paulcombuse/BadmintonAce/documentation/img/Grip+Pull_Concept_1.png

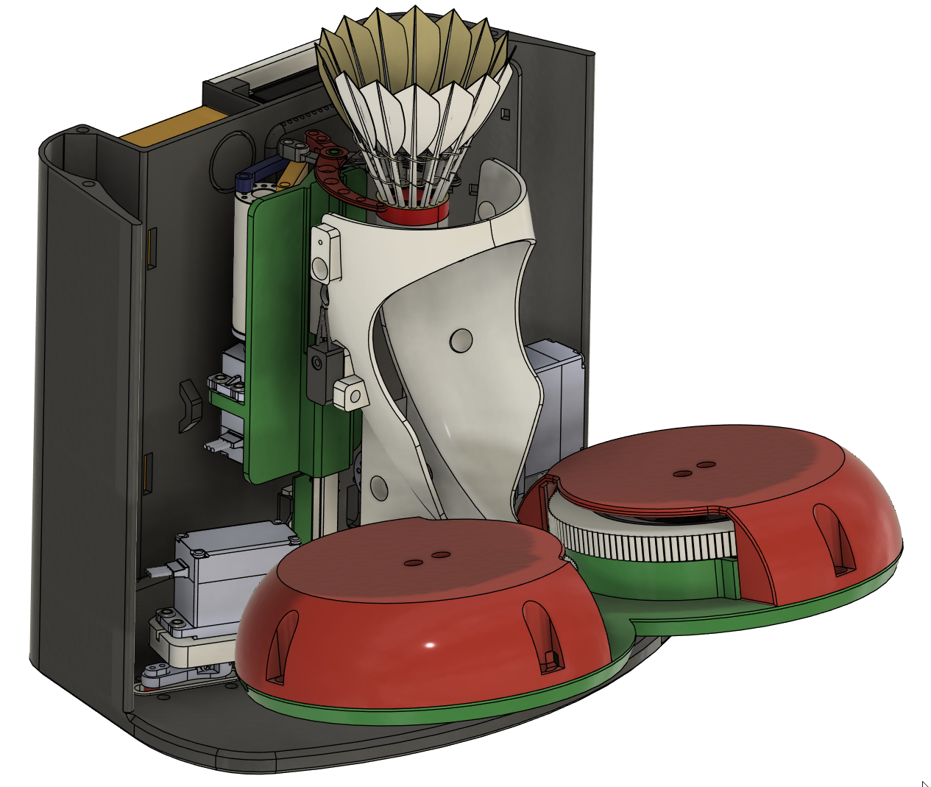
documentation/img/Grip+Pull_Concept_1.png
