paulcombuse/BadmintonAce/documentation/img/Illustration-1.png

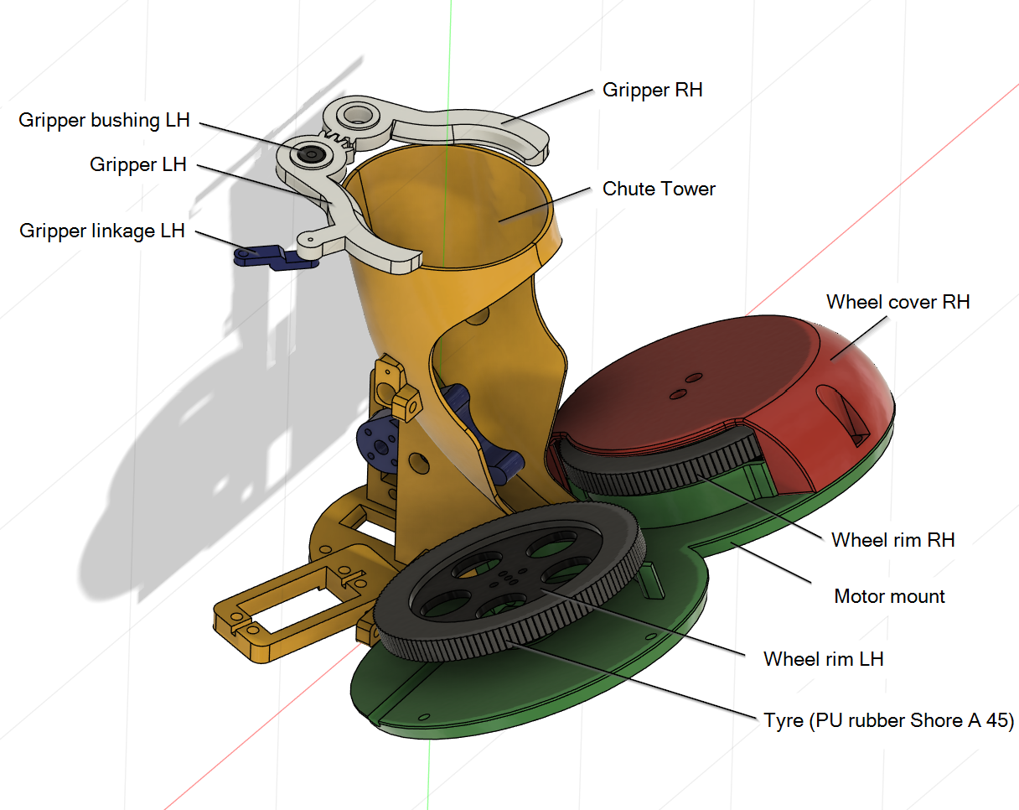
documentation/img/Illustration-1.png
