paulcombuse/BadmintonAce/documentation/img/Illustration-2.png

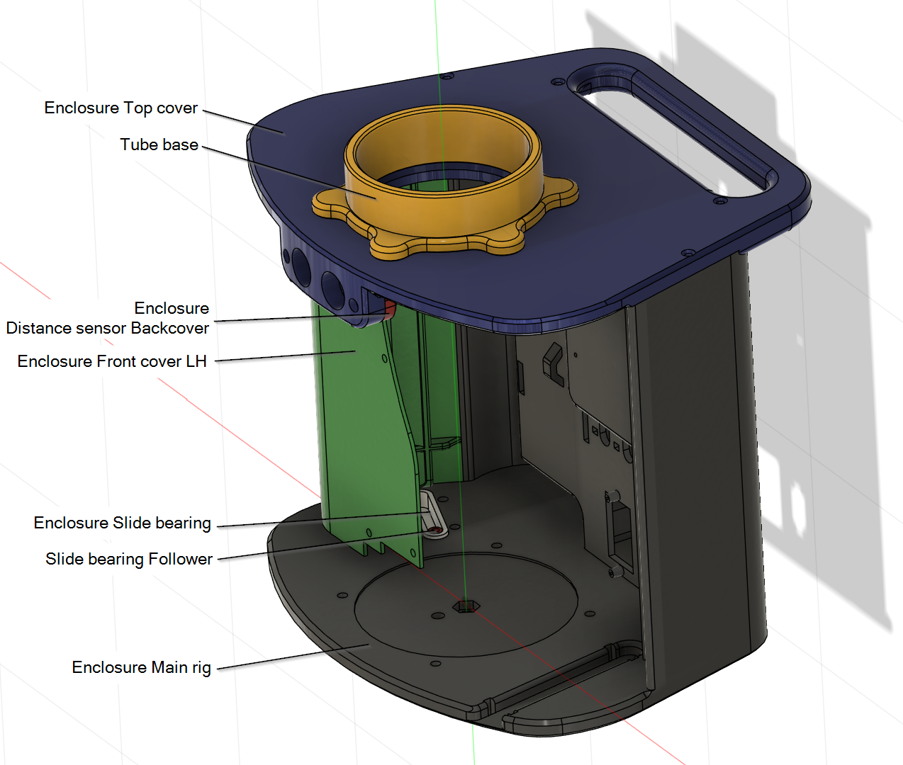
documentation/img/Illustration-2.png
