paulcombuse/BadmintonAce/documentation/img/Illustration_Overview_Backview.png

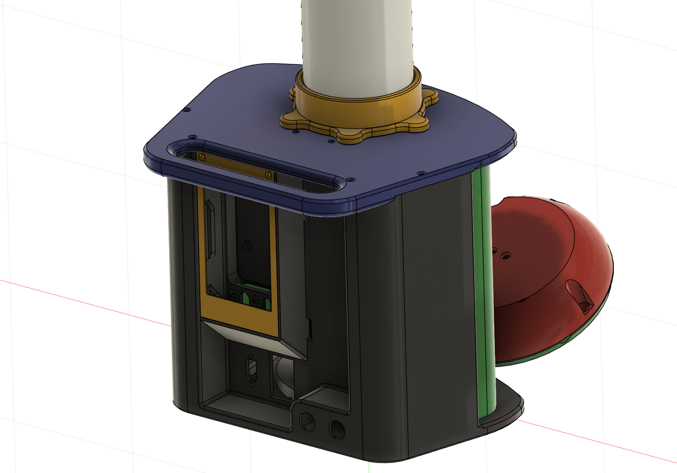
documentation/img/Illustration_Overview_Backview.png
