paulcombuse/BadmintonAce/documentation/img/Illustration_Overview_Frontview.png

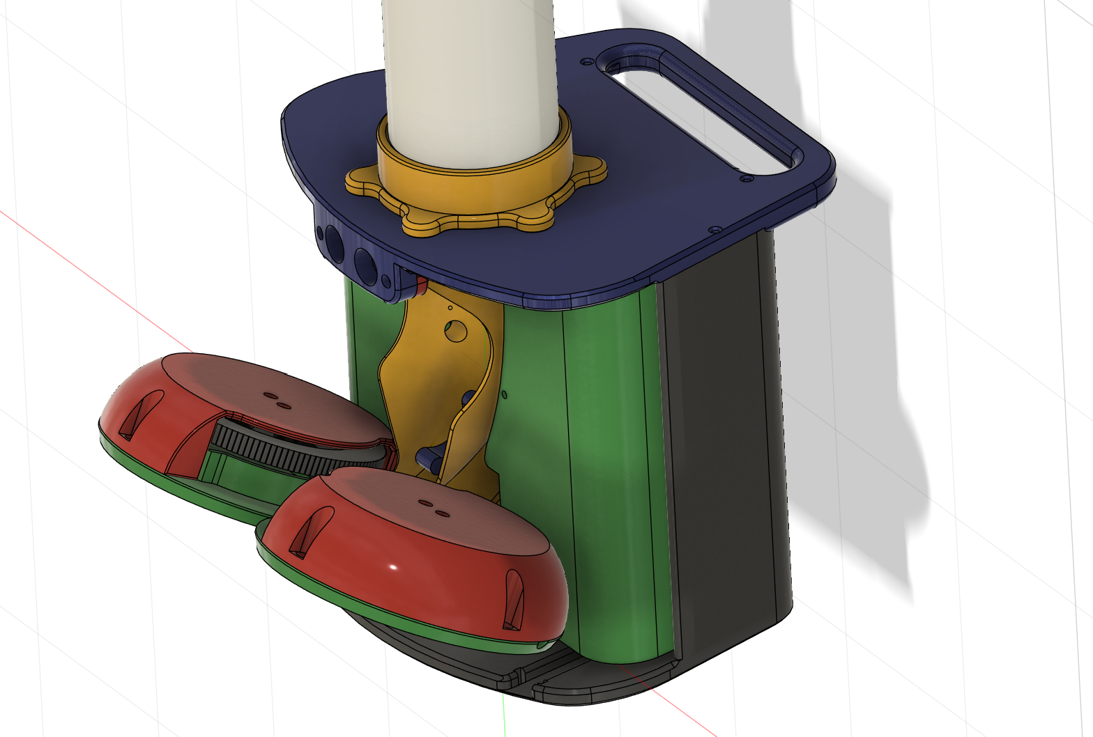
documentation/img/Illustration_Overview_Frontview.png
