paulcombuse/BadmintonAce/documentation/img/OtherConcepts/Siboasi_S4025_6.jpg

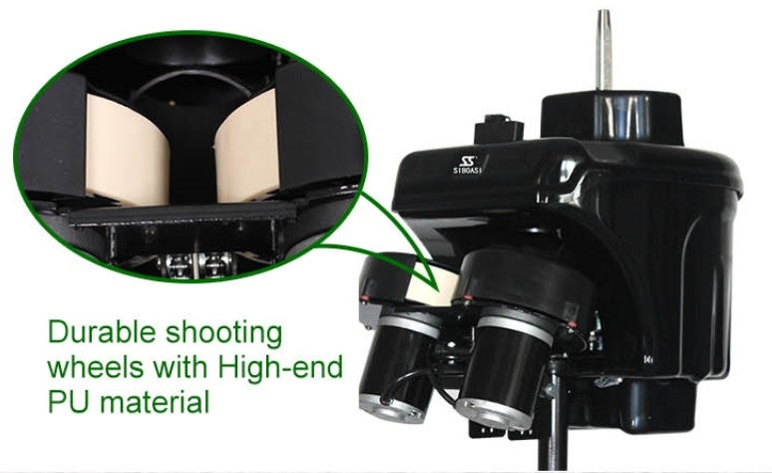
documentation/img/OtherConcepts/Siboasi_S4025_6.jpg
