paulcombuse/BadmintonAce/documentation/img/OtherConcepts/Siboasi_SS_B7_VideoSnapshot-2.png

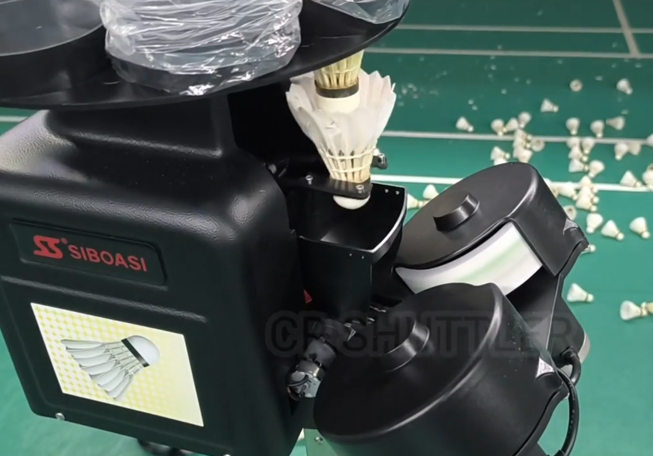
documentation/img/OtherConcepts/Siboasi_SS_B7_VideoSnapshot-2.png
