paulcombuse/BadmintonAce/documentation/img/PeterSinclair'sBadmintonACE/01.jpg

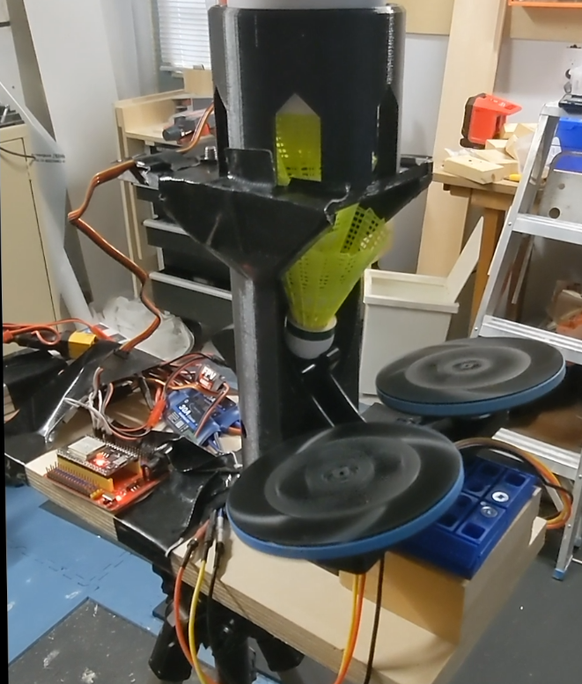
documentation/img/PeterSinclair'sBadmintonACE/01.jpg
