paulcombuse/BadmintonAce/documentation/img/PeterSinclair'sBadmintonACE/02.jpg

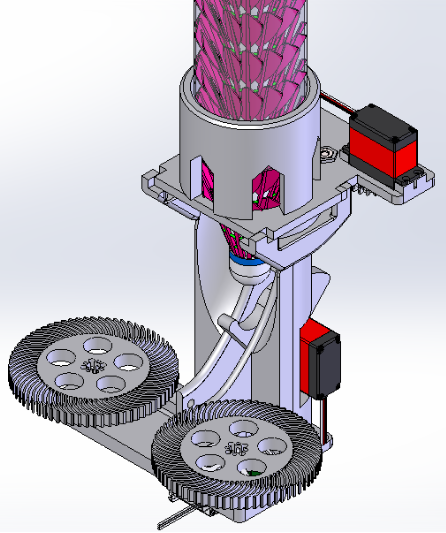
documentation/img/PeterSinclair'sBadmintonACE/02.jpg
