paulcombuse/BadmintonAce/documentation/img/PeterSinclair'sBadmintonACE/03.jpg

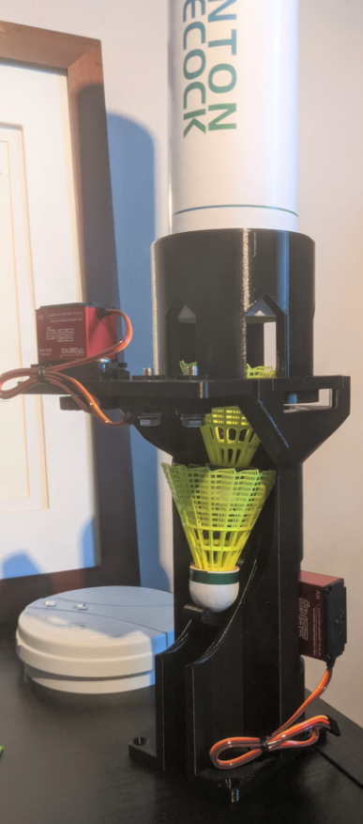
documentation/img/PeterSinclair'sBadmintonACE/03.jpg
