paulcombuse/BadmintonAce/documentation/img/PeterSinclair'sBadmintonACE/04.jpg

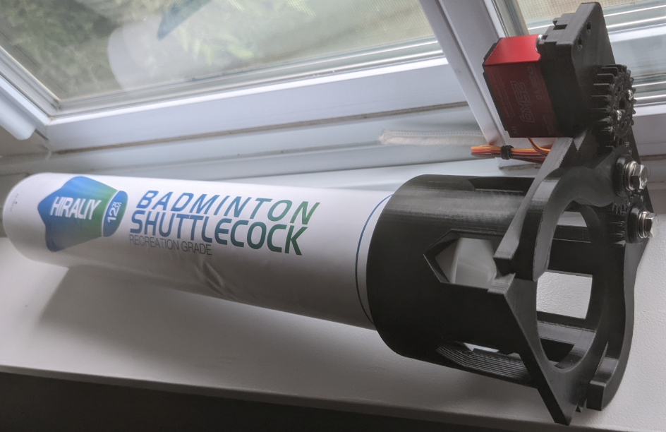
documentation/img/PeterSinclair'sBadmintonACE/04.jpg
