paulcombuse/BadmintonAce/documentation/img/PeterSinclair'sBadmintonACE/05.jpg

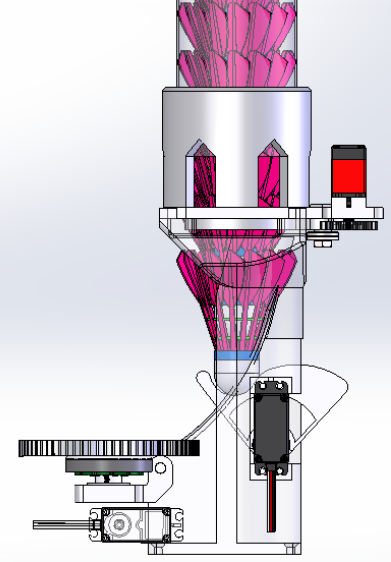
documentation/img/PeterSinclair'sBadmintonACE/05.jpg
