paulcombuse/BadmintonAce/documentation/img/PeterSinclair'sBadmintonACE/06.jpg

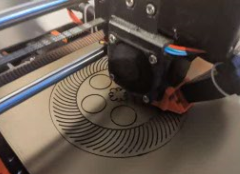
documentation/img/PeterSinclair'sBadmintonACE/06.jpg
