paulcombuse/BadmintonAce/documentation/img/PeterSinclair'sBadmintonACE/07.jpg

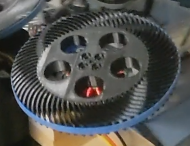
documentation/img/PeterSinclair'sBadmintonACE/07.jpg
