paulcombuse/BadmintonAce/documentation/img/PeterSinclair'sBadmintonACE/08.jpg

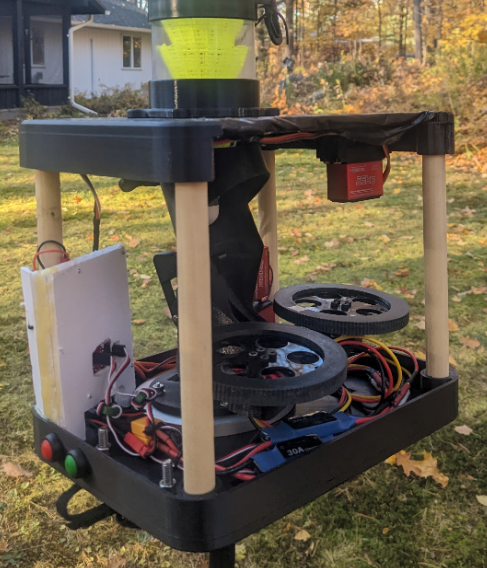
documentation/img/PeterSinclair'sBadmintonACE/08.jpg
