paulcombuse/BadmintonAce/documentation/img/PeterSinclair'sBadmintonACE/09.jpg

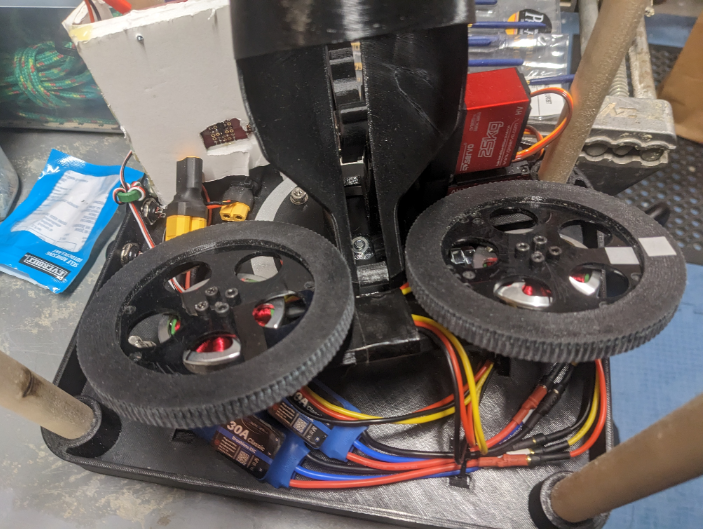
documentation/img/PeterSinclair'sBadmintonACE/09.jpg
