paulcombuse/BadmintonAce/documentation/img/PeterSinclair'sBadmintonACE/10.jpg

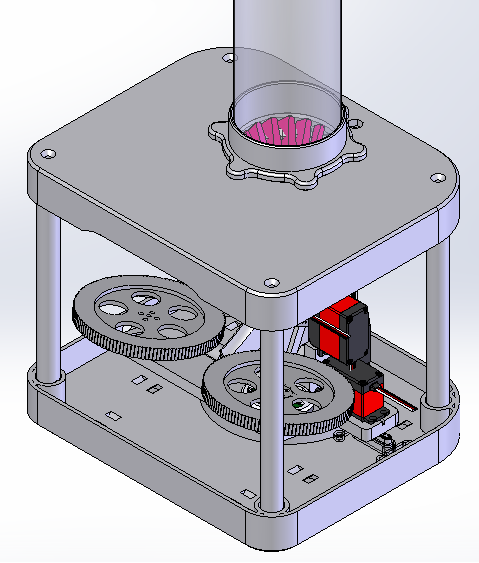
documentation/img/PeterSinclair'sBadmintonACE/10.jpg
