paulcombuse/BadmintonAce/documentation/img/PeterSinclair'sBadmintonACE/11.jpg

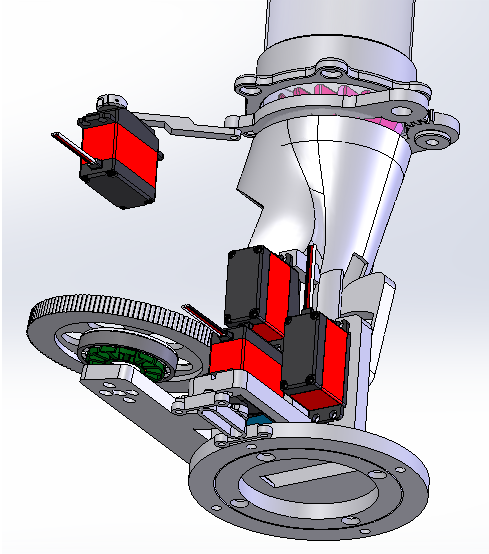
documentation/img/PeterSinclair'sBadmintonACE/11.jpg
