paulcombuse/BadmintonAce/documentation/img/PeterSinclair'sBadmintonACE/12.jpg

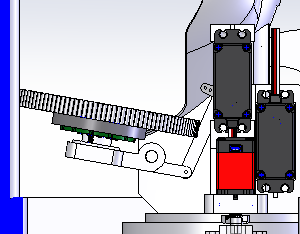
documentation/img/PeterSinclair'sBadmintonACE/12.jpg
