paulcombuse/BadmintonAce/documentation/img/PeterSinclair'sBadmintonACE/13.jpg

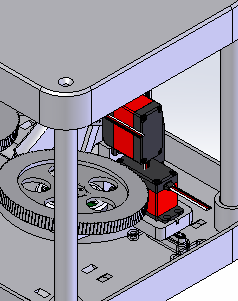
documentation/img/PeterSinclair'sBadmintonACE/13.jpg
