paulcombuse/BadmintonAce/documentation/img/PeterSinclair'sBadmintonACE/14.jpg

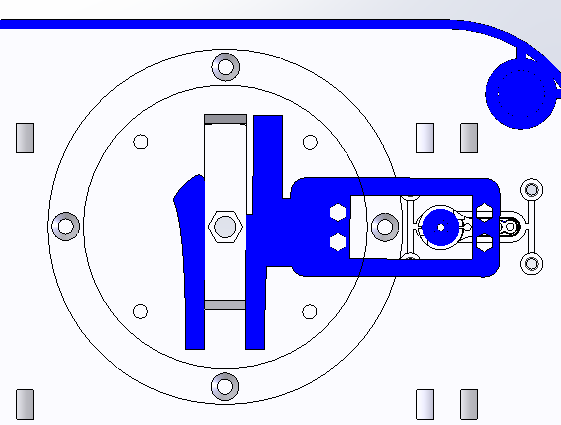
documentation/img/PeterSinclair'sBadmintonACE/14.jpg
