paulcombuse/BadmintonAce/documentation/img/PeterSinclair'sBadmintonACE/15.jpg

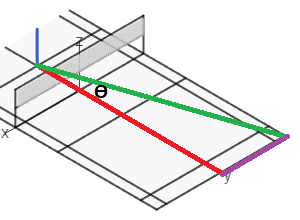
documentation/img/PeterSinclair'sBadmintonACE/15.jpg
