paulcombuse/BadmintonAce/documentation/img/PeterSinclair'sBadmintonACE/16.jpg

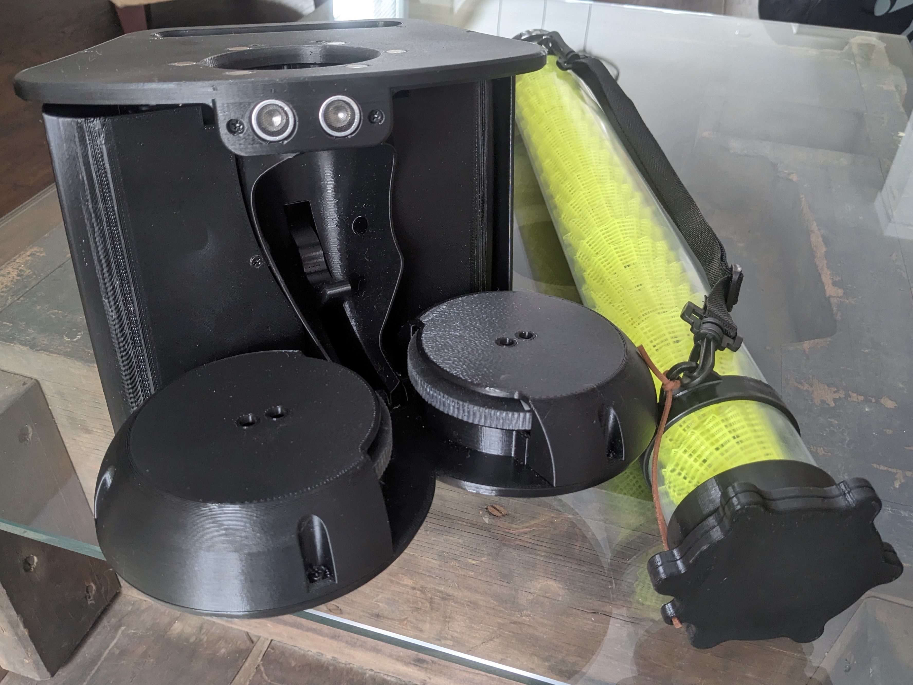
documentation/img/PeterSinclair'sBadmintonACE/16.jpg
