paulcombuse/BadmintonAce/documentation/img/PeterSinclair'sBadmintonACE/17.jpg

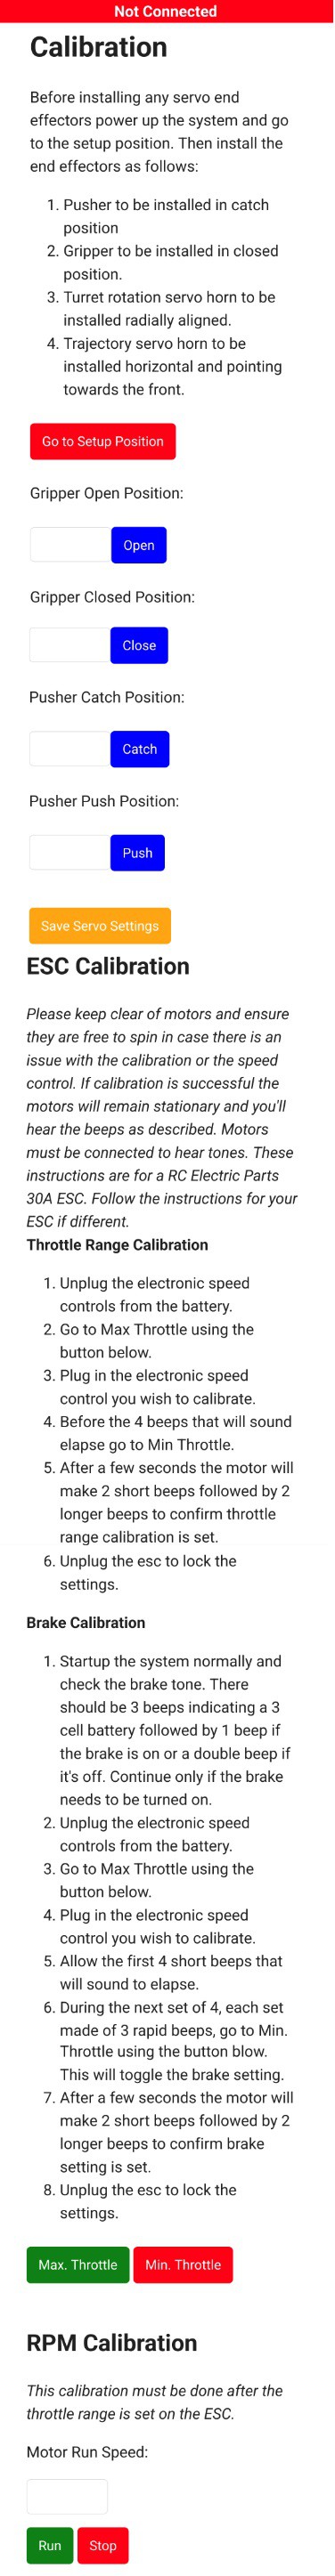
documentation/img/PeterSinclair'sBadmintonACE/17.jpg
