paulcombuse/BadmintonAce/documentation/img/PeterSinclair'sBadmintonACE/18.jpg

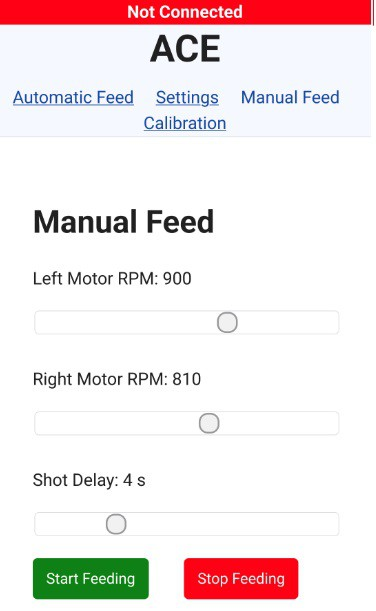
documentation/img/PeterSinclair'sBadmintonACE/18.jpg
