paulcombuse/BadmintonAce/documentation/img/PeterSinclair'sBadmintonACE/19.jpg

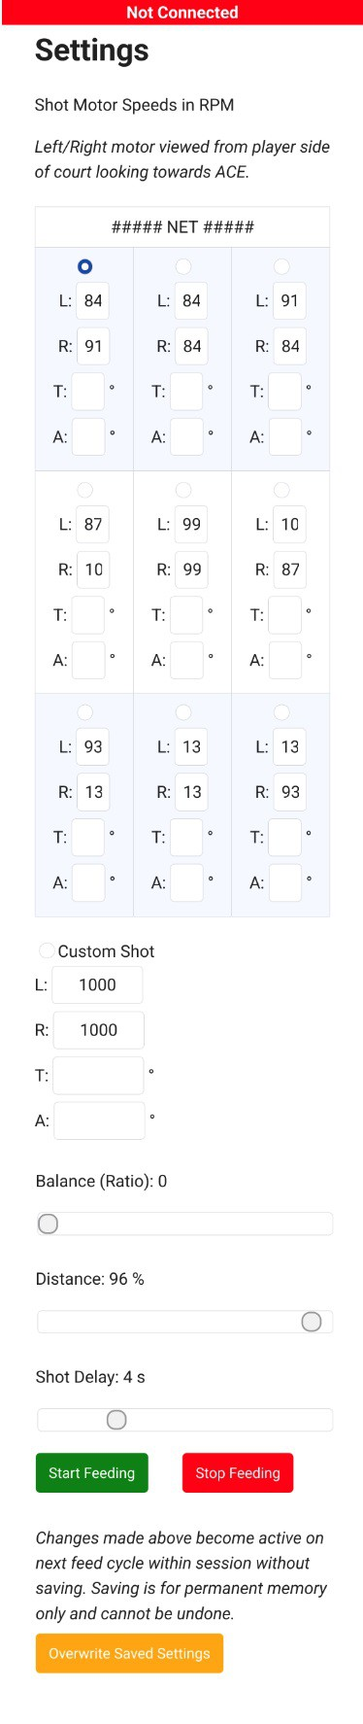
documentation/img/PeterSinclair'sBadmintonACE/19.jpg
