paulcombuse/BadmintonAce/documentation/img/PeterSinclair'sBadmintonACE/20.jpg

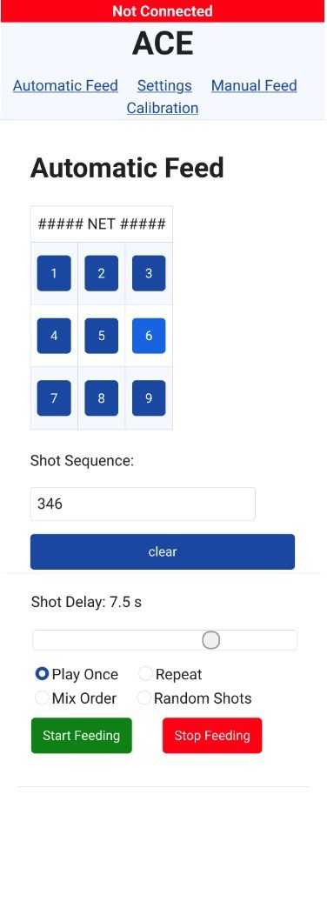
documentation/img/PeterSinclair'sBadmintonACE/20.jpg
