paulcombuse/BadmintonAce/documentation/img/PeterSinclair'sBadmintonACE/21.jpg

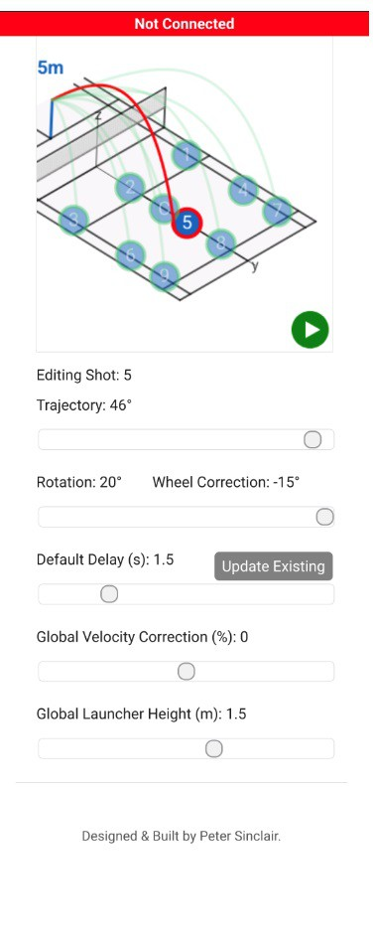
documentation/img/PeterSinclair'sBadmintonACE/21.jpg
