paulcombuse/BadmintonAce/documentation/img/PeterSinclair'sBadmintonACE/22.jpg

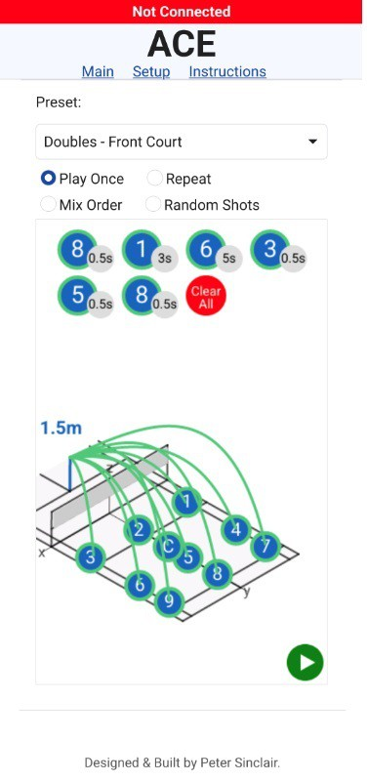
documentation/img/PeterSinclair'sBadmintonACE/22.jpg
