paulcombuse/BadmintonAce/documentation/img/PeterSinclair'sBadmintonACE/23.jpg

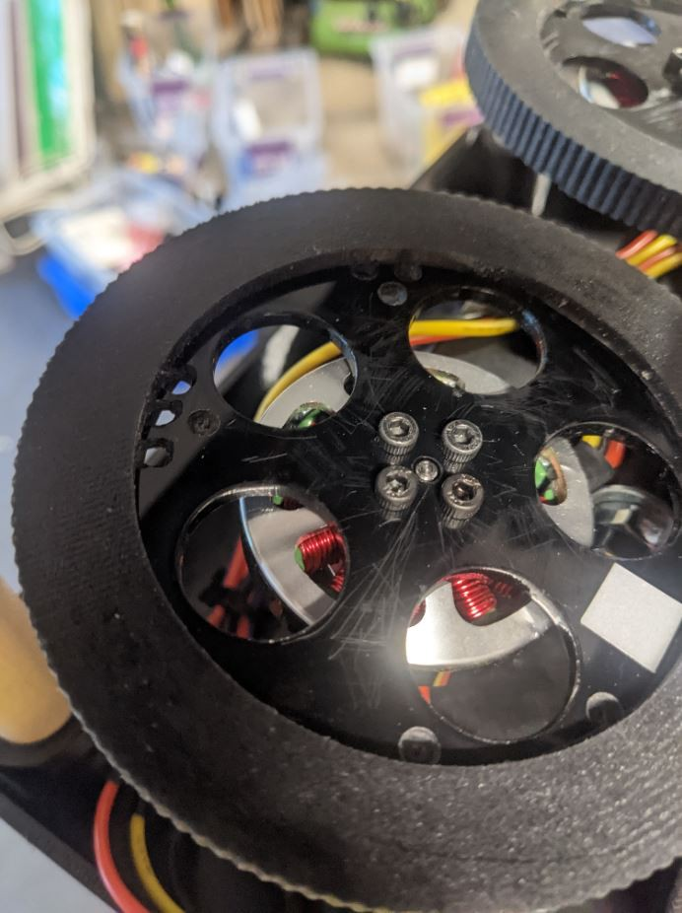
documentation/img/PeterSinclair'sBadmintonACE/23.jpg
