paulcombuse/BadmintonAce/documentation/img/PeterSinclair'sBadmintonACE/24.jpg

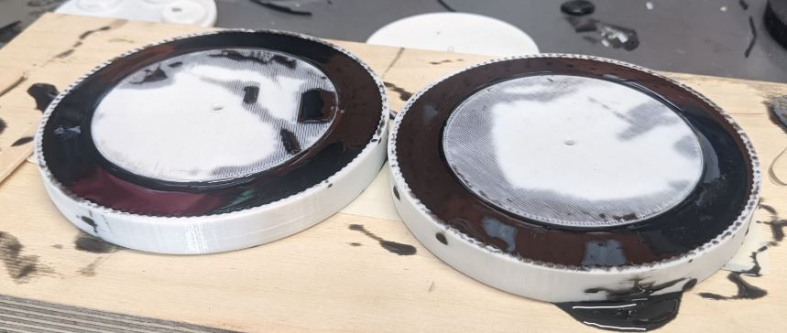
documentation/img/PeterSinclair'sBadmintonACE/24.jpg
