paulcombuse/BadmintonAce/documentation/img/PeterSinclair'sBadmintonACE/25.jpg

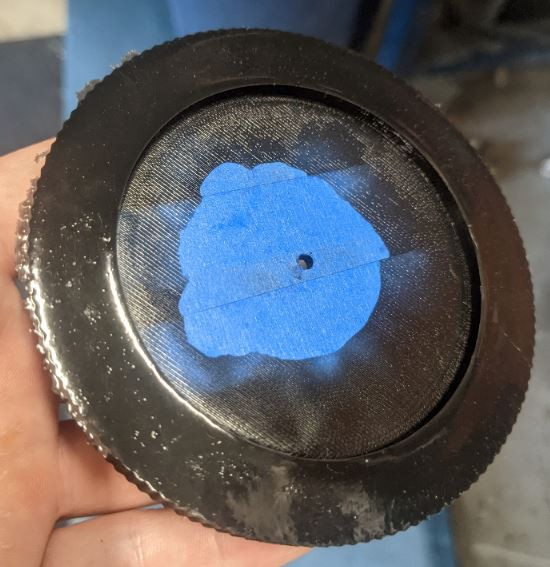
documentation/img/PeterSinclair'sBadmintonACE/25.jpg
