paulcombuse/BadmintonAce/documentation/img/PeterSinclair'sBadmintonACE/26.jpg

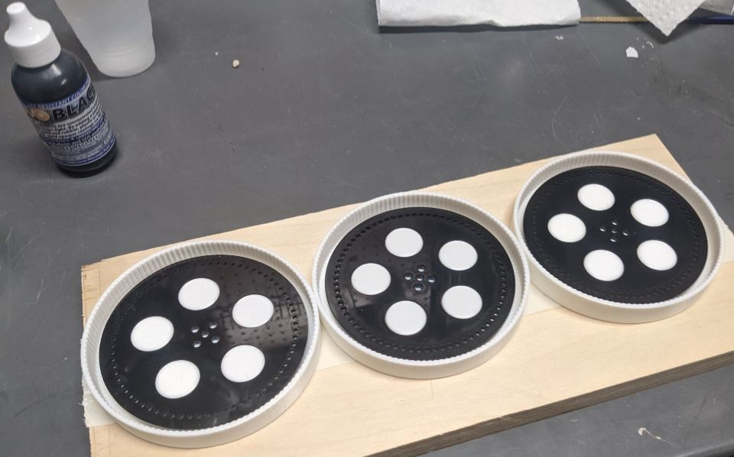
documentation/img/PeterSinclair'sBadmintonACE/26.jpg
