paulcombuse/BadmintonAce/cad/2x ACE_Wheel_Assembly_LH&RH_Rev2_2materials.step

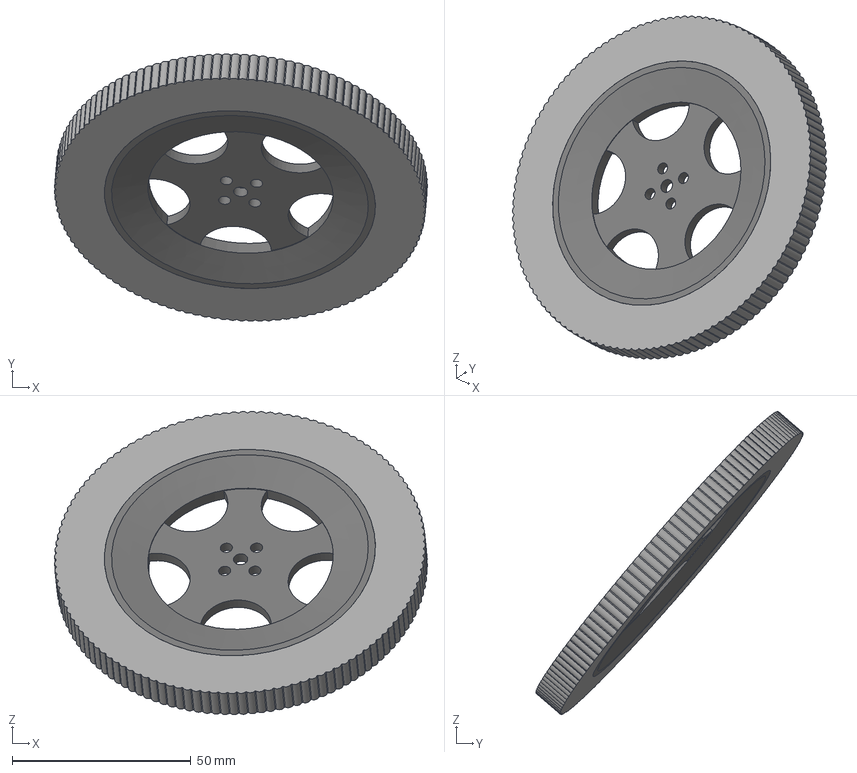
[picture p51: CAD file, 2026-11-03]
cad/2x ACE_Wheel_Assembly_LH&RH_Rev2_2materials.step
104.4 x 74.8 x 84.8 mm
