paulcombuse/BadmintonAce/cad/ACE D4 ASSEMBLY 2023-09-11.stl

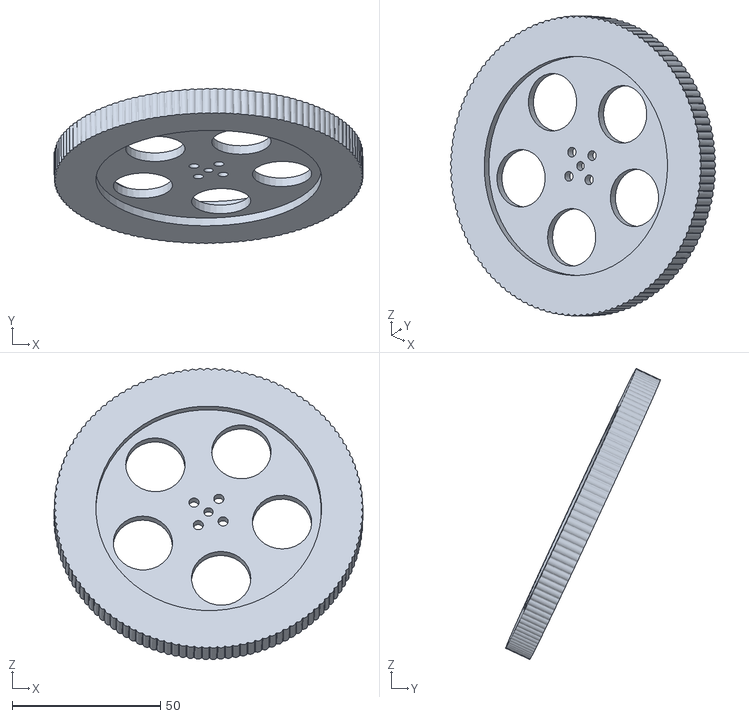
[picture p52: CAD file, 2026-11-03]
cad/ACE D4 ASSEMBLY 2023-09-11.stl
104.1 x 52.2 x 98.0
