paulcombuse/BadmintonAce/cad/ACE_Enclosure_MainRig_Rev3.step

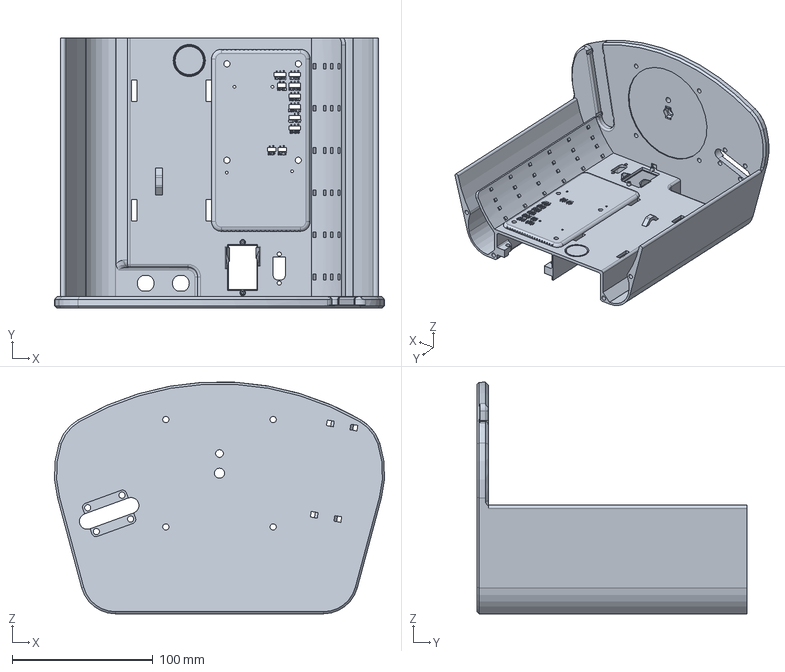
[picture p53: CAD file, 2026-11-03]
cad/ACE_Enclosure_MainRig_Rev3.step
234.7 x 192.0 x 164.8 mm
