paulcombuse/BadmintonAce/cad/ACE_Enclosure_TopCover_Rev3.step

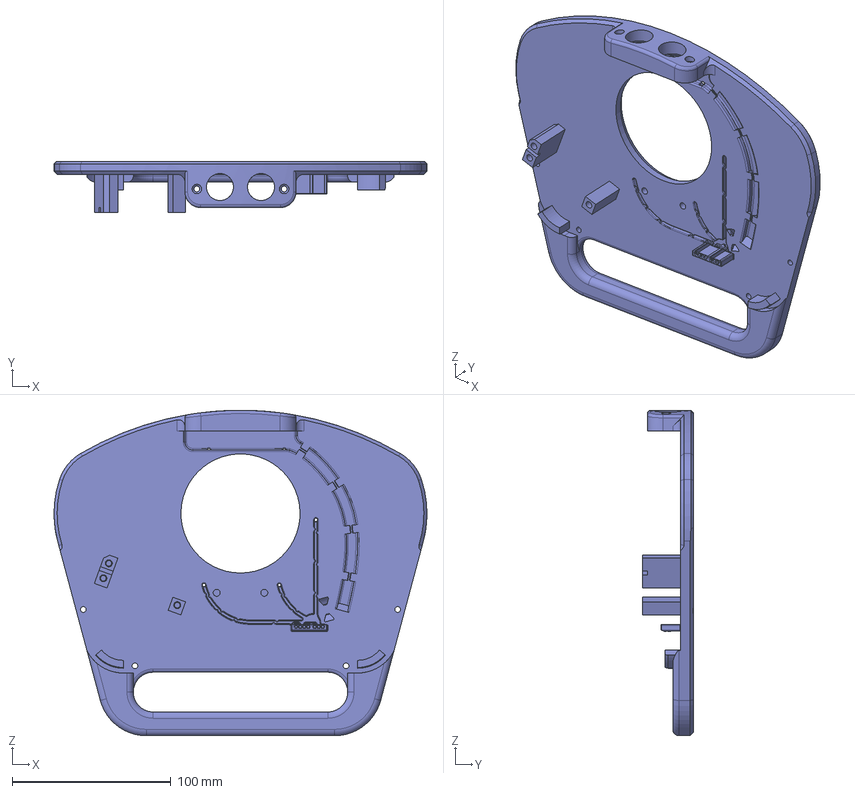
[picture p54: CAD file, 2026-11-13]
cad/ACE_Enclosure_TopCover_Rev3.step
235.0 x 32.0 x 205.0 mm
