paulcombuse/BadmintonAce/pcb/AdditionalParts/XT60PB-F.stp

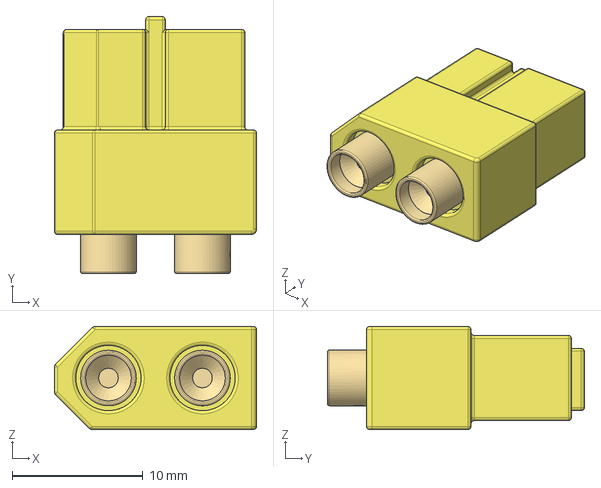
[picture p55: CAD file, 2026-11-08]
pcb/AdditionalParts/XT60PB-F.stp
15.5 x 19.7 x 7.90 mm
