paulcombuse/BadmintonAce/cad/ACE_Pusher_Rev3.step

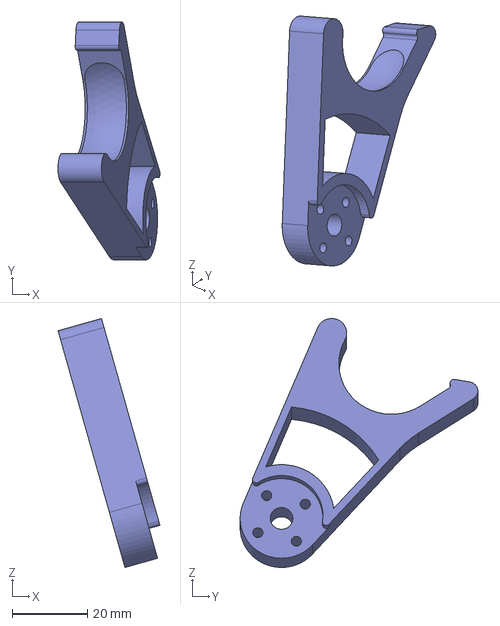
[picture p56: CAD file, 2026-11-13]
cad/ACE_Pusher_Rev3.step
27.1 x 63.1 x 66.1 mm
