paulcombuse/BadmintonAce/pcb/AdditionalParts/XT60PB-M.stp

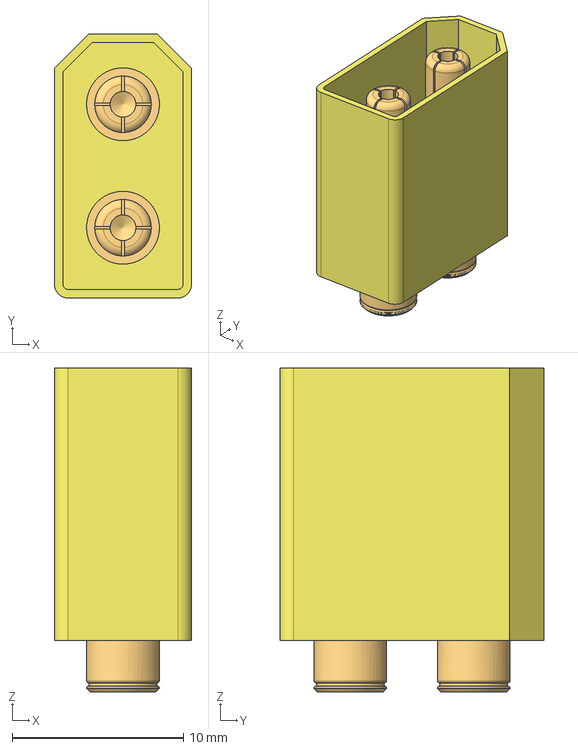
[picture p57: CAD file, 2026-11-08]
pcb/AdditionalParts/XT60PB-M.stp
8.00 x 15.4 x 18.9 mm
