paulcombuse/BadmintonAce/cad/ACE_Tube_Base_Rev2-illuminated_Insert_PullConcept.step

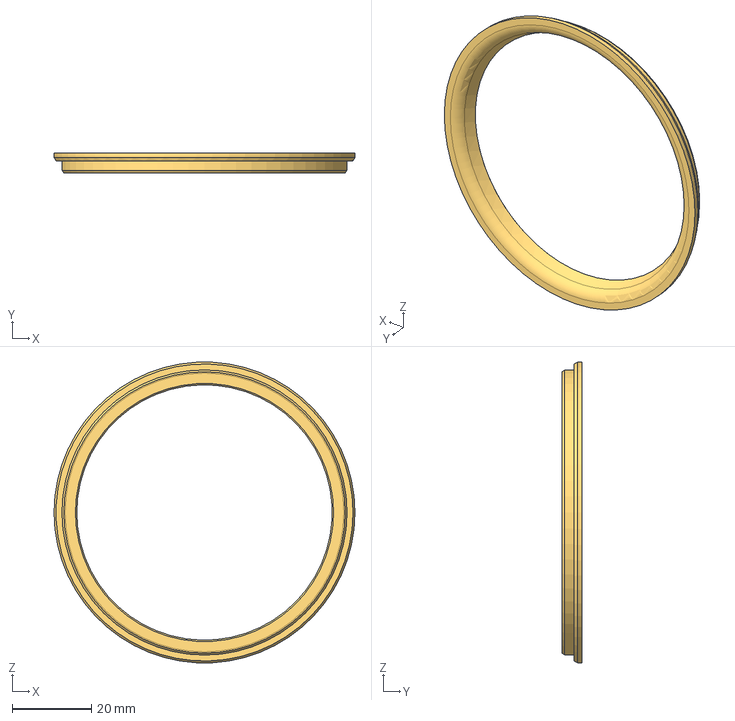
[picture p58: CAD file, 2026-11-08]
cad/ACE_Tube_Base_Rev2-illuminated_Insert_PullConcept.step
75.8 x 5.02 x 75.7 mm
