paulcombuse/BadmintonAce/cad/ACE_Tube_Base_Rev2-illuminated.step

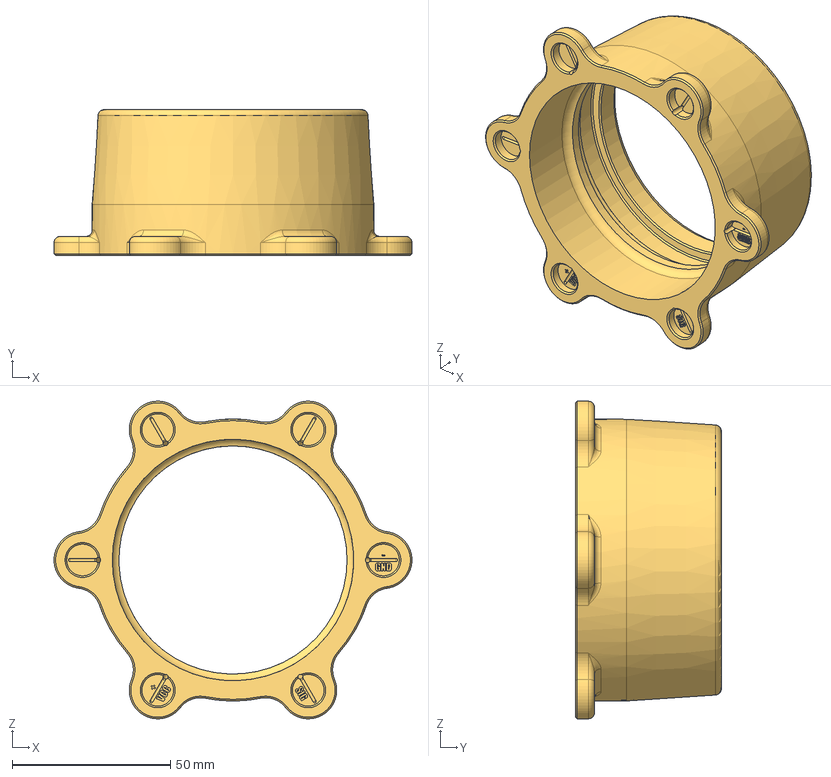
[picture p59: CAD file, 2026-11-08]
cad/ACE_Tube_Base_Rev2-illuminated.step
113.0 x 46.0 x 100.3 mm
