paulcombuse/BadmintonAce/cad/ACE_Tube_Inlet_Rev0.step

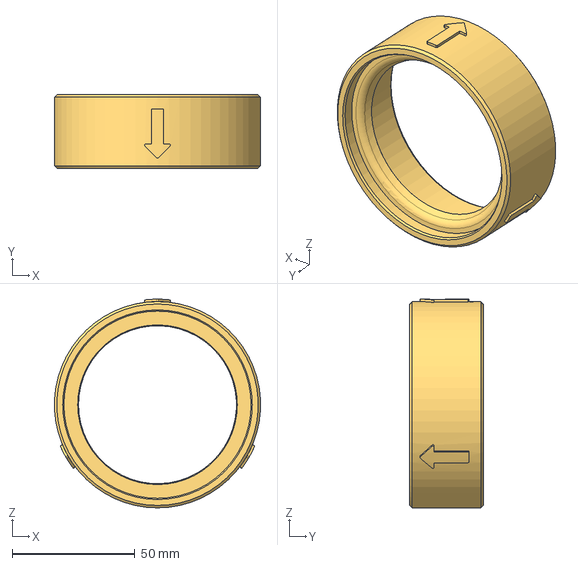
[picture p60: CAD file, 2026-11-08]
cad/ACE_Tube_Inlet_Rev0.step
83.9 x 30.0 x 85.0 mm
