paulcombuse/BadmintonAce/cad/ACE_ChuteTower-Carriage_Rev0.step

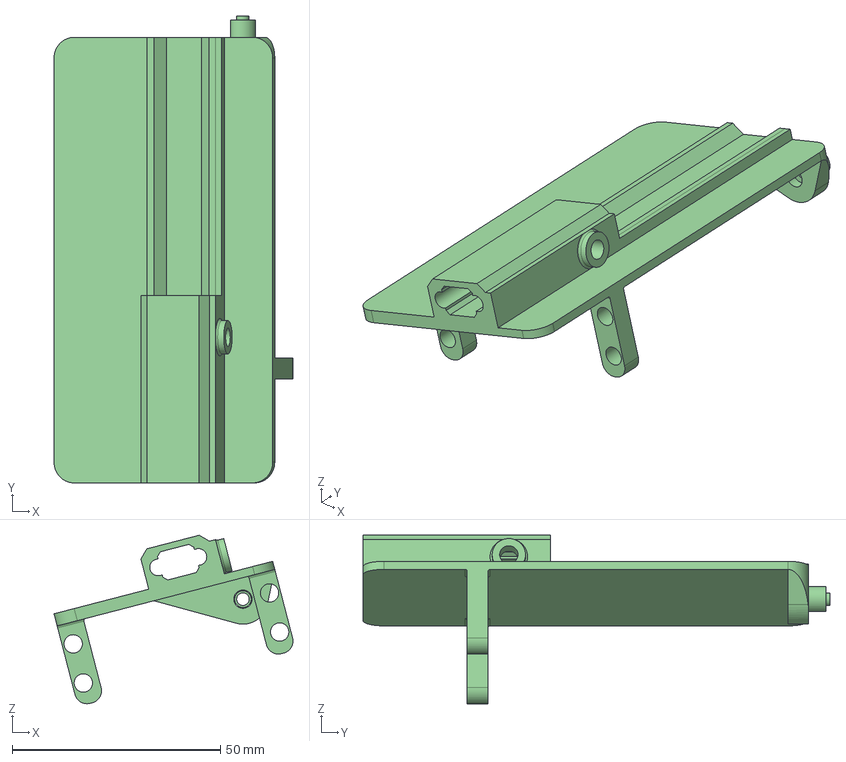
[picture p61: CAD file, 2026-11-08]
cad/ACE_ChuteTower-Carriage_Rev0.step
57.4 x 112.1 x 40.5 mm
