paulcombuse/BadmintonAce/cad/ACE_ChuteTower_Rev1.step

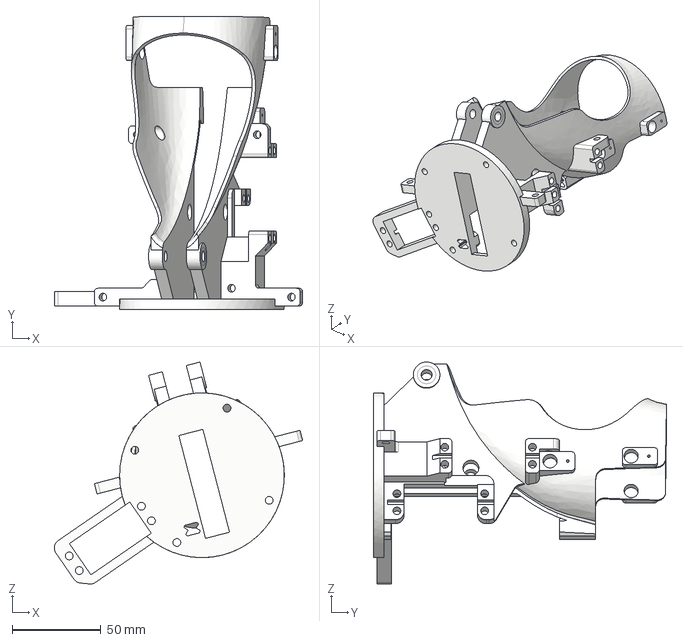
[picture p62: CAD file, 2026-11-08]
cad/ACE_ChuteTower_Rev1.step
140.3 x 165.5 x 125.3 mm
