paulcombuse/BadmintonAce/cad/2x ACE_GripperBushing-LH&RH_Rev1.step

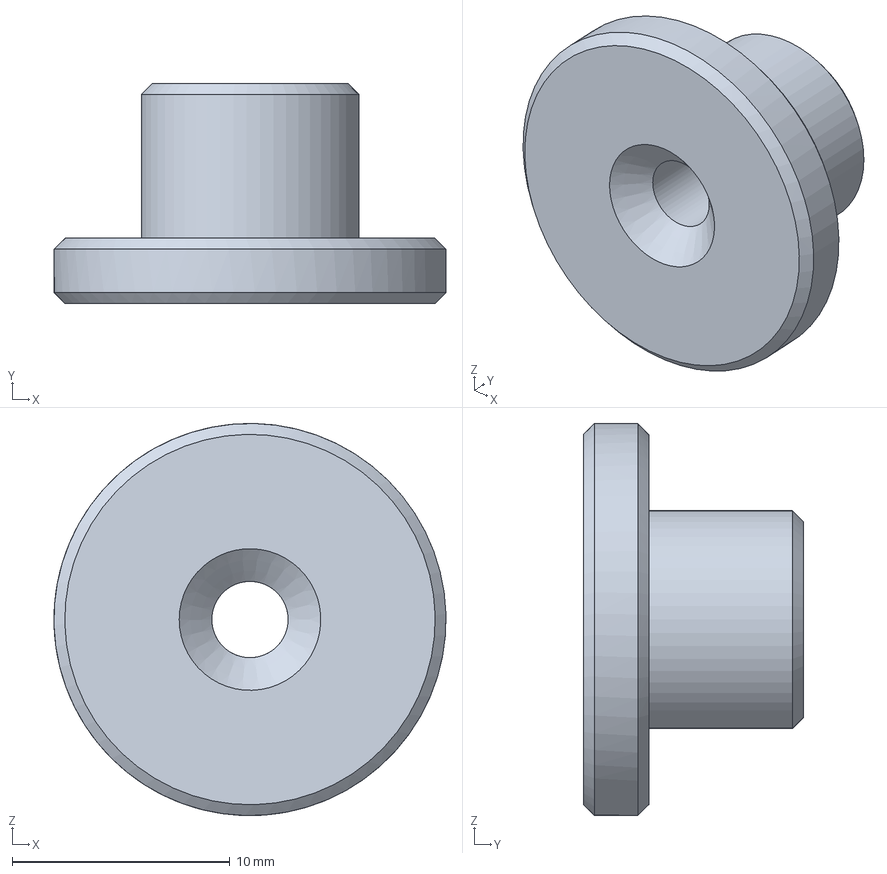
[picture p63: CAD file, 2026-11-05]
cad/2x ACE_GripperBushing-LH&RH_Rev1.step
18.0 x 10.1 x 18.0 mm
