paulcombuse/BadmintonAce/cad/ACE_GripperLinkage_Rev2.step

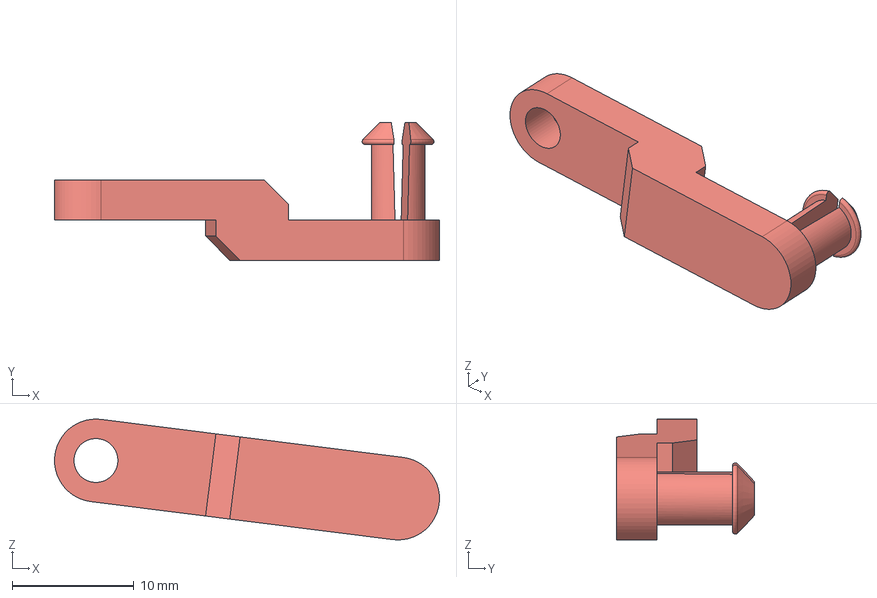
[picture p64: CAD file, 2026-11-05]
cad/ACE_GripperLinkage_Rev2.step
31.6 x 11.3 x 9.92 mm
