paulcombuse/BadmintonAce/cad/ACE_SlideBearing_Follower_Rev1.step

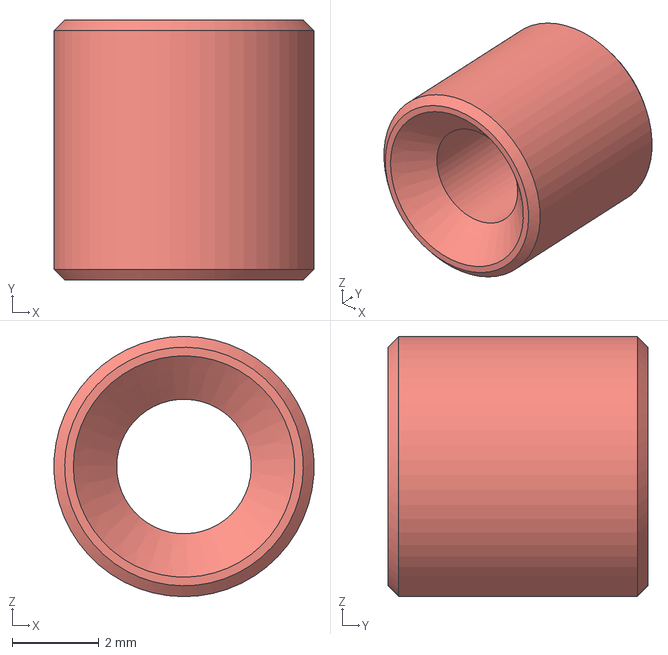
[picture p65: CAD file, 2026-11-03]
cad/ACE_SlideBearing_Follower_Rev1.step
5.99 x 6.00 x 6.00 mm
