paulcombuse/BadmintonAce/cad/ACE_Gripper-TorsionLinkage_Rev0.step

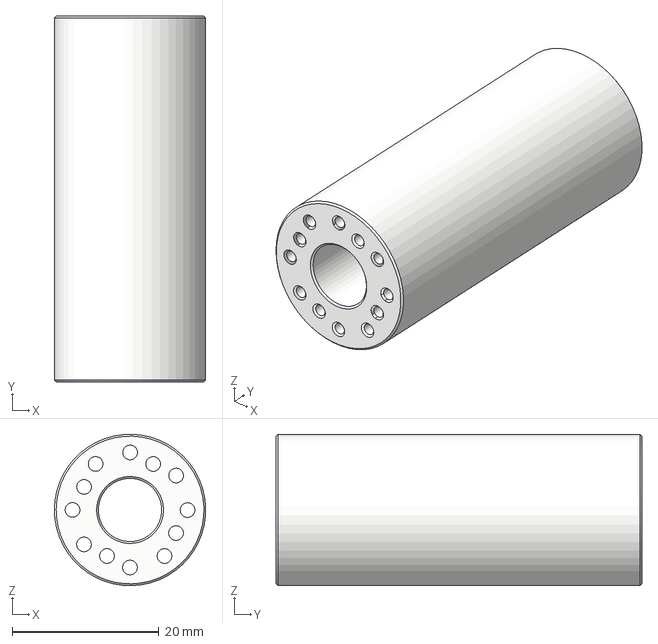
[picture p66: CAD file, 2026-11-03]
cad/ACE_Gripper-TorsionLinkage_Rev0.step
20.6 x 49.8 x 20.6 mm
