paulcombuse/BadmintonAce/cad/2x ACE_WheelCover_LH&RH_Rev1.step

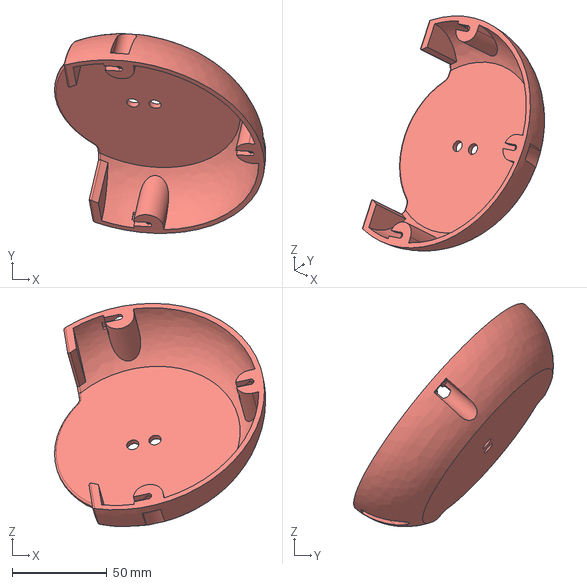
[picture p67: CAD file, 2026-11-03]
cad/2x ACE_WheelCover_LH&RH_Rev1.step
111.1 x 105.2 x 117.6 mm
