paulcombuse/BadmintonAce/cad/ACE_MotorMount_Shaft_Rev0.step

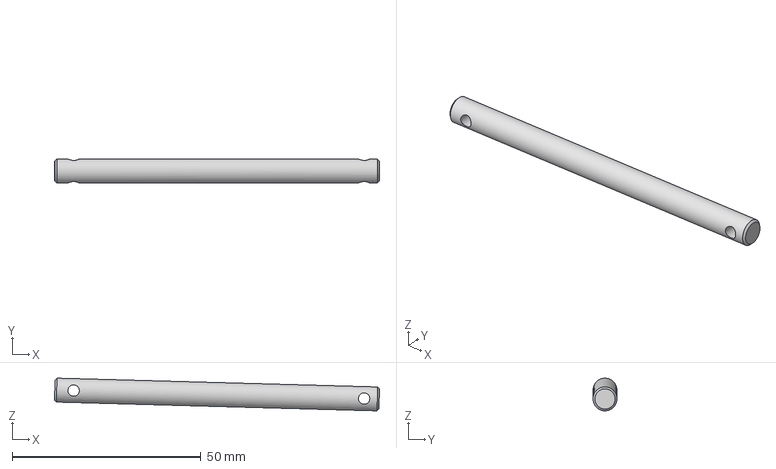
[picture p68: CAD file, 2026-11-03]
cad/ACE_MotorMount_Shaft_Rev0.step
86.1 x 6.35 x 8.68 mm
