paulcombuse/BadmintonAce/cad/ACE_Tube_Base_Rev2-illuminized.step

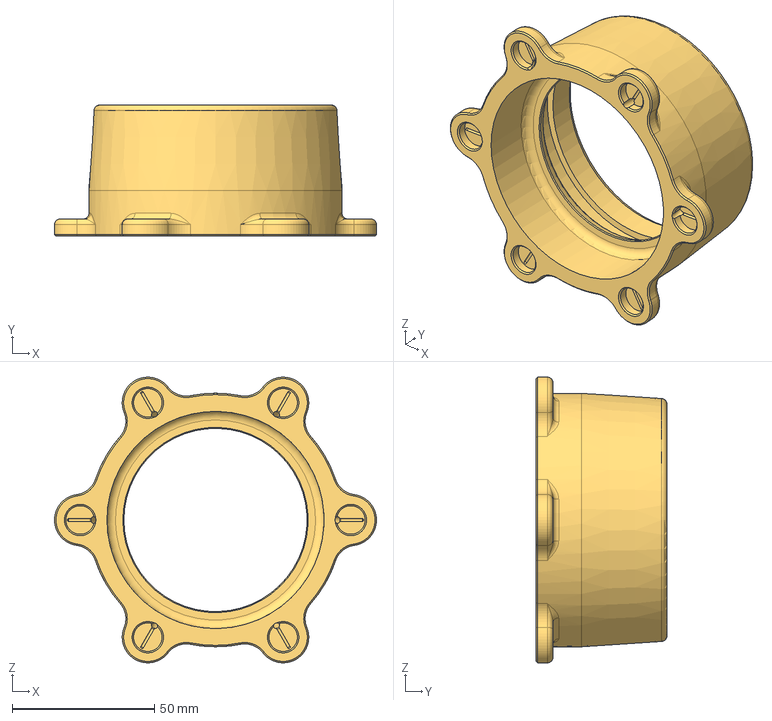
[picture p69: CAD file, 2026-11-03]
cad/ACE_Tube_Base_Rev2-illuminized.step
113.0 x 46.0 x 100.3 mm
