paulcombuse/BadmintonAce/cad/2x ACE_WheelRim_LH&RH_Rev0.step

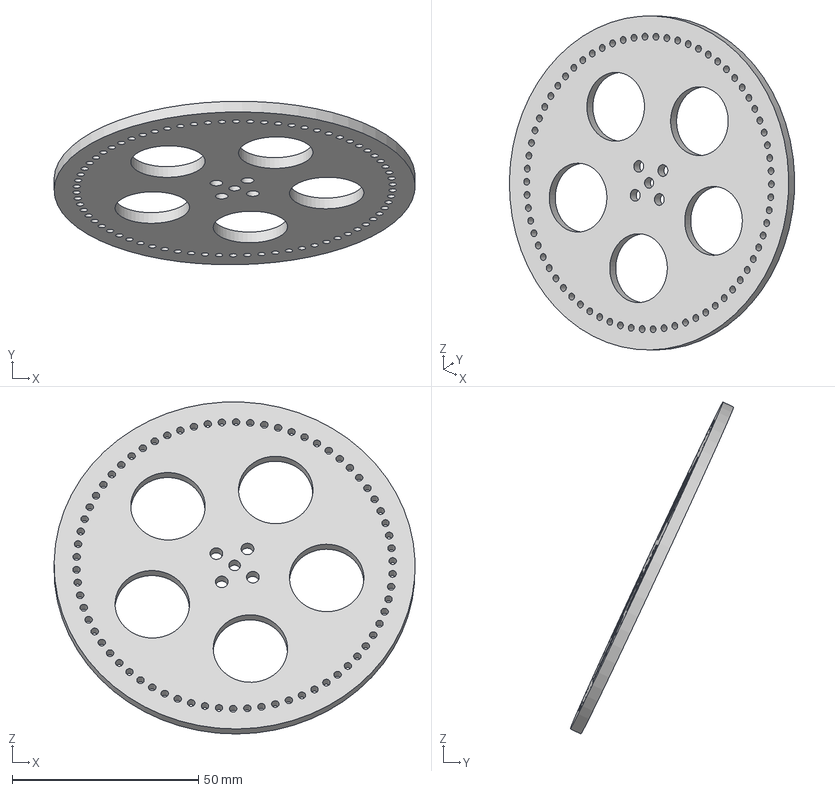
[picture p70: CAD file, 2026-11-03]
cad/2x ACE_WheelRim_LH&RH_Rev0.step
97.0 x 43.9 x 89.2 mm
