paulcombuse/BadmintonAce/cad/ACE_Enclosure_Cover-CircuitBoard-with-TFT_Rev3.step

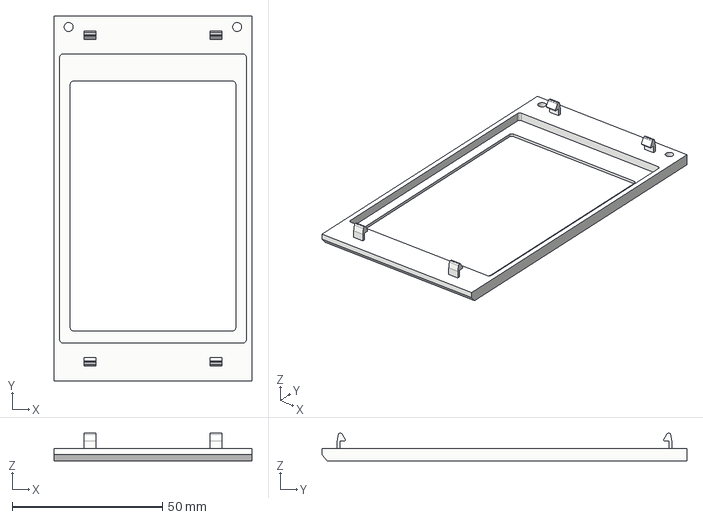
[picture p71: CAD file, 2026-11-03]
cad/ACE_Enclosure_Cover-CircuitBoard-with-TFT_Rev3.step
65.8 x 121.3 x 9.15 mm
