paulcombuse/BadmintonAce/cad/ACE_GripperArm-RH_Rev1.step

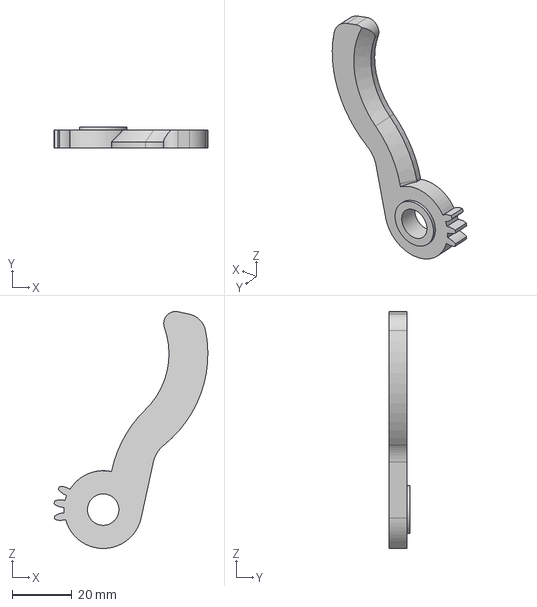
[picture p72: CAD file, 2026-11-03]
cad/ACE_GripperArm-RH_Rev1.step
51.4 x 7.00 x 79.2 mm
