paulcombuse/BadmintonAce/cad/ACE_Tyre_Mould_Inlay_Rev0.step

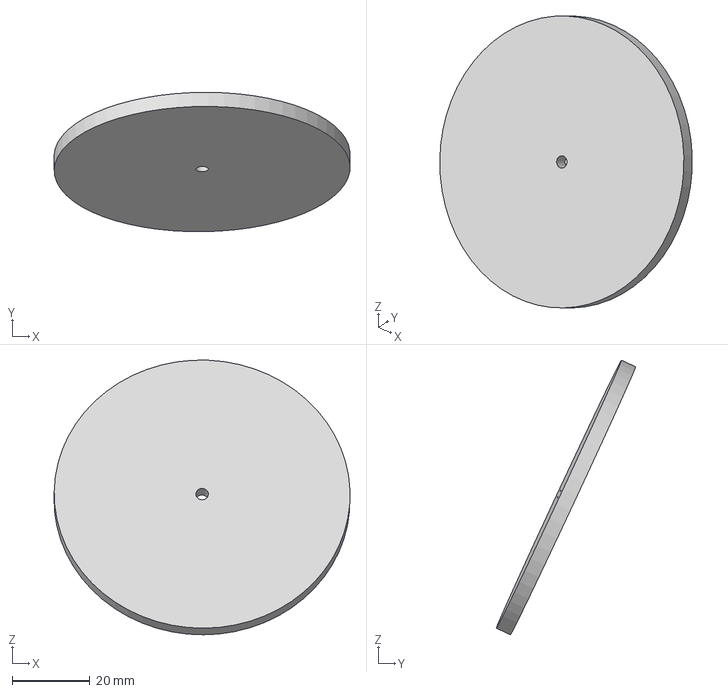
[picture p73: CAD file, 2026-11-03]
cad/ACE_Tyre_Mould_Inlay_Rev0.step
76.0 x 35.8 x 70.5 mm
