paulcombuse/BadmintonAce/cad/ACE_Shaft_AxialLock_Rev0.step

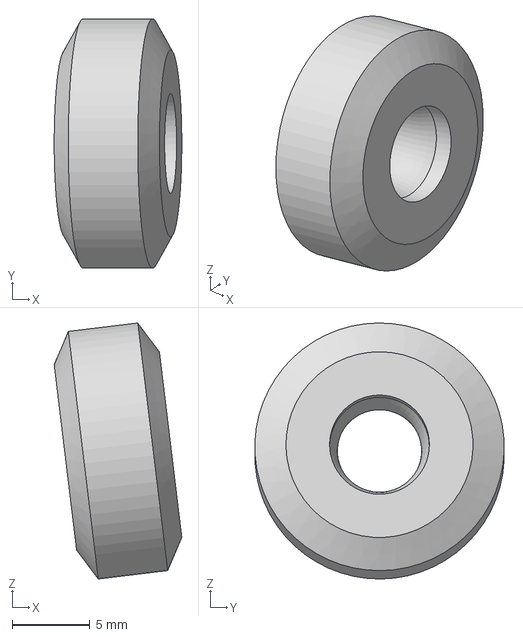
[picture p74: CAD file, 2026-11-03]
cad/ACE_Shaft_AxialLock_Rev0.step
8.19 x 16.0 x 16.4 mm
