paulcombuse/BadmintonAce/cad/ACE_Trajectory_Linkage_Rev1.step

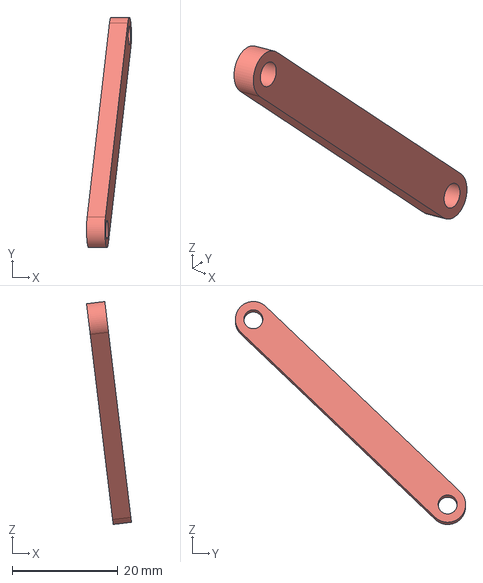
[picture p75: CAD file, 2026-11-03]
cad/ACE_Trajectory_Linkage_Rev1.step
8.52 x 43.6 x 42.2 mm
