paulcombuse/BadmintonAce/cad/ACE_TripodMount_Rev2.step

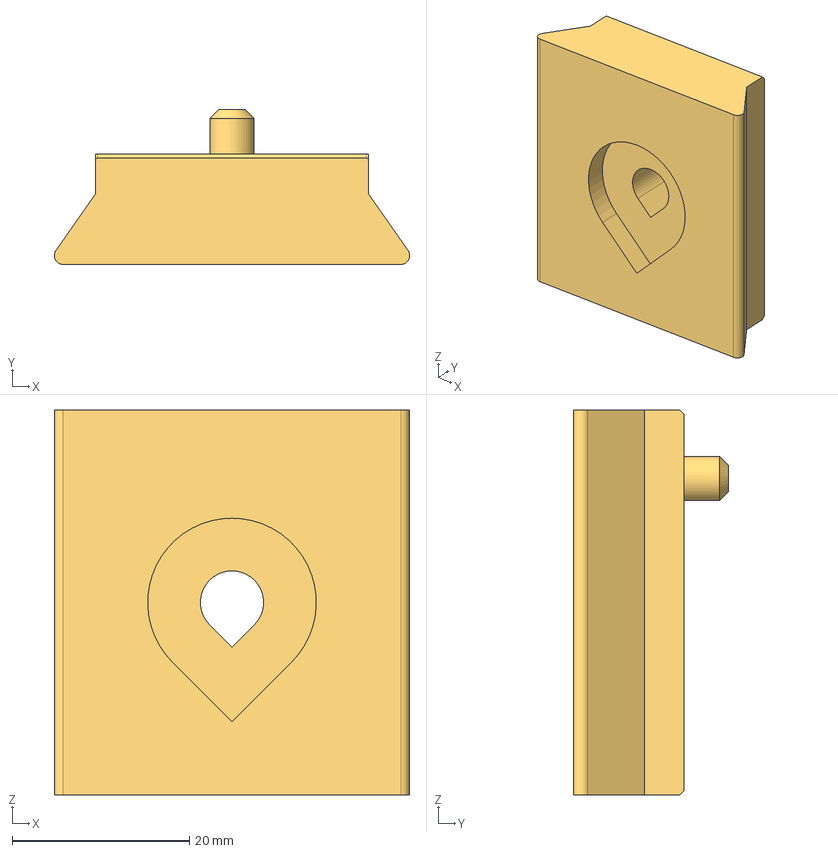
[picture p76: CAD file, 2026-11-03]
cad/ACE_TripodMount_Rev2.step
40.2 x 17.5 x 43.5 mm
