paulcombuse/BadmintonAce/cad/ACE_Enclosure_Cover-CircuitBoard_Rev2.step

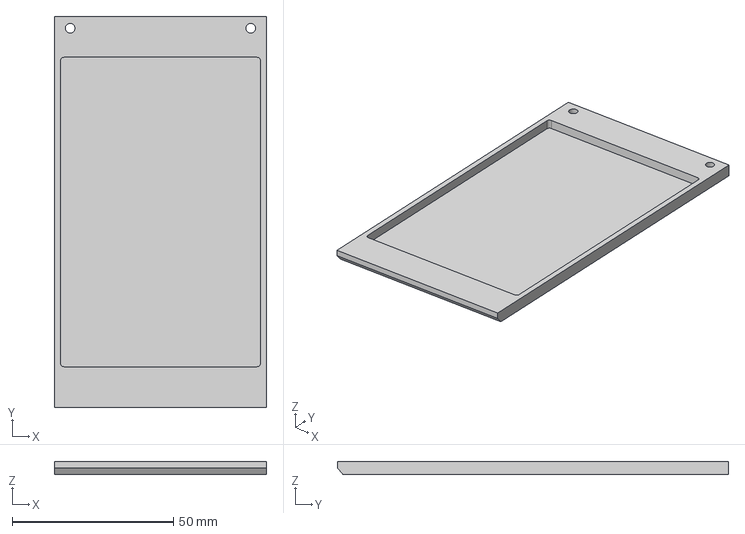
[picture p77: CAD file, 2026-11-03]
cad/ACE_Enclosure_Cover-CircuitBoard_Rev2.step
65.8 x 121.3 x 4.00 mm
