paulcombuse/BadmintonAce/cad/ACE_Tube_Base_Rev1.step

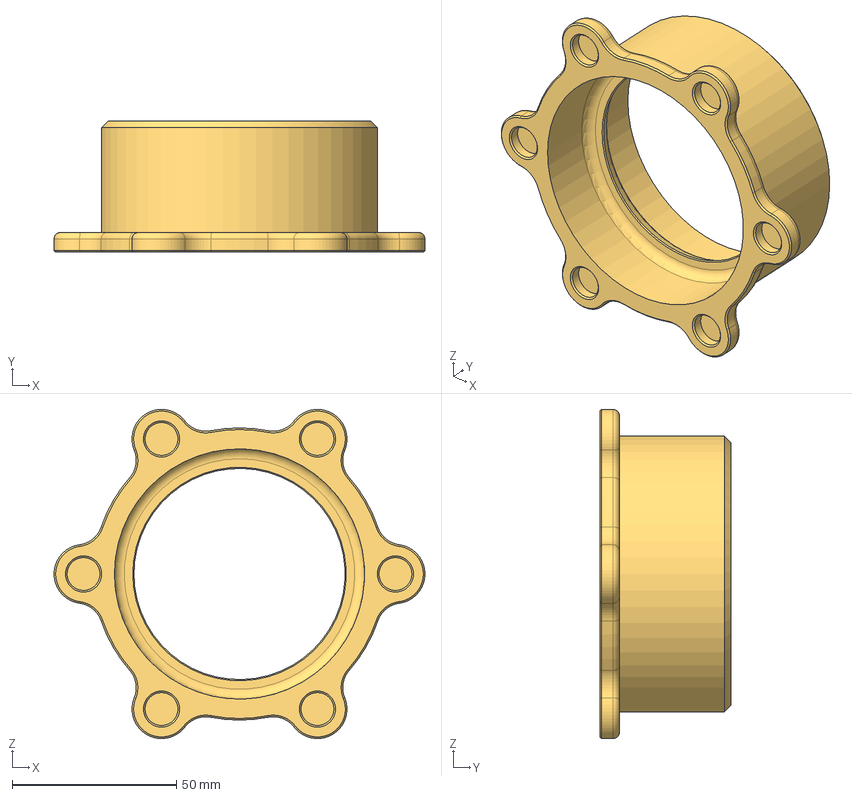
[picture p78: CAD file, 2026-11-03]
cad/ACE_Tube_Base_Rev1.step
113.0 x 40.0 x 100.3 mm
