paulcombuse/BadmintonAce/cad/ACE_Enclosure_SlideBearing_Rev2.step

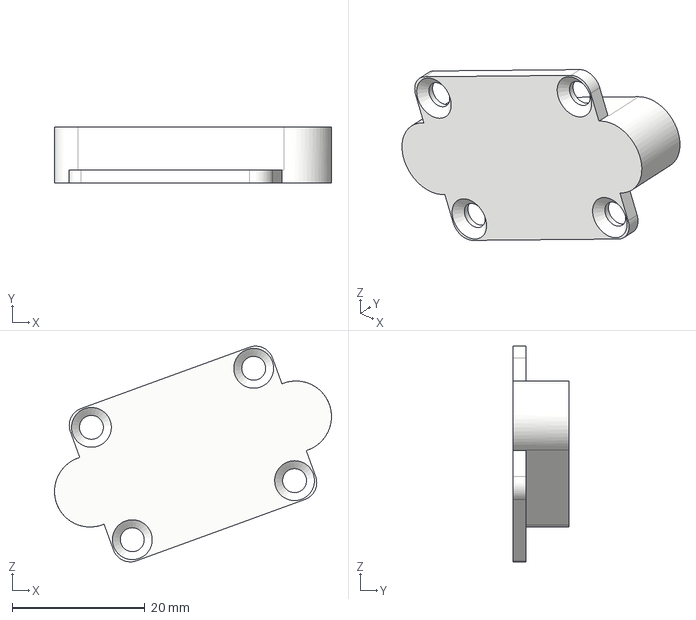
[picture p79: CAD file, 2026-11-03]
cad/ACE_Enclosure_SlideBearing_Rev2.step
41.7 x 8.50 x 32.5 mm
