paulcombuse/BadmintonAce/cad/ACE_Tyre_Mould_Rev0.step

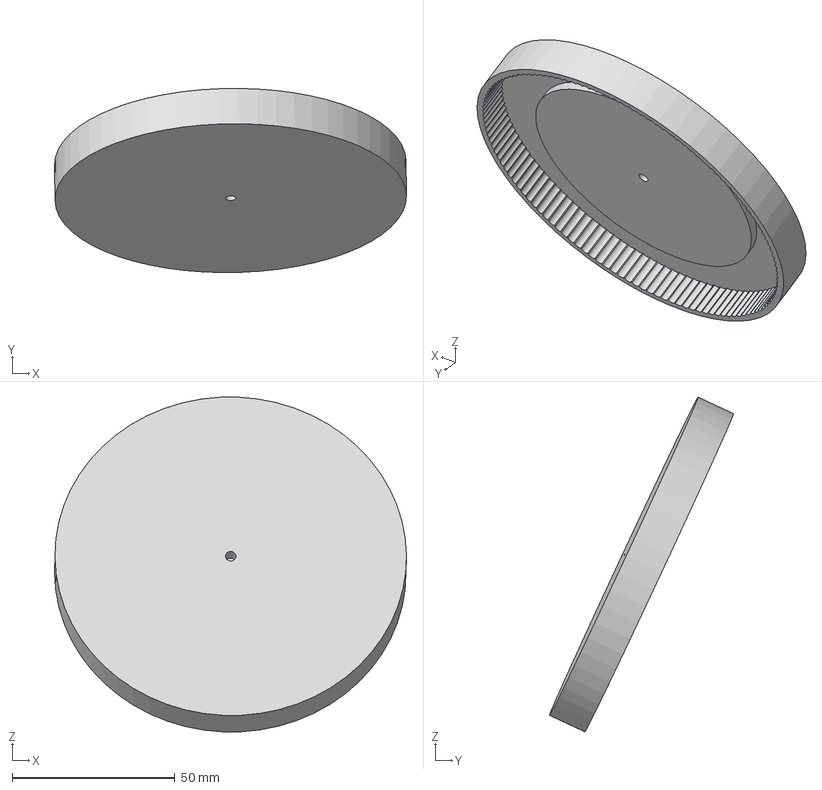
[picture p80: CAD file, 2026-11-03]
cad/ACE_Tyre_Mould_Rev0.step
108.1 x 56.6 x 102.8 mm
