paulcombuse/BadmintonAce/cad/ACE_Shaft_Rev1.step

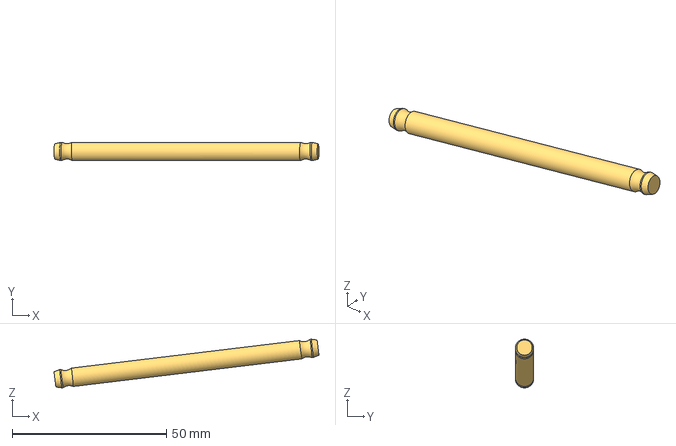
[picture p81: CAD file, 2026-11-03]
cad/ACE_Shaft_Rev1.step
86.0 x 6.00 x 15.8 mm
