paulcombuse/BadmintonAce/cad/ACE_Carriage_Linkage_Rev0.step

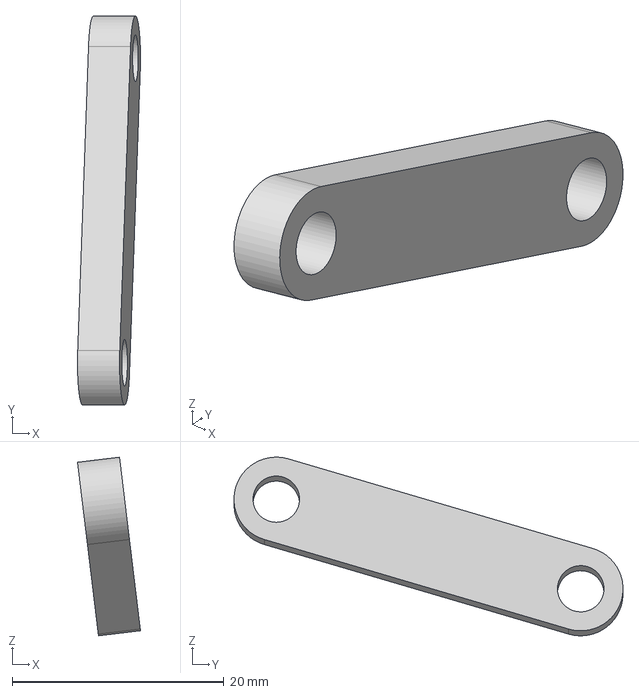
[picture p82: CAD file, 2026-11-03]
cad/ACE_Carriage_Linkage_Rev0.step
5.95 x 36.8 x 16.9 mm
