paulcombuse/BadmintonAce/cad/2x ACE_Tyre_LH&RH_PU-Rubber-ShoreA45_Rev0.step

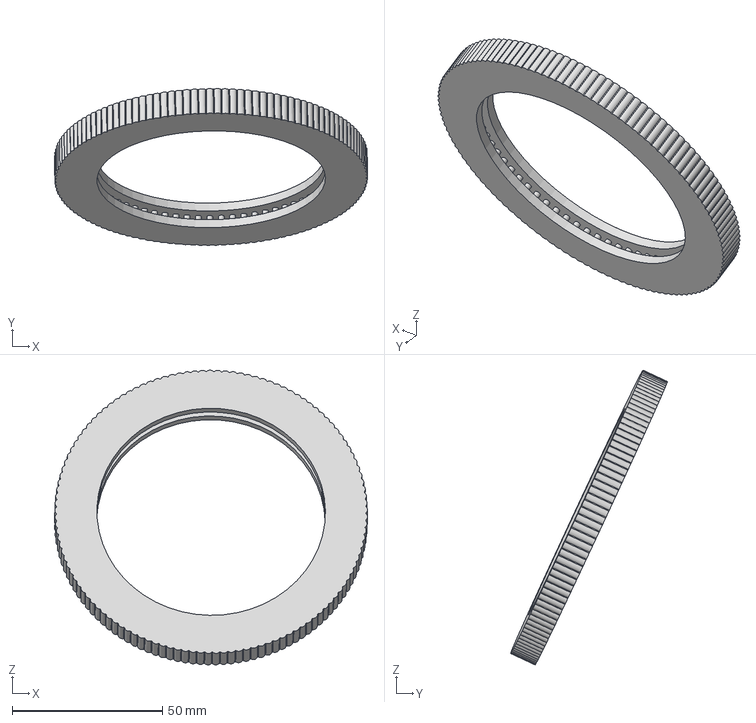
[picture p83: CAD file, 2026-11-03]
cad/2x ACE_Tyre_LH&RH_PU-Rubber-ShoreA45_Rev0.step
104.1 x 52.2 x 98.0 mm
