paulcombuse/BadmintonAce/cad/ACE_Enclosure_FrontCover_LH_Rev0.step

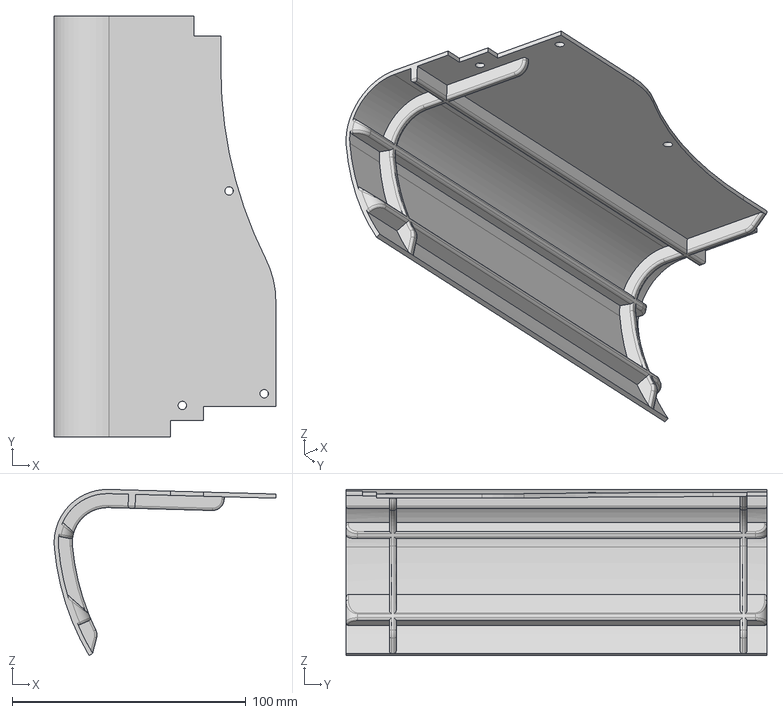
[picture p84: CAD file, 2026-11-03]
cad/ACE_Enclosure_FrontCover_LH_Rev0.step
94.8 x 180.0 x 71.0 mm
