paulcombuse/BadmintonAce/cad/Shuttlecock.step

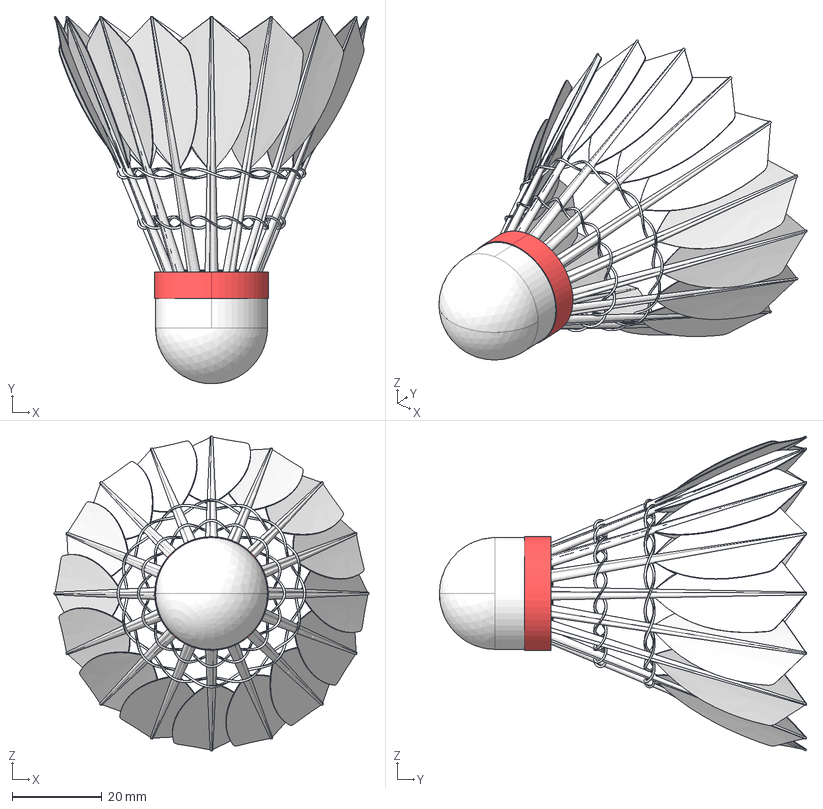
[picture p85: CAD file, 2026-11-03]
cad/Shuttlecock.step
70.4 x 82.1 x 70.4 mm
