paulcombuse/BadmintonAce/cad/2x ACE_GripperArm-LH&RH_Rev2.step

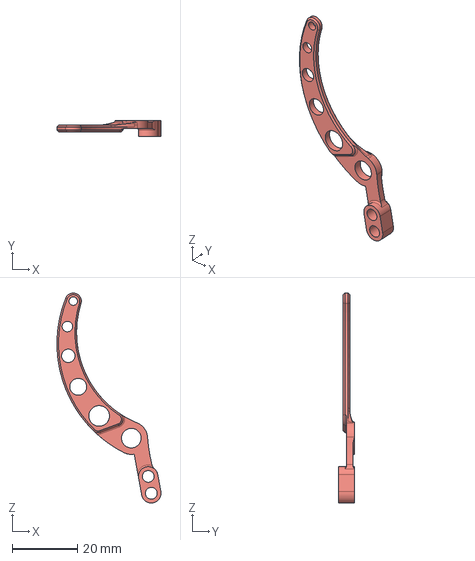
[picture p86: CAD file, 2026-11-03]
cad/2x ACE_GripperArm-LH&RH_Rev2.step
32.0 x 5.00 x 64.5 mm
