paulcombuse/BadmintonAce/cad/ACE_GripperArm-Linkage_LH_Rev0.step

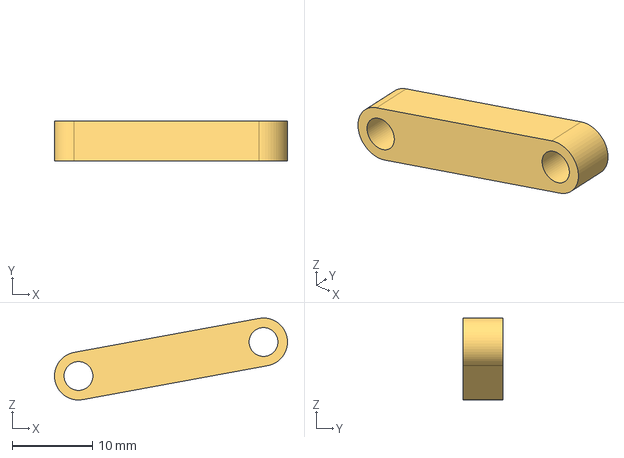
[picture p87: CAD file, 2026-11-03]
cad/ACE_GripperArm-Linkage_LH_Rev0.step
29.1 x 5.00 x 10.2 mm
