paulcombuse/BadmintonAce/cad/ACE_ConveyorRoller_Rev0.step

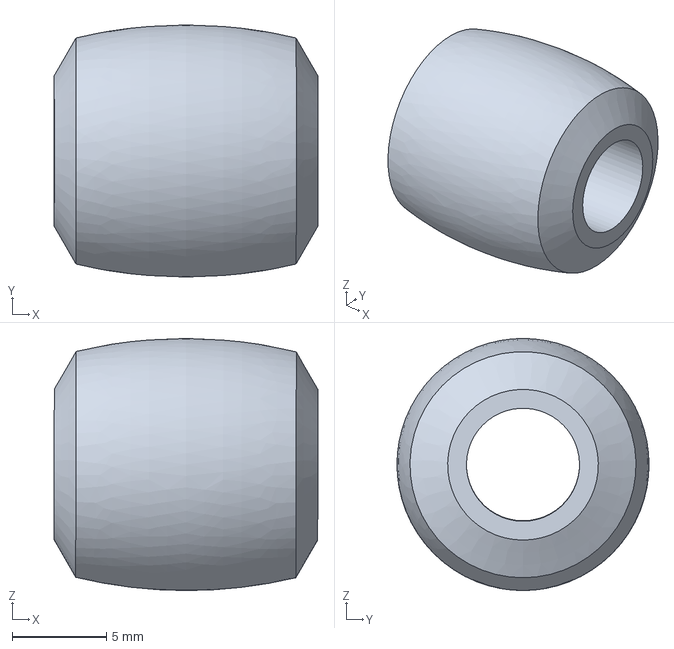
[picture p88: CAD file, 2026-11-03]
cad/ACE_ConveyorRoller_Rev0.step
14.0 x 13.4 x 13.4 mm
