paulcombuse/BadmintonAce/cad/ACE_GripperArm-LH_Rev1.step

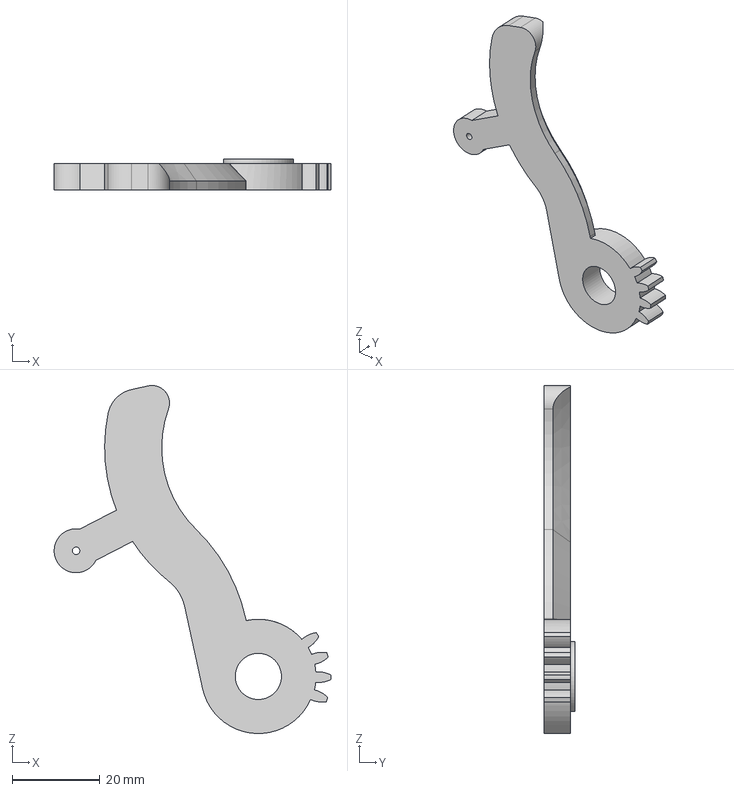
[picture p89: CAD file, 2026-11-03]
cad/ACE_GripperArm-LH_Rev1.step
63.0 x 7.00 x 79.2 mm
