paulcombuse/BadmintonAce/cad/ACE_Tyre_Mould_RimCenteringPin_Rev0.step

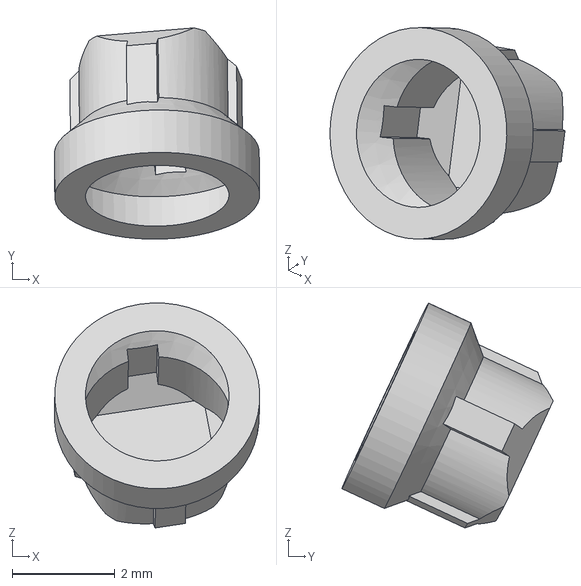
[picture p90: CAD file, 2026-11-03]
cad/ACE_Tyre_Mould_RimCenteringPin_Rev0.step
4.01 x 4.12 x 4.39 mm
