paulcombuse/BadmintonAce/cad/ACE_Enclosure_FrontCover_RH_Rev1.step

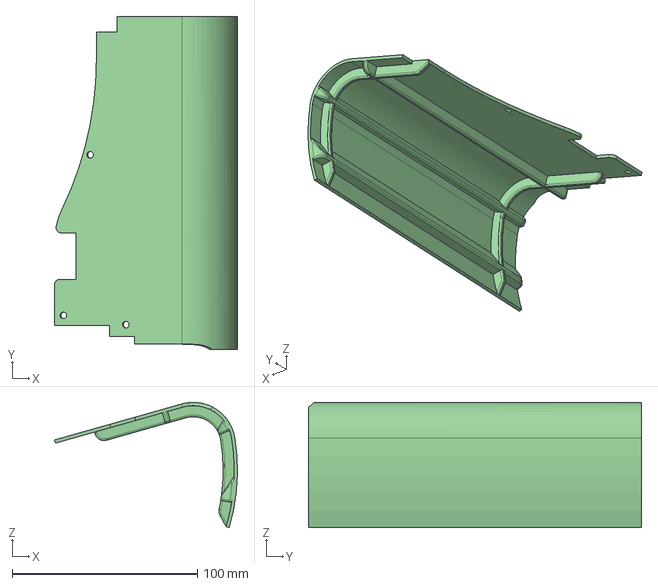
[picture p91: CAD file, 2026-11-03]
cad/ACE_Enclosure_FrontCover_RH_Rev1.step
98.8 x 180.0 x 67.6 mm
