paulcombuse/BadmintonAce/cad/ACE_Enclosure_DistanceSensor_Backcover_Rev1.step

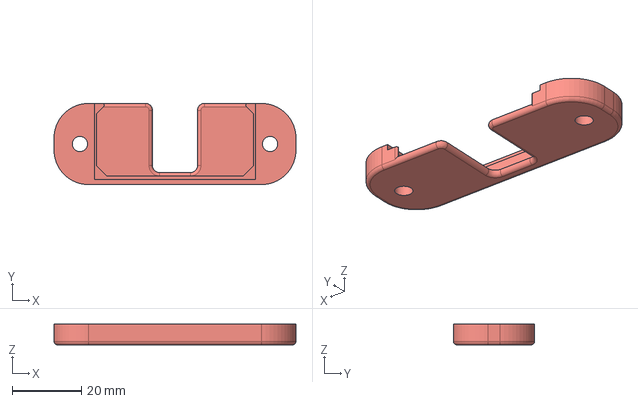
[picture p92: CAD file, 2026-11-03]
cad/ACE_Enclosure_DistanceSensor_Backcover_Rev1.step
70.0 x 23.5 x 6.00 mm
