paulcombuse/BadmintonAce/cad/ACE_ChuteTower-SlideBearing_Rev0.step

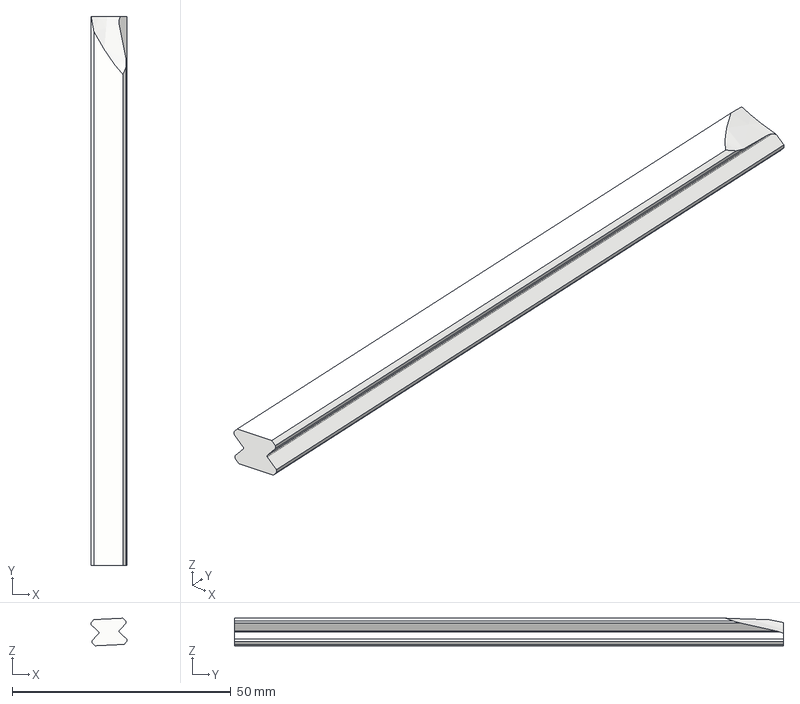
[picture p93: CAD file, 2026-11-03]
cad/ACE_ChuteTower-SlideBearing_Rev0.step
8.22 x 125.5 x 6.32 mm
