paulcombuse/BadmintonAce/cad/ACE_GripperArm-Linkage_RH_Rev0.step

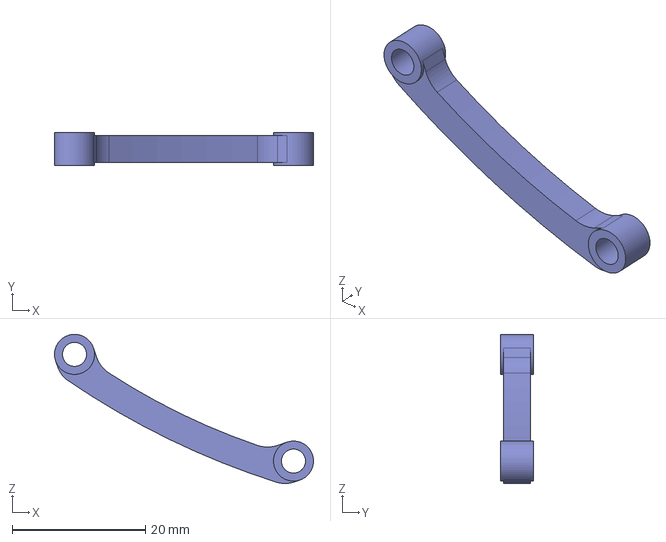
[picture p94: CAD file, 2026-11-03]
cad/ACE_GripperArm-Linkage_RH_Rev0.step
38.8 x 5.00 x 22.4 mm
