paulcombuse/BadmintonAce/cad/ACE_MotorMount_Rev0.step

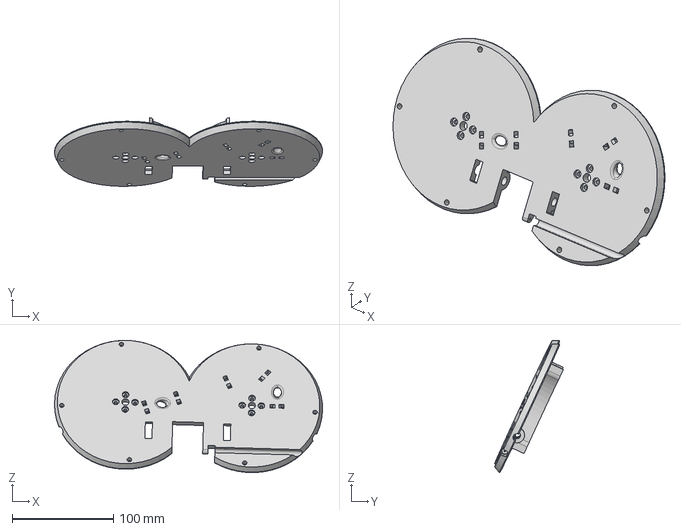
[picture p95: CAD file, 2026-11-03]
cad/ACE_MotorMount_Rev0.step
264.9 x 67.9 x 130.6 mm
