paulcombuse/BadmintonAce/(list of files, cad)

Other CAD files:
cad/ACE_Wheel_Rubber.step
cad/2x ACE_GripperBushing-LH&RH_Rev0.step
cad/2x ACE_WheelCover_LH&RH_Rev0.step
cad/2x ACE_Wheel_Assembly_LH&RH_Rev0_2materials.step
cad/2x ACE_Wheel_Assembly_LH&RH_Rev1_2materials.step
cad/ACE_ChuteTower_Rev0.step
cad/ACE_Enclosure_Cover-CircuitBoard-with-TFT_Rev2.step
cad/ACE_Enclosure_FrontCover_RH_Rev0.step
cad/ACE_Enclosure_MainRig_Rev2.step
cad/ACE_Enclosure_SlideBearing_Rev1.step
cad/ACE_Enclosure_TopCover_Rev1.step
cad/ACE_GripperLinkage_Rev1.step
cad/ACE_Pusher_Rev2.step
cad/ACE_SlideBearing_Follower_Rev0.step
cad/ACE_TripodMount_Rev1.step
cad/ACE_Tube_Base_Rev0.step
cad/shuttlecock.IGS
