paulcombuse/BadmintonAce/documentation/img/PCB_ServeMaster_WiringDiagram.png

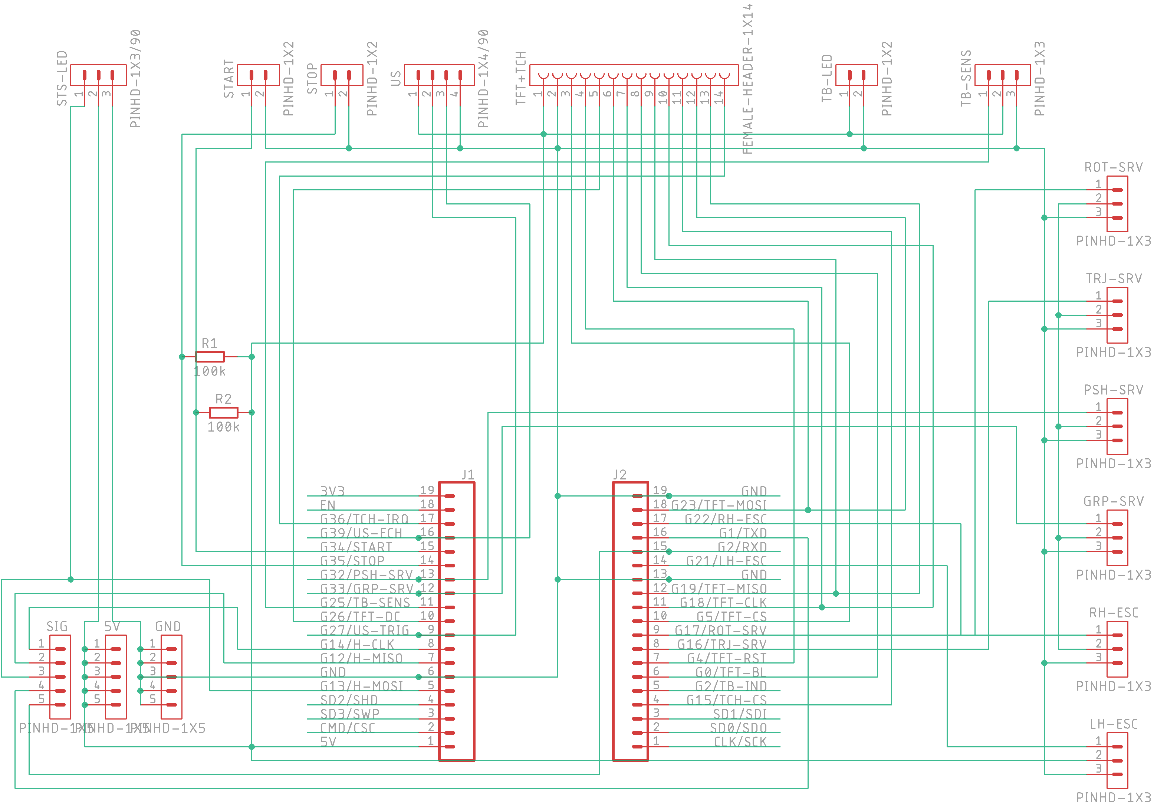
documentation/img/PCB_ServeMaster_WiringDiagram.png
