paulcombuse/BadmintonAce/src/ACE.cpp

#include <WiFi.h>              // Wifi access point configuration
#include <DNSServer.h>         // Captive portal DNS
#include <SPIFFS.h>            // SPIFFS library to allow web page to be uploaded as seperate document
#include <ESPAsyncWebServer.h> // Web server
#include <WebSocketsServer.h>  // Library for web-sockets to msg with front-end
#include <ArduinoJson.h>       // Needed for JSON encapsulation (send multiple variables with one string)
#include <ESP32Servo.h>        // Servo library to control ESC's and servos
#include <Preferences.h>       // Library to allow saving/loading settings data
#include <Math.h>              // Library for maths functions
#include <NewPing.h>           // Sonar libary for obstruction sensor
#include <ESPmDNS.h>           // Library to allow .local instead of IP address to access page.
// NimBLE must be included before PNGdec: PNGdec's zutil.h defines the macro "local",
// which would break NimBLE's ble_sm.h struct member named "local".
#include <NimBLEDevice.h> // NimBLE Bluetooth stack (BLE only, Bluedroid is not used)
#include <PNGdec.h>       // Include the PNG decoder library
#include <FastLED.h>      // Addressable status LED

// Published values for SG90 servos; adjust if needed.
// QY3225 or MS62B Digital Servo - 50-333hz 500-2500 usec
#define servoMinPulseLength 500  // Minimum pulse length in µs
#define servoMaxPulseLength 2500 // Maximum pulse length in µs

// ESC min max
#define escMinPulseLength 1000 // Minimum pulse length in µs
#define escMaxPulseLength 2500 // Maximum pulse length in µs

#define motorKV 750         // Motor KV
#define batteryVoltage 11.1 // Battery voltage for 3 cell lipo

// Recommended pins include 2,4,12-19,21-23,25-27,32-33  //not pin 2 as that's the LED on the DEV BOARD
// When using pins 34,35,36 or 39 take care that these are only inputs and need EXTERNAL pullup resistors (where necessitated, e.g. for our buttons)
// We should use a 100 kΩ resistor for the pullup in order to minimise current draw as we are using a battery powered device.
// To make things easier a dedicated PCB is available with the correct pinout for the ESP32 and all the components of the ACE launcher.
#define startPin 34               // as we want to use pin 34 (having no internal pull-up) an external 100 kΩ pull-up resistor is needed
#define stopPin 35                // as we want to use pin 35 (having no internal pull-up) an external 100 kΩ pull-up resistor is needed
#define throughBeamPin 25         // pull-up
#define throughBeamIndicatorPin 2 // Built in LED
#define servoTrajectoryPin 16     // Servo for trajectory adjustment
#define servoRotationPin 17       // Servo for rotation adjustment
#define servoPusherPin 32         // Servo for shuttle pusher (or alternate puller)
#define servoGripperPin 33        // Servo for shuttle gripper
#define servoLeftESCPin 21        // Electronic Speed Controller for left motor
#define servoRightESCPin 22       // Electronic Speed Controller for right motor
#define ultrasonicTriggerPin 27   // Ultrasonic trigger pin
#define ultrasonicEchoPin 39      // Ultrasonic echo pin
#define ultrasonicMaxDistance 100 // Maximum distance we want to measure (in centimeters). Badminton Service line is 198cm from net.
#define statusLedPin 13           // Pin for status (e.g.WS2812) indicator LED built into the Tube Base.

// Create a state engine variables for the feeding sequence.
#define ST_IDLE 0
#define ST_START 1
#define ST_GRIPPER_OPEN 2
#define ST_GRIPPER_CLOSED 3
#define ST_SHUTTLE_CHECK 4
#define ST_PREP_LAUNCH 5
#define ST_LAUNCH 6
#define ST_RESET 7
static byte system_state = ST_IDLE;
static bool sonar_long_blocked = false;
static uint8_t sonar_blocked_counts = 0;
static bool manual_control_active = false;
static bool manual_shoot_continuous = false;
static bool manual_shot_active = false;
static bool manualMotorsSpinning = false;
static uint32_t manualMotorsSpinningSince = 0;
static const uint32_t MANUAL_MOTORS_IDLE_TIMEOUT_MS = 120000;
enum ManualFeedPhase : uint8_t
{
  MANUAL_FEED_IDLE,
  MANUAL_FEED_PREP_OPEN,
  MANUAL_FEED_PREP_CLOSE,
  MANUAL_FEED_PUSH,
  MANUAL_FEED_RELOAD_OPEN,
  MANUAL_FEED_RELOAD_CLOSE
};
static ManualFeedPhase manual_feed_phase = MANUAL_FEED_IDLE;
static uint8_t manual_reload_attempts = 0;
static uint32_t manual_feed_phase_started = 0;
constexpr uint8_t statusLedCount = 10;
constexpr uint8_t statusLedBrightness = 64;
constexpr uint8_t statusLedIdleMinBrightness = 8;   // this should be the lower threshold for the breathing effect, so that the LED is still visible in a dark room
constexpr uint8_t statusLedIdleMaxBrightness = 128; // The LED stripe is approx. 25 cm long, so e.g. 15 LEDs (each drawing at full brightness 60 mA @ 5V), so in total the LED stripe draws 900 mA at full brightness. To avoid overloading the power supply, we limit the brightness to 128 (50% of full brightness), so the total current draw for 128 is approx. 450 mA.
CRGB statusLeds[statusLedCount];

/////////////////////// TFT ///////////////////////////
#include <TFT_eSPI.h>
static bool LCDconnected = true; // Flag to indicate if the TFT is connected and working. If not, we can skip drawing to it and avoid crashing the program.

// TFT display instance
TFT_eSPI tft = TFT_eSPI();
// Create objects for decoding PNG. The decoder embeds ~45 KB of buffers, so it is allocated
// on the heap only while the boot logo is drawn and freed afterwards, keeping the heap
// available for WiFi/BLE and the web interface.
PNG *png = nullptr;
File pngfile;
int16_t xpos = 10;
int16_t ypos = 0;
const char *pngFilename = "/TSV_ACE_Logo.png";
#define TFT_BKGND_COLOR TFT_BLACK
#define TFT_TEXT_COLOR TFT_WHITE

// This is the file name used to store the touch calibration data
// The SPIFFS file name must start with "/".
#define CALIBRATION_FILE "/TouchCalData"
#define REPEAT_CAL false // Set to true to force recalibration

// Keypad start position, key sizes and spacing
#define BTN_X 80 // Centre of key
#define BTN_Y 200
#define BTN_WIDTH 140 // Width and height
#define BTN_HEIGHT 60
#define BTN_SPACING_X 20 // X and Y gap
#define BTN_SPACING_Y 20
const uint8_t BTN_TEXTSCALING = 1; // Font size scaling factor for button labels

// Using two fonts
#define LABEL1_FONT &FreeSans9pt7b // Key label font 1
#define LABEL2_FONT &FreeMono9pt7b // Key label font 2

// We have a status line for messages
#define STATUS_WIDTH TFT_WIDTH
#define STATUS_X 160 // Centred on this
#define STATUS_Y 130

// Create keys for the keypad
#define BTN_COUNT 8
#define BTN_ROWS 4
#define BTN_COLS 2
// char tftBtnLabel[BTN_COUNT][16] = {"Single\nServe", "Double\nServe", "Single\nFull", "Double\nFull", "Single\nNoRot", "Double\nNoRot", "Calib\nShuttle", "Calib\nWheel"};
String tftMultilineBtnLabel[BTN_COUNT][2] = {{"Singles", "LH Service"}, {"Doubles", "LH Service"}, {"Singles", "RH Service"}, {"Doubles", "RH Service"}, {"Singles", "Full Court"}, {"Doubles", "Full Court"}, {"Custom", "User Preset"}, {"Doubles", "No Rotation"}};
uint16_t tftBtnPos[BTN_COUNT][2] = {};
uint16_t tftBtnColor[BTN_COUNT] = {
    TFT_DARKCYAN, TFT_BLUE,
    TFT_DARKCYAN, TFT_BLUE,
    TFT_DARKCYAN, TFT_BLUE,
    TFT_DARKGREEN, TFT_BLUE};

// Invoke the TFT_eSPI button class and create all the button objects
TFT_eSPI_Button tftBtn[BTN_COUNT];

/////////////////////// TFT END //////////////////////

// Constants
const char *mDnsName = "ACE";
const char *ssid = "ACE_1";
const char *password = "Launcher"; // Password must be >=8 characters
const int dns_port = 53;
const int http_port = 80;
const int ws_port = 81;

// global variables
Preferences preferences;
StaticJsonDocument<512> deviceLocaleDocument;
String currentLanguage = "en";
const char *lastDeviceStatusKey = nullptr;
String lastTftStatusText;
uint16_t lastTftStatusColor = TFT_TEXT_COLOR;
// Marquee scrolling of over-long status texts in the TFT status bar
static int16_t tftStatusTextWidth = 0;
static int16_t tftStatusScrollOffset = 0;
static uint32_t tftStatusScrollNext = 0;
static const uint32_t TFT_STATUS_SCROLL_PAUSE_MS = 2500;
static const uint32_t TFT_STATUS_SCROLL_STEP_MS = 60;
static const int16_t TFT_STATUS_SCROLL_STEP_PX = 2;
volatile bool tftCalibrationInProgress = false;

static NimBLEClient *remoteClient = nullptr;
static volatile bool remotePaired = false;
static volatile bool remoteConnected = false;
static volatile bool remotePairing = false;
static volatile bool remotePairingSession = false;
static volatile bool remoteConnecting = false;
static volatile bool remoteConnectionPending = false;
static volatile bool remotePersistPending = false;
static volatile bool remoteStatusPending = false;
static volatile bool remoteTogglePending = false;
static volatile bool remoteButtonPressed = false;
static volatile bool remoteManualMode = false; // while set, the remote trigger acts as the manual shoot button
static uint32_t remoteManualLastTap = 0;
static uint8_t remoteAddress[6] = {};
static uint8_t remoteAddressType = BLE_ADDR_PUBLIC;
static uint8_t remotePendingAddress[6] = {};
static uint8_t remotePendingAddressType = BLE_ADDR_PUBLIC;
static char remoteDeviceName[32] = {};
static char remotePendingName[32] = {};
static char remoteUiState[20] = "unpaired";
static uint32_t remoteReconnectAt = 0;
static uint32_t remoteEnableAt = 0;
static volatile uint32_t remoteConnectGeneration = 0;
static TaskHandle_t remoteConnectionTaskHandle = nullptr;
static uint32_t remotePairingSessionStartedAt = 0;
static const uint32_t REMOTE_PAIRING_SESSION_TIMEOUT_MS = 120000;

byte sequence_length = 0;
int current_sequence_index = 0;

struct shotDetails
{
  float court_x_pos;
  float court_y_pos;
  float trajectory;
  float rotation;
  float v0;
  int left_motor_rpm;
  int right_motor_rpm;
};
shotDetails active_shots[10];
int active_shot_array_length = 0;
float default_delay = 3;

struct shotEntry
{
  int ID;
  float delay;
};
shotEntry shot_sequence[50];

enum PLAY_TYPE
{
  PLAY_ONCE,
  REPEAT_SHOTS,
  RANDOM_ORDER,
  RANDOM_SHOTS
};
PLAY_TYPE ACTIVE_PLAY_TYPE = PLAY_ONCE;
static const char SinglesLHServicePreset[] = R"json({"command":"update_shots","height":"1.5","velocity_correction":"0","flight_correction":"0","default_delay":"3","shots":[{"x":0.5,"y":2.5,"rotation":15,"trajectory":10,"lm_speed":2935,"rm_speed":958},{"x":2.05,"y":2.5,"rotation":15,"trajectory":10,"lm_speed":961,"rm_speed":3382},{"x":2.05,"y":6.18,"rotation":15,"trajectory":30,"lm_speed":4421,"rm_speed":3966},{"x":0.5,"y":6.18,"rotation":15,"trajectory":30,"lm_speed":6787,"rm_speed":1301}]})json";
static const char SinglesRHServicePreset[] = R"json({"command":"update_shots","height":"1.5","velocity_correction":"0","flight_correction":"0","default_delay":"3","shots":[{"x":-0.5,"y":2.5,"rotation":-15,"trajectory":10,"lm_speed":958,"rm_speed":2935},{"x":-2.05,"y":2.5,"rotation":-15,"trajectory":10,"lm_speed":3382,"rm_speed":961},{"x":-2.05,"y":6.18,"rotation":-15,"trajectory":30,"lm_speed":3966,"rm_speed":4421},{"x":-0.5,"y":6.18,"rotation":-15,"trajectory":30,"lm_speed":1301,"rm_speed":6787}]})json";
static const char DoublesLHServicePreset[] = R"json({"command":"update_shots","height":"1.5","velocity_correction":"0","flight_correction":"0","default_delay":"3","shots":[{"x":0.5,"y":2.5,"rotation":15,"trajectory":10,"lm_speed":2935,"rm_speed":958},{"x":2.51,"y":2.5,"rotation":15,"trajectory":10,"lm_speed":370,"rm_speed":4272},{"x":2.51,"y":5.42,"rotation":15,"trajectory":30,"lm_speed":2881,"rm_speed":4458},{"x":0.5,"y":5.42,"rotation":15,"trajectory":30,"lm_speed":5583,"rm_speed":1157}]})json";
static const char DoublesRHServicePreset[] = R"json({"command":"update_shots","height":"1.5","velocity_correction":"0","flight_correction":"0","default_delay":"3","shots":[{"x":-0.5,"y":2.5,"rotation":-15,"trajectory":10,"lm_speed":958,"rm_speed":2935},{"x":-2.51,"y":2.5,"rotation":-15,"trajectory":10,"lm_speed":4272,"rm_speed":370},{"x":-2.51,"y":5.42,"rotation":-15,"trajectory":30,"lm_speed":4458,"rm_speed":2881},{"x":-0.5,"y":5.42,"rotation":-15,"trajectory":30,"lm_speed":1157,"rm_speed":5583}]})json";
static const char SinglesFullCourtPreset[] = R"json({"command":"update_shots","height":"1.5","velocity_correction":"0","flight_correction":"0","default_delay":"3","shots":[{"x":-2.05,"y":1.3,"rotation":-20,"trajectory":5,"lm_speed":2927,"rm_speed":517},{"x":0,"y":1.3,"rotation":0,"trajectory":5,"lm_speed":1422,"rm_speed":1422},{"x":2.05,"y":1.3,"rotation":20,"trajectory":5,"lm_speed":517,"rm_speed":2927},{"x":-2.05,"y":4,"rotation":-20,"trajectory":20,"lm_speed":2552,"rm_speed":2914},{"x":0,"y":4,"rotation":0,"trajectory":20,"lm_speed":2546,"rm_speed":2546},{"x":2.05,"y":4,"rotation":20,"trajectory":20,"lm_speed":2914,"rm_speed":2552},{"x":-2.05,"y":6.18,"rotation":-20,"trajectory":30,"lm_speed":2741,"rm_speed":5646},{"x":0,"y":6.18,"rotation":0,"trajectory":30,"lm_speed":3969,"rm_speed":3969},{"x":2.05,"y":6.18,"rotation":20,"trajectory":30,"lm_speed":5646,"rm_speed":2741}]})json";
static const char DoublesFullCourtPreset[] = R"json({"command":"update_shots","height":"1.5","velocity_correction":"0","flight_correction":"0","default_delay":"3","shots":[{"x":-2.51,"y":1.3,"rotation":-20,"trajectory":5,"lm_speed":3810,"rm_speed":-66},{"x":0,"y":1.3,"rotation":0,"trajectory":5,"lm_speed":1422,"rm_speed":1422},{"x":2.51,"y":1.3,"rotation":20,"trajectory":5,"lm_speed":-66,"rm_speed":3810},{"x":-2.51,"y":4,"rotation":-20,"trajectory":20,"lm_speed":3293,"rm_speed":2398},{"x":0,"y":4,"rotation":0,"trajectory":20,"lm_speed":2546,"rm_speed":2546},{"x":2.51,"y":4,"rotation":20,"trajectory":20,"lm_speed":2398,"rm_speed":3293},{"x":-2.51,"y":6.18,"rotation":-20,"trajectory":30,"lm_speed":3599,"rm_speed":5087},{"x":0,"y":6.18,"rotation":0,"trajectory":30,"lm_speed":3969,"rm_speed":3969},{"x":2.51,"y":6.18,"rotation":20,"trajectory":30,"lm_speed":5087,"rm_speed":3599}]})json";
static const char SinglesNoRotationPreset[] = R"json({"command":"update_shots","height":"1.5","velocity_correction":"0","flight_correction":"0","default_delay":"3","shots":[{"x":-2.05,"y":1.3,"rotation":0,"trajectory":5,"lm_speed":5289,"rm_speed":-1844},{"x":0,"y":1.3,"rotation":0,"trajectory":5,"lm_speed":1422,"rm_speed":1422},{"x":2.05,"y":1.3,"rotation":0,"trajectory":5,"lm_speed":-1844,"rm_speed":5289},{"x":-2.05,"y":4,"rotation":0,"trajectory":20,"lm_speed":5846,"rm_speed":-379},{"x":0,"y":4,"rotation":0,"trajectory":20,"lm_speed":2546,"rm_speed":2546},{"x":2.05,"y":4,"rotation":0,"trajectory":20,"lm_speed":-379,"rm_speed":5846},{"x":-2.05,"y":6.18,"rotation":0,"trajectory":30,"lm_speed":7697,"rm_speed":690},{"x":0,"y":6.18,"rotation":0,"trajectory":30,"lm_speed":3969,"rm_speed":3969},{"x":2.05,"y":6.18,"rotation":0,"trajectory":30,"lm_speed":690,"rm_speed":7697}]})json";
static const char DoublesNoRotationPreset[] = R"json({"command":"update_shots","height":"1.5","velocity_correction":"0","flight_correction":"0","default_delay":"3","shots":[{"x":-2.51,"y":1.3,"rotation":0,"trajectory":5,"lm_speed":6619,"rm_speed":-2874},{"x":0,"y":1.3,"rotation":0,"trajectory":5,"lm_speed":1422,"rm_speed":1422},{"x":2.51,"y":1.3,"rotation":0,"trajectory":5,"lm_speed":-2874,"rm_speed":6619},{"x":-2.51,"y":4,"rotation":0,"trajectory":20,"lm_speed":6814,"rm_speed":-1122},{"x":0,"y":4,"rotation":0,"trajectory":20,"lm_speed":2546,"rm_speed":2546},{"x":2.51,"y":4,"rotation":0,"trajectory":20,"lm_speed":-1122,"rm_speed":6814},{"x":-2.51,"y":6.18,"rotation":0,"trajectory":30,"lm_speed":8786,"rm_speed":-98},{"x":0,"y":6.18,"rotation":0,"trajectory":30,"lm_speed":3969,"rm_speed":3969},{"x":2.51,"y":6.18,"rotation":0,"trajectory":30,"lm_speed":-98,"rm_speed":8786}]})json";
int gripper_open_pos = 90;
int gripper_closed_pos = 90;
int pusher_catch_pos = 90;
int pusher_push_pos = 90;
int left_rotation_limit = 90;
int right_rotation_limit = 90;
int trajectory_min_limit = 0;
int trajectory_max_limit = 180;
int maxSpeed = 20000; // motorKV * batteryVoltage; 750kV Motor * 11.1V 3S Battery = 8,325. However that's not the ESC max...
// ESC max for a 12 pole motor is 40,000 RPM.
// If there is a linear response and 0 RPM is low, and 40K is high... & i've been using 7500K as max... then i'd expext
int escLowPulseSetPoint = map(2500, 0, maxSpeed, escMinPulseLength, escMaxPulseLength);
int escHighPulseSetPoint = map(5000, 0, maxSpeed, escMinPulseLength, escMaxPulseLength);
int rpmLowSetPoint = 2500;
int rpmHighSetPoint = 5000;
float traj_servo_correction = 0;
float traj_correction = 0;
static bool stop_launcher = true;
bool shuttle_check = true;
bool obstacle_check = true;

// Setup Servo Objects
Servo servoPusher;
Servo servoGripper;
Servo servoTrajectory;
Servo servoRotation;
Servo servoLeftESC;
Servo servoRightESC;

// Setup Sonar Object
NewPing sonar(ultrasonicTriggerPin, ultrasonicEchoPin, ultrasonicMaxDistance); // Setup the ultrasonic sensor pins and max distance.

// The JSON library uses static memory, so this will need to be allocated:
StaticJsonDocument<4096> doc_tx;
StaticJsonDocument<4096> doc_rx;

// Setup the web server
AsyncWebServer server(http_port);
WebSocketsServer webSocket = WebSocketsServer(ws_port);
DNSServer dnsServer;
char msg_buf[10];

void captiveDnsTask(void *parameter)
{
  (void)parameter;
  for (;;)
  {
    dnsServer.processNextRequest();
    vTaskDelay(pdMS_TO_TICKS(10));
  }
}

void sendStatus(const char *status_key, const char *status_color, int seconds = -1);
void sendStatusText(const String &status_text, const char *status_color);
String deviceText(const char *key);
bool loadDeviceLocale(const char *language);
void sendLanguage(uint8_t client_num, bool saved = false);
void applyTftLanguage();
void printDeviceStatusOnTFT(const char *key, uint16_t color, int seconds = -1);
void printStatusOnTFT(const char *msg, uint16_t color = TFT_TEXT_COLOR);
void updateTftStatusScroll();
void sendParameters();
void drawKeypad();
void stopAll();
void stopManualControl();
void sendRemoteStatus();
void beginRemotePairing();
void startBluetoothRemote();
void processRemoteControl();
void connectRemotePeer();
bool ensureNimbleInitialized();
void shutdownNimble();
void handlePayload(const char *payload, size_t length);
void stopManualActuation();
void stopManualFeed();
bool startManualShot();
void startManualPush();
void startManualReload(ManualFeedPhase phase);
void updateManualFeed(uint32_t currentTime);
void updateManualMotorWatchdog();
bool manualAimIsAvailable();
bool manualControlIsSafe();
int getTrajectoryServoPos(float inputAngle);
int getRotationServoPos(float inputAngle);
bool loadAndStartUserPreset();
void updateStatusLed(uint32_t currentTime, bool countdownActive, int countdownValue);

bool parseTrajectoryLimit(JsonVariant value, int &limit)
{
  if (value.is<int>())
  {
    limit = value.as<int>();
  }
  else if (value.is<const char *>())
  {
    const char *text = value.as<const char *>();
    if (text == nullptr || text[0] == '\0')
      return false;
    char *end = nullptr;
    long parsed = strtol(text, &end, 10);
    if (end == text || *end != '\0' || parsed < 0 || parsed > 180)
      return false;
    limit = static_cast<int>(parsed);
  }
  else
  {
    return false;
  }
  return limit >= 0 && limit <= 180;
}

/***********************************************************
   Functions
*/

struct DeviceTranslation
{
  const char *key;
  const char *english;
};

const DeviceTranslation englishDeviceTranslations[] = {
    {"tftSingles", "Singles"},
    {"tftDoubles", "Doubles"},
    {"tftLeftService", "LH Service"},
    {"tftRightService", "RH Service"},
    {"tftFull", "Full Court"},
    {"tftCustom", "Custom"},
    {"tftUserPreset", "User Preset"},
    {"tftNoRotation", "No Rotation"},
    {"touchCorners", "Touch corners as indicated"},
    {"repeatCalibrationWarning", "Set REPEAT_CAL to false to stop this running again!"},
    {"calibrationComplete", "Calibration complete!"},
    {"stopCommandReceived", "Stop command received"},
    {"startButtonPressed", "Start button pressed"},
    {"obstructionDetected", "Obstruction detected"},
    {"manualControlReady", "Manual controls ready"},
    {"manualControlStopped", "Manual controls stopped"},
    {"manualSafetyRequired", "Enable obstacle protection first"},
    {"manualSafetyBlocked", "Obstacle detected - motors stopped"},
    {"manualActuationReady", "No obstacle. Manual mode active."},
    {"manualLauncherBusy", "Stop automatic mode first"},
    {"manualShuttleMissing", "No shuttle detected in the feed"},
    {"shotPatternEmpty", "Shot pattern is empty"},
    {"storageReadError", "Unable to read custom preset storage"},
    {"noCustomPreset", "No custom preset saved"},
    {"customPresetSettingsInvalid", "Custom preset settings are invalid"},
    {"customPresetShotsInvalid", "Custom preset shots are invalid"},
    {"customPresetShotCountInvalid", "Custom preset shot count is invalid"},
    {"customPresetShotDataInvalid", "Custom preset shot data is invalid"},
    {"customPresetSequenceInvalid", "Custom preset sequence is invalid"},
    {"customPresetSequenceLengthInvalid", "Custom preset sequence length is invalid"},
    {"customPresetSequenceEntryInvalid", "Custom preset sequence entry is invalid"},
    {"customPresetNeedsShots", "Custom preset needs 1 to 10 shots"},
    {"customPresetPlayModeInvalid", "Custom preset play mode is invalid"},
    {"presetNameInvalid", "Preset name must be 1 to 31 characters"},
    {"customPresetDelayInvalid", "Custom preset delay is invalid"},
    {"addPatternBeforeSaving", "Add shots to the pattern before saving"},
    {"customPresetTooLarge", "Custom preset is too large to save"},
    {"storageOpenError", "Unable to open custom preset storage"},
    {"customPresetSaveFailed", "Failed to save custom preset"},
    {"customPresetSaved", "Custom preset saved"},
    {"invalidPayload", "Invalid command payload"},
    {"commandMissing", "Command is missing"},
    {"playModeInvalid", "Play mode is invalid"},
    {"noShotsLoaded", "No shots are loaded"},
    {"shotPatternInvalid", "Shot pattern is invalid"},
    {"shotPatternLengthInvalid", "Shot pattern length is invalid"},
    {"shotPatternEntryInvalid", "Shot pattern entry is invalid"},
    {"savingGlobals", "Saving Globals"},
    {"ready", "Ready"},
    {"shotCountInvalid", "Shot count must be between 1 and 10"},
    {"openingGripper", "Opening Gripper"},
    {"closingGripper", "Closing Gripper"},
    {"movingPusherCatch", "Moving Pusher to Catch Position"},
    {"movingPusherPush", "Moving Pusher to Push Position"},
    {"turningLeft", "Turning to left rotation limit"},
    {"turningRight", "Turning to right rotation limit"},
    {"savingSettings", "Saving Settings"},
    {"calibrationMaxThrottle", "Calibration - Max Throttle"},
    {"calibrationMinThrottle", "Calibration - Min Throttle"},
    {"continuousRun", "Continuous Run"},
    {"stopMotor", "Stop Motor"},
    {"setupPose", "Calibration - Setup Pose"},
    {"goingHighSpeed", "Going to high speed."},
    {"goingLowSpeed", "Going to low speed."},
    {"adjustingRpm", "Adjusting RPM Values"},
    {"adjustingTrajectory", "Adjusting Trajectory Zero"},
    {"updatingSettings", "Updating Settings"},
    {"loadingPreset", "Loading Preset."},
    {"unknownCommand", "Command Not Recognized"},
    {"singlesLeftService", "Singles Left-Hand side Service"},
    {"doublesLeftService", "Doubles Left-Hand side Service"},
    {"singlesRightService", "Singles Right-Hand side Service"},
    {"doublesRightService", "Doubles Right-Hand side Service"},
    {"singlesFullCourt", "Singles Full Court"},
    {"doublesFullCourt", "Doubles Full Court"},
    {"doublesNoRotation", "Doubles No Rotation"},
    {"shuttleFeedFailure", "Shuttle Feed Failure"},
    {"feeding", "Feeding"},
    {"stopping", "Stopping"},
    {"startingIn", "Starting In {seconds}s"},
    {"languageInvalid", "Selected language is invalid"},
    {"languageSaveFailed", "Could not save the selected language"}};

const char *deviceEnglishText(const char *key)
{
  for (const DeviceTranslation &entry : englishDeviceTranslations)
  {
    if (strcmp(entry.key, key) == 0)
      return entry.english;
  }
  return nullptr;
}

String tftSafeText(String text)
{
  if (currentLanguage == "de")
  {
    text.replace("\xC3\x84", "Ae");
    text.replace("\xC3\x96", "Oe");
    text.replace("\xC3\x9C", "Ue");
    text.replace("\xC3\xA4", "ae");
    text.replace("\xC3\xB6", "oe");
    text.replace("\xC3\xBC", "ue");
    text.replace("\xC3\x9F", "ss");
  }
  return text;
}

bool loadDeviceLocaleEntry(const char *language, const char *key)
{
  deviceLocaleDocument.clear();
  if (strcmp(language, "en") == 0)
    return true;

  File localeFile = SPIFFS.open("/locales.json", "r");
  if (!localeFile)
  {
    Serial.println("Unable to open localization catalog; English fallback will be used");
    return false;
  }

  StaticJsonDocument<192> filter;
  filter[language]["device"][key] = true;
  DeserializationError error = deserializeJson(deviceLocaleDocument, localeFile, DeserializationOption::Filter(filter));
  localeFile.close();
  if (error)
  {
    Serial.printf("Unable to parse device localization entry '%s': %s\n", key, error.c_str());
    deviceLocaleDocument.clear();
    return false;
  }
  if (!deviceLocaleDocument[language]["device"][key].is<const char *>())
  {
    Serial.printf("Localization catalog has no device translation for '%s' in '%s'\n", key, language);
    deviceLocaleDocument.clear();
    return false;
  }
  return true;
}

String deviceText(const char *key)
{
  if (currentLanguage != "en")
  {
    if (loadDeviceLocaleEntry(currentLanguage.c_str(), key))
      return tftSafeText(deviceLocaleDocument[currentLanguage]["device"][key].as<const char *>());
  }
  const char *english = deviceEnglishText(key);
  if (english != nullptr)
    return tftSafeText(english);
  Serial.printf("No English device fallback for key '%s'\n", key);
  return tftSafeText(key);
}

bool loadDeviceLocale(const char *language)
{
  return loadDeviceLocaleEntry(language, "tftSingles");
}

void applyTftLanguage()
{
  static const char *labelKeys[BTN_COUNT][2] = {
      {"tftSingles", "tftLeftService"},
      {"tftDoubles", "tftLeftService"},
      {"tftSingles", "tftRightService"},
      {"tftDoubles", "tftRightService"},
      {"tftSingles", "tftFull"},
      {"tftDoubles", "tftFull"},
      {"tftCustom", "tftUserPreset"},
      {"tftDoubles", "tftNoRotation"}};
  for (uint8_t button = 0; button < BTN_COUNT; button++)
  {
    for (uint8_t line = 0; line < 2; line++)
      tftMultilineBtnLabel[button][line] = deviceText(labelKeys[button][line]);
  }
}

void sendLanguage(uint8_t client_num, bool saved)
{
  doc_tx.clear();
  JsonObject object = doc_tx.to<JsonObject>();
  object["command"] = "language";
  object["language"] = currentLanguage;
  object["saved"] = saved;
  String jsonString;
  serializeJson(doc_tx, jsonString);
  if (client_num == 255)
    webSocket.broadcastTXT(jsonString);
  else
    webSocket.sendTXT(client_num, jsonString);
}

void setDeviceLanguage(const char *language)
{
  if (language == nullptr || (strcmp(language, "en") != 0 && strcmp(language, "de") != 0))
  {
    sendStatus("languageInvalid", "red");
    sendLanguage(255);
    return;
  }

  if (strcmp(language, currentLanguage.c_str()) == 0)
  {
    sendLanguage(255, true);
    return;
  }
  if (!loadDeviceLocale(language))
  {
    loadDeviceLocale(currentLanguage.c_str());
    sendStatus("languageSaveFailed", "red");
    sendLanguage(255);
    return;
  }

  if (!preferences.begin("Localization", false))
  {
    loadDeviceLocale(currentLanguage.c_str());
    sendStatus("languageSaveFailed", "red");
    sendLanguage(255);
    return;
  }
  size_t bytesWritten = preferences.putString("lang", language);
  preferences.end();
  if (bytesWritten == 0)
  {
    loadDeviceLocale(currentLanguage.c_str());
    sendStatus("languageSaveFailed", "red");
    sendLanguage(255);
    return;
  }

  currentLanguage = language;
  applyTftLanguage();
  if (LCDconnected)
    drawKeypad();
  if (lastDeviceStatusKey != nullptr)
    printDeviceStatusOnTFT(lastDeviceStatusKey, lastTftStatusColor);
  else if (lastTftStatusText.length() > 0)
    printStatusOnTFT(lastTftStatusText.c_str(), lastTftStatusColor);
  sendLanguage(255, true);
}

bool parsePlayType(const char *playType, PLAY_TYPE &parsedType)
{
  if (playType == nullptr)
    return false;
  if (strcmp(playType, "once") == 0)
    parsedType = PLAY_ONCE;
  else if (strcmp(playType, "repeat") == 0)
    parsedType = REPEAT_SHOTS;
  else if (strcmp(playType, "random_order") == 0)
    parsedType = RANDOM_ORDER;
  else if (strcmp(playType, "random_shots") == 0)
    parsedType = RANDOM_SHOTS;
  else
    return false;
  return true;
}

void beginPlayback(PLAY_TYPE playType)
{
  if (playType != RANDOM_SHOTS && sequence_length == 0)
  {
    sendStatus("shotPatternEmpty", "red");
    return;
  }
  ACTIVE_PLAY_TYPE = playType;
  current_sequence_index = 0;
  system_state = ST_START;
}

void sendUserPreset()
{
  String jsonString;
  doc_tx.clear();
  JsonObject object = doc_tx.to<JsonObject>();
  object["command"] = "custom_preset";

  if (!preferences.begin("CustomPattern", true))
  {
    sendStatus("storageReadError", "red");
    return;
  }
  int activeSlot = preferences.getInt("active", -1);
  if (activeSlot < 0 || activeSlot > 1)
  {
    preferences.end();
    object["available"] = false;
  }
  else
  {
    String suffix = String(activeSlot);
    object["available"] = true;
    object["name"] = preferences.getString((String("name") + suffix).c_str(), "Custom User Preset");
    object["play_type"] = preferences.getString((String("mode") + suffix).c_str(), "once");
    object["default_delay"] = preferences.getFloat((String("delay") + suffix).c_str(), 3.0f);
    object["shots_json"] = preferences.getString((String("shots") + suffix).c_str(), "[]");
    object["sequence_json"] = preferences.getString((String("sequence") + suffix).c_str(), "[]");
    preferences.end();
  }

  serializeJson(doc_tx, jsonString);
  webSocket.broadcastTXT(jsonString);
}

bool loadAndStartUserPreset()
{
  if (!preferences.begin("CustomPattern", true))
  {
    sendStatus("storageReadError", "red");
    return false;
  }
  int activeSlot = preferences.getInt("active", -1);
  if (activeSlot < 0 || activeSlot > 1)
  {
    preferences.end();
    sendStatus("noCustomPreset", "red");
    return false;
  }

  String suffix = String(activeSlot);
  String shotsJson = preferences.getString((String("shots") + suffix).c_str(), "[]");
  String sequenceJson = preferences.getString((String("sequence") + suffix).c_str(), "[]");
  String playTypeName = preferences.getString((String("mode") + suffix).c_str(), "once");
  float presetDelay = preferences.getFloat((String("delay") + suffix).c_str(), 3.0f);
  String presetName = preferences.getString((String("name") + suffix).c_str(), "Custom User Preset");
  preferences.end();

  PLAY_TYPE playType;
  if (!parsePlayType(playTypeName.c_str(), playType) || !isfinite(presetDelay) || presetDelay <= 0)
  {
    sendStatus("customPresetSettingsInvalid", "red");
    return false;
  }

  DeserializationError error = deserializeJson(doc_rx, shotsJson);
  if (error || !doc_rx.is<JsonArray>())
  {
    sendStatus("customPresetShotsInvalid", "red");
    return false;
  }
  JsonArray shots = doc_rx.as<JsonArray>();
  if (shots.size() == 0 || shots.size() > 10)
  {
    sendStatus("customPresetShotCountInvalid", "red");
    return false;
  }

  int shotCount = 0;
  for (JsonObject shot : shots)
  {
    if (!shot["x"].is<float>() || !shot["y"].is<float>() ||
        !shot["rotation"].is<float>() || !shot["trajectory"].is<float>() ||
        !shot["lm_speed"].is<int>() || !shot["rm_speed"].is<int>())
    {
      sendStatus("customPresetShotDataInvalid", "red");
      return false;
    }
    active_shots[shotCount].court_x_pos = shot["x"].as<float>();
    active_shots[shotCount].court_y_pos = shot["y"].as<float>();
    active_shots[shotCount].rotation = shot["rotation"].as<float>();
    active_shots[shotCount].trajectory = shot["trajectory"].as<float>();
    active_shots[shotCount].left_motor_rpm = shot["lm_speed"].as<int>();
    active_shots[shotCount].right_motor_rpm = shot["rm_speed"].as<int>();
    shotCount++;
  }

  error = deserializeJson(doc_rx, sequenceJson);
  if (error || !doc_rx.is<JsonArray>())
  {
    sendStatus("customPresetSequenceInvalid", "red");
    return false;
  }
  JsonArray sequence = doc_rx.as<JsonArray>();
  if (sequence.size() > 50 || (playType != RANDOM_SHOTS && sequence.size() == 0))
  {
    sendStatus("customPresetSequenceLengthInvalid", "red");
    return false;
  }

  int sequenceIndex = 0;
  for (JsonObject entry : sequence)
  {
    int shotId = entry["shotID"].as<int>();
    float delay = entry["delay"].as<float>();
    if (!entry["shotID"].is<int>() || !entry["delay"].is<float>() ||
        shotId < 0 || shotId >= shotCount || !isfinite(delay) || delay <= 0 || delay > 60)
    {
      sendStatus("customPresetSequenceEntryInvalid", "red");
      return false;
    }
    shot_sequence[sequenceIndex].ID = shotId;
    shot_sequence[sequenceIndex].delay = delay;
    sequenceIndex++;
  }

  active_shot_array_length = shotCount;
  sequence_length = sequenceIndex;
  default_delay = presetDelay;
  sendStatusText(presetName, "green");
  beginPlayback(playType);
  return system_state == ST_START;
}

bool saveUserPreset()
{
  JsonArray shots = doc_rx["shots"].as<JsonArray>();
  JsonArray sequence = doc_rx["shot_pattern"].as<JsonArray>();
  const char *playTypeValue = doc_rx["play_type"];
  PLAY_TYPE playType;
  String presetName = doc_rx["name"].as<String>();
  presetName.trim();
  float presetDelay = doc_rx["default_delay"].as<float>();

  if (!doc_rx["shots"].is<JsonArray>() || shots.size() == 0 || shots.size() > 10)
  {
    sendStatus("customPresetNeedsShots", "red");
    return false;
  }
  if (!doc_rx["shot_pattern"].is<JsonArray>() || sequence.size() > 50)
  {
    sendStatus("customPresetSequenceInvalid", "red");
    return false;
  }
  if (!parsePlayType(playTypeValue, playType))
  {
    sendStatus("customPresetPlayModeInvalid", "red");
    return false;
  }
  if (presetName.length() == 0 || presetName.length() > 31)
  {
    sendStatus("presetNameInvalid", "red");
    return false;
  }
  if (!isfinite(presetDelay) || presetDelay <= 0 || presetDelay > 60)
  {
    sendStatus("customPresetDelayInvalid", "red");
    return false;
  }
  if (playType != RANDOM_SHOTS && sequence.size() == 0)
  {
    sendStatus("addPatternBeforeSaving", "red");
    return false;
  }

  for (JsonObject shot : shots)
  {
    if (!shot["x"].is<float>() || !shot["y"].is<float>() ||
        !shot["rotation"].is<float>() || !shot["trajectory"].is<float>() ||
        !shot["lm_speed"].is<int>() || !shot["rm_speed"].is<int>())
    {
      sendStatus("customPresetShotDataInvalid", "red");
      return false;
    }
  }
  for (JsonObject entry : sequence)
  {
    int shotId = entry["shotID"].as<int>();
    float delay = entry["delay"].as<float>();
    if (!entry["shotID"].is<int>() || !entry["delay"].is<float>() ||
        shotId < 0 || shotId >= shots.size() || !isfinite(delay) || delay <= 0 || delay > 60)
    {
      sendStatus("customPresetSequenceEntryInvalid", "red");
      return false;
    }
  }

  String shotsJson;
  String sequenceJson;
  serializeJson(shots, shotsJson);
  serializeJson(sequence, sequenceJson);
  if (shotsJson.length() > 1800 || sequenceJson.length() > 1800)
  {
    sendStatus("customPresetTooLarge", "red");
    return false;
  }

  if (!preferences.begin("CustomPattern", false))
  {
    sendStatus("storageOpenError", "red");
    return false;
  }
  int activeSlot = preferences.getInt("active", -1);
  int targetSlot = activeSlot == 0 ? 1 : 0;
  String suffix = String(targetSlot);
  bool saved =
      preferences.putString((String("name") + suffix).c_str(), presetName) > 0 &&
      preferences.putString((String("mode") + suffix).c_str(), playTypeValue) > 0 &&
      preferences.putFloat((String("delay") + suffix).c_str(), presetDelay) > 0 &&
      preferences.putString((String("shots") + suffix).c_str(), shotsJson) > 0 &&
      preferences.putString((String("sequence") + suffix).c_str(), sequenceJson) > 0;
  if (saved)
    saved = preferences.putInt("active", targetSlot) > 0;
  preferences.end();

  if (!saved)
  {
    sendStatus("customPresetSaveFailed", "red");
    return false;
  }

  sendStatus("customPresetSaved", "green");
  sendUserPreset();
  return true;
}

bool manualAimIsAvailable()
{
  if (!manual_control_active)
  {
    sendStatus("manualSafetyRequired", "red");
    return false;
  }
  if (system_state != ST_IDLE)
  {
    sendStatus("manualLauncherBusy", "red");
    return false;
  }
  if (!obstacle_check)
  {
    sendStatus("manualSafetyRequired", "red");
    return false;
  }
  return true;
}

bool manualControlIsSafe()
{
  if (!manualAimIsAvailable())
    return false;
  if (sonar_long_blocked)
  {
    sendStatus("manualSafetyBlocked", "red");
    return false;
  }
  return true;
}

void stopManualActuation()
{
  stopManualFeed();
  servoLeftESC.writeMicroseconds(escMinPulseLength);
  servoRightESC.writeMicroseconds(escMinPulseLength);
}

void stopManualFeed()
{
  manual_shoot_continuous = false;
  manual_shot_active = false;
  manual_feed_phase = MANUAL_FEED_IDLE;
  manual_reload_attempts = 0;
  servoPusher.write(pusher_catch_pos);
  servoGripper.write(gripper_closed_pos);
}

void stopManualControl()
{
  manual_control_active = false;
  manualMotorsSpinning = false;
  manualMotorsSpinningSince = 0;
  stopManualActuation();
}

void startManualReload(ManualFeedPhase phase)
{
  servoGripper.write(gripper_open_pos);
  manual_feed_phase = phase;
  manual_feed_phase_started = millis();
}

void startManualPush()
{
  servoPusher.write(pusher_push_pos);
  manual_feed_phase = MANUAL_FEED_PUSH;
  manual_feed_phase_started = millis();
}

bool startManualShot()
{
  if (!manualControlIsSafe())
    return false;
  if (manual_shot_active)
    return true;

  manual_shot_active = true;
  manual_reload_attempts = 0;
  startManualReload(MANUAL_FEED_PREP_OPEN);
  return true;
}

void updateManualFeed(uint32_t currentTime)
{
  if (!manual_shot_active || (uint32_t)(currentTime - manual_feed_phase_started) < 500)
    return;

  switch (manual_feed_phase)
  {
  case MANUAL_FEED_PREP_OPEN:
    servoGripper.write(gripper_closed_pos);
    manual_feed_phase = MANUAL_FEED_PREP_CLOSE;
    manual_feed_phase_started = currentTime;
    break;
  case MANUAL_FEED_PREP_CLOSE:
    if (shuttle_check && digitalRead(throughBeamPin) != LOW)
    {
      if (manual_reload_attempts == 0)
      {
        manual_reload_attempts++;
        startManualReload(MANUAL_FEED_PREP_OPEN);
      }
      else
      {
        manual_shoot_continuous = false;
        manual_shot_active = false;
        manual_feed_phase = MANUAL_FEED_IDLE;
        sendStatus("manualShuttleMissing", "red");
      }
      break;
    }
    startManualPush();
    break;
  case MANUAL_FEED_PUSH:
    servoPusher.write(pusher_catch_pos);
    manual_reload_attempts = 0;
    startManualReload(MANUAL_FEED_RELOAD_OPEN);
    break;
  case MANUAL_FEED_RELOAD_OPEN:
    servoGripper.write(gripper_closed_pos);
    manual_feed_phase = MANUAL_FEED_RELOAD_CLOSE;
    manual_feed_phase_started = currentTime;
    break;
  case MANUAL_FEED_RELOAD_CLOSE:
    if (shuttle_check && digitalRead(throughBeamPin) != LOW)
    {
      manual_shoot_continuous = false;
      manual_shot_active = false;
      manual_feed_phase = MANUAL_FEED_IDLE;
      sendStatus("manualShuttleMissing", "red");
    }
    else if (manual_shoot_continuous && manualControlIsSafe())
    {
      startManualPush();
    }
    else
    {
      manual_shot_active = false;
      manual_feed_phase = MANUAL_FEED_IDLE;
    }
    break;
  case MANUAL_FEED_IDLE:
    manual_shot_active = false;
    break;
  }
}

// In manual mode, send a stop command if the motors have been spinning for more than two
// minutes without a shot being triggered and without continuous shooting being active.
void updateManualMotorWatchdog()
{
  if (!manual_control_active)
    return;
  if (manual_shot_active || manual_shoot_continuous)
  {
    // A shot is being triggered or continuous shooting is active: restart the idle window.
    if (manualMotorsSpinning)
      manualMotorsSpinningSince = millis();
    return;
  }
  if (manualMotorsSpinning && manualMotorsSpinningSince != 0 &&
      static_cast<uint32_t>(millis() - manualMotorsSpinningSince) >= MANUAL_MOTORS_IDLE_TIMEOUT_MS)
  {
    Serial.println("Manual mode: motors spinning for over 2 minutes without a shot - sending stop");
    manualMotorsSpinning = false;
    manualMotorsSpinningSince = 0;
    stopAll();
  }
}

// BLE HID over GATT service (0x1812) and its report characteristic (0x2A4D) carrying the input reports.
static const NimBLEUUID remoteHidServiceUuid((uint16_t)0x1812);
static const NimBLEUUID remoteHidReportUuid((uint16_t)0x2A4D);

// Copies an address into a byte array in display (big-endian) order, which is what the
// NimBLEAddress(uint8_t[6], type) constructor expects (it reverse-copies internally).
// getNative() returns little-endian bytes, so a plain memcpy would reverse the address.
void copyAddressDisplayOrder(uint8_t *destination, const NimBLEAddress &address)
{
  const uint8_t *native = address.getNative();
  for (int i = 0; i < 6; i++)
    destination[i] = native[5 - i];
}

// Paces reconnect/retry attempts: 5 s during an active pairing session, otherwise 20 s.
// The connect timeout itself is kept short (see connectRemotePeer), so the 2.4 GHz radio
// is only busy ~10 % of the time and stays available for WiFi.
void scheduleRemoteRetry()
{
  remoteReconnectAt = millis() + (remotePairingSession ? 5000 : 20000);
}

void setRemoteUiState(const char *state)
{
  snprintf(remoteUiState, sizeof(remoteUiState), "%s", state);
  remoteStatusPending = true;
}

void sendRemoteStatus()
{
  StaticJsonDocument<256> statusDocument;
  statusDocument["command"] = "remote_status";
  statusDocument["state"] = remoteUiState;
  statusDocument["paired"] = remotePaired;
  statusDocument["connected"] = remoteConnected;
  statusDocument["device"] = remoteDeviceName;
  String payload;
  serializeJson(statusDocument, payload);
  webSocket.broadcastTXT(payload);
}

// Handles HID input report notifications: the remote sends 2-byte input reports where
// byte 0 is 0x01 while a button is pressed ("01 00") and 0x00 when released ("00 00");
// any such press triggers the remote action (see processRemoteControl).
void remoteReportNotify(NimBLERemoteCharacteristic *characteristic, uint8_t *data, size_t length, bool isNotify)
{
  if (!remoteConnected)
    return;
  Serial.printf("HID input report (%u bytes):", (unsigned)length);
  for (size_t index = 0; index < length; index++)
    Serial.printf(" %02X", data[index]);
  Serial.println();
  // Trigger on the first report byte being non-zero: "01 00" = button pressed,
  // "00 00" = released. No usage whitelist - whatever the remote sends as byte 0 counts.
  bool pressed = length >= 1 && data[0] != 0x00;
  if (pressed && !remoteButtonPressed)
    remoteTogglePending = true;
  remoteButtonPressed = pressed;
}

class RemoteClientCallbacks : public NimBLEClientCallbacks
{
public:
  void onConnect(NimBLEClient *client) override
  {
    if (client == remoteClient)
      remoteConnected = true;
  }

  void onDisconnect(NimBLEClient *client) override
  {
    if (client != remoteClient)
      return;
    bool wasConnected = remoteConnected;
    remoteConnected = false;
    remoteButtonPressed = false;
    if (wasConnected && !remoteConnecting && remotePaired)
    {
      scheduleRemoteRetry();
      setRemoteUiState("disconnected");
    }
    else if (!remotePaired && !remoteConnecting)
      setRemoteUiState("unpaired");
  }
};

class RemoteScanCallbacks : public NimBLEAdvertisedDeviceCallbacks
{
public:
  void onResult(NimBLEAdvertisedDevice *advertisedDevice) override
  {
    if (!remotePairing || remoteConnectionPending)
      return;
    // Only devices advertising the HID over GATT service (0x1812) are considered.
    if (!advertisedDevice->isAdvertisingService(remoteHidServiceUuid))
      return;
    uint8_t advType = advertisedDevice->getAdvType();
    Serial.printf("HID advertiser %s advType=%u rssi=%d name='%s'\n",
                  advertisedDevice->getAddress().toString().c_str(), advType,
                  advertisedDevice->getRSSI(), advertisedDevice->getName().c_str());
    // Only connectable undirected advertisements (ADV_IND) can be paired;
    // non-connectable/scannable ones would just time out the connect.
    if (advType != BLE_HCI_ADV_TYPE_ADV_IND)
      return;
    NimBLEAddress address = advertisedDevice->getAddress();
    copyAddressDisplayOrder(remotePendingAddress, address);
    remotePendingAddressType = address.getType();
    snprintf(remotePendingName, sizeof(remotePendingName), "%s", advertisedDevice->getName().c_str());
    // Set the flags before stopping the scan: stop() invokes the scan-complete callback
    // synchronously and it must not end the pairing session while a connect is pending.
    remoteConnectionPending = true;
    remotePairing = false;
    NimBLEDevice::getScan()->stop();
    setRemoteUiState("connecting");
  }
};

static RemoteClientCallbacks remoteClientCallbacks;
static RemoteScanCallbacks remoteScanCallbacks;

void remoteScanComplete(NimBLEScanResults results)
{
  // A finished scan pass without a pending connect only ends the current pass; the pairing
  // session stays alive and processRemoteControl() starts the next pass until the session
  // timeout or a successful connect.
  if (remotePairing && !remoteConnectionPending)
  {
    remotePairing = false;
    scheduleRemoteRetry();
  }
}

// Subscribes to the HID input report characteristics of the connected peer.
bool subscribeRemoteReports(NimBLEClient *client)
{
  NimBLERemoteService *hidService = client->getService(remoteHidServiceUuid);
  if (hidService == nullptr)
  {
    Serial.println("Connected remote does not expose the HID service (0x1812)");
    return false;
  }
  std::vector<NimBLERemoteCharacteristic *> *characteristics = hidService->getCharacteristics(true);
  bool subscribed = false;
  for (NimBLERemoteCharacteristic *characteristic : *characteristics)
  {
    if (characteristic->getUUID() == remoteHidReportUuid && characteristic->canNotify())
      subscribed = characteristic->subscribe(true, remoteReportNotify) || subscribed;
  }
  if (!subscribed)
  {
    // Fall back to any notifiable characteristic of the HID service.
    for (NimBLERemoteCharacteristic *characteristic : *characteristics)
    {
      if (characteristic->canNotify())
        subscribed = characteristic->subscribe(true, remoteReportNotify) || subscribed;
    }
  }
  return subscribed;
}

// Connects to the pending BLE peer as GATT client and subscribes to its HID input reports.
// Runs in the remote connection task because the NimBLE connect/discovery calls block.
void connectRemotePeer()
{
  uint32_t generation = remoteConnectGeneration;
  if (remoteClient != nullptr)
  {
    NimBLEDevice::deleteClient(remoteClient);
    remoteClient = nullptr;
  }
  remoteConnecting = true;
  NimBLEAddress peerAddress(remotePendingAddress, remotePendingAddressType);
  remoteClient = NimBLEDevice::createClient(peerAddress);
  if (remoteClient == nullptr)
  {
    remoteConnecting = false;
    scheduleRemoteRetry();
    setRemoteUiState("failed");
    return;
  }
  // deleteCallbacks=false: remoteClientCallbacks is a static object, the client must not delete it.
  remoteClient->setClientCallbacks(&remoteClientCallbacks, false);
  // Short timeout: an unanswered CONNECT_IND is not repeated within one procedure, so a
  // short timeout keeps the 2.4 GHz radio free for WiFi. Reconnects to a paired remote use
  // 2 s (a healthy remote answers in well under a second), pairing scans use 5 s.
  remoteClient->setConnectTimeout(remotePairingSession ? 5 : 2);
  if (!remoteClient->connect(peerAddress) || !remoteClient->isConnected())
  {
    Serial.printf("Unable to connect to BLE remote %s\n", peerAddress.toString().c_str());
    remoteConnecting = false;
    scheduleRemoteRetry();
    setRemoteUiState(remotePaired ? "disconnected" : "failed");
    return;
  }
  if (generation != remoteConnectGeneration)
  {
    // The remote was forgotten while connecting.
    remoteClient->disconnect();
    remoteConnecting = false;
    return;
  }
  remoteConnected = true;
  remotePaired = true;
  remoteButtonPressed = false;
  NimBLEAddress peer = remoteClient->getPeerAddress();
  copyAddressDisplayOrder(remotePendingAddress, peer);
  remotePendingAddressType = peer.getType();
  if (remotePendingName[0] == '\0')
    snprintf(remotePendingName, sizeof(remotePendingName), "%s", peer.toString().c_str());
  remotePersistPending = true;
  if (!subscribeRemoteReports(remoteClient))
  {
    Serial.println("Unable to subscribe to the HID input reports of the remote");
    remoteClient->disconnect();
    remoteConnecting = false;
    scheduleRemoteRetry();
    setRemoteUiState("failed");
    return;
  }
  remoteConnecting = false;
  remotePairingSession = false;
  setRemoteUiState("connected");
  Serial.printf("Connected to BLE remote %s (%s)\n", peerAddress.toString().c_str(), remotePendingName);
}

void remoteConnectionTask(void *parameter)
{
  while (true)
  {
    if (NimBLEDevice::getInitialized() && remoteConnectionPending &&
        !remoteConnecting && !remoteConnected && !remotePairing)
    {
      remoteConnectionPending = false;
      // Claim the connection before the blocking connect so shutdownNimble() can't delete this task mid-connect.
      remoteConnecting = true;
      connectRemotePeer();
    }
    vTaskDelay(pdMS_TO_TICKS(100));
  }
}

void beginRemotePairing()
{
  if (remoteConnected || remoteConnecting || remoteConnectionPending)
  {
    setRemoteUiState("disconnect_first");
    return;
  }
  if (!ensureNimbleInitialized())
  {
    setRemoteUiState("failed");
    return;
  }
  remoteConnectGeneration++;
  remotePairing = true;
  remotePairingSession = true;
  remotePairingSessionStartedAt = millis();
  remoteEnableAt = 0;
  remoteButtonPressed = false;
  remotePendingName[0] = '\0';
  setRemoteUiState("searching");
  NimBLEScan *scan = NimBLEDevice::getScan();
  scan->stop();
  scan->clearResults();
  if (!scan->start(30, remoteScanComplete))
  {
    remotePairing = false;
    Serial.println("Unable to start the BLE scan for a HID remote");
    setRemoteUiState("failed");
  }
}

void forgetRemote()
{
  remoteConnectGeneration++;
  remotePairingSession = false;
  remoteEnableAt = 0;
  if (NimBLEDevice::getInitialized())
  {
    if (remotePairing)
    {
      remotePairing = false;
      NimBLEDevice::getScan()->stop();
    }
    if (remoteClient != nullptr && remoteClient->isConnected())
      remoteClient->disconnect();
    if (remotePaired)
      NimBLEDevice::deleteBond(NimBLEAddress(remoteAddress, remoteAddressType));
  }
  remoteConnectionPending = false;

  Preferences remotePreferences;
  if (remotePreferences.begin("BtRemote", false))
  {
    remotePreferences.clear();
    remotePreferences.end();
  }
  else
    Serial.println("Unable to clear Bluetooth remote settings");

  remotePaired = false;
  remoteConnected = false;
  remoteConnecting = false;
  remoteDeviceName[0] = '\0';
  setRemoteUiState("unpaired");
}

// Initializes the NimBLE stack once (BLE central/observer only) and starts the connection task.
// Called on demand: at boot only when a remote is paired, otherwise when pairing is started.
bool ensureNimbleInitialized()
{
  if (!NimBLEDevice::getInitialized())
  {
    Serial.println("Initializing NimBLE Bluetooth (BLE only)");
    Serial.flush();
    NimBLEDevice::init("ACE");
    // Present a random (static) own address as initiator, like phones typically do.
    NimBLEDevice::setOwnAddrType(BLE_OWN_ADDR_RANDOM);
    // Bonding with just-works pairing as expected by the HID remotes (no MITM, no secure connections).
    NimBLEDevice::setSecurityAuth(true, false, false);
    NimBLEDevice::setSecurityIOCap(BLE_HS_IO_NO_INPUT_OUTPUT);

    NimBLEScan *scan = NimBLEDevice::getScan();
    scan->setAdvertisedDeviceCallbacks(&remoteScanCallbacks);
    scan->setActiveScan(true);
    scan->setInterval(80);
    scan->setWindow(48);
    scan->setDuplicateFilter(true);

    if (remoteConnectionTaskHandle == nullptr &&
        xTaskCreate(remoteConnectionTask, "remoteConn", 4096, nullptr, 1, &remoteConnectionTaskHandle) != pdPASS)
    {
      Serial.println("Unable to start the Bluetooth remote connection task");
      return false;
    }
    Serial.printf("Heap after Bluetooth initialization: %u bytes free, %u-byte largest block\n",
                  ESP.getFreeHeap(), ESP.getMaxAllocHeap());
    Serial.flush();
  }
  return true;
}

// Releases the NimBLE stack again while no remote is paired/connected and no pairing session
// is active, so heap and the 2.4 GHz radio stay available for WiFi and the web interface.
// The stored bond in NVS is kept; deinit() only frees the runtime objects.
void shutdownNimble()
{
  if (!NimBLEDevice::getInitialized() || remoteConnecting || remoteConnectionPending)
    return;
  Serial.println("Shutting down NimBLE Bluetooth to free heap for WiFi/web");
  Serial.flush();
  remotePairing = false;
  remotePairingSession = false;
  NimBLEScan *scan = NimBLEDevice::getScan();
  if (scan != nullptr)
    scan->stop();
  if (remoteClient != nullptr)
  {
    if (remoteClient->isConnected())
      remoteClient->disconnect();
    NimBLEDevice::deleteClient(remoteClient);
    remoteClient = nullptr;
  }
  remoteConnected = false;
  if (remoteConnectionTaskHandle != nullptr)
  {
    vTaskDelete(remoteConnectionTaskHandle);
    remoteConnectionTaskHandle = nullptr;
  }
  NimBLEDevice::deinit(true);
  Serial.printf("Heap after Bluetooth shutdown: %u bytes free, %u-byte largest block\n",
                ESP.getFreeHeap(), ESP.getMaxAllocHeap());
  Serial.flush();
}

void startBluetoothRemote()
{
  Preferences remotePreferences;
  Serial.println("Loading Bluetooth remote settings");
  Serial.flush();
  if (!remotePreferences.begin("BtRemote", false))
  {
    Serial.println("Unable to open Bluetooth remote settings");
    setRemoteUiState("failed");
    return;
  }
  // Only a saved BLE pairing (profile 0) is restored; a former Bluetooth Classic pairing is ignored.
  remotePaired = remotePreferences.isKey("address") &&
                 remotePreferences.getBytesLength("address") == 6 &&
                 remotePreferences.getUChar("profile", 0) == 0;
  if (remotePaired)
  {
    remotePreferences.getBytes("address", remoteAddress, 6);
    remoteAddressType = remotePreferences.getUChar("addr_type", BLE_ADDR_PUBLIC);
    remotePreferences.getString("name", remoteDeviceName, sizeof(remoteDeviceName));
    remotePreferences.end();
    // With a paired remote, BLE is enabled a little after boot (see processRemoteControl),
    // so WiFi association and the first page load happen with a free radio.
    remoteEnableAt = millis() + 20000;
    setRemoteUiState("disconnected");
  }
  else
  {
    // Without a paired remote, BLE stays off until pairing is started, keeping the
    // full heap and the 2.4 GHz radio available for the web interface.
    remotePreferences.end();
    setRemoteUiState("unpaired");
  }
  Serial.println(remotePaired ? "Bluetooth remote settings loaded: paired" : "Bluetooth remote settings loaded: unpaired");
}

void processRemoteControl()
{
  if (remotePersistPending)
  {
    remotePersistPending = false;
    memcpy(remoteAddress, remotePendingAddress, 6);
    remoteAddressType = remotePendingAddressType;
    snprintf(remoteDeviceName, sizeof(remoteDeviceName), "%s", remotePendingName);
    remotePendingName[0] = '\0';
    Preferences remotePreferences;
    if (!remotePreferences.begin("BtRemote", false))
    {
      Serial.println("Unable to open Bluetooth remote settings");
      setRemoteUiState("storage_error");
    }
    else
    {
      bool saved = remotePreferences.putBytes("address", remoteAddress, 6) == 6 &&
                   remotePreferences.putUChar("profile", 0) == sizeof(uint8_t) &&
                   remotePreferences.putUChar("addr_type", remoteAddressType) == sizeof(uint8_t) &&
                   remotePreferences.putString("name", remoteDeviceName) > 0;
      remotePreferences.end();
      if (!saved)
      {
        Serial.println("Unable to save Bluetooth remote settings");
        setRemoteUiState("storage_error");
      }
    }
  }

  if (remoteStatusPending)
  {
    remoteStatusPending = false;
    sendRemoteStatus();
  }

  // Free the client object once the remote has been forgotten and no connection attempt is running.
  if (!remotePaired && !remoteConnected && !remoteConnecting && !remotePairing && !remoteConnectionPending &&
      remoteClient != nullptr)
  {
    NimBLEDevice::deleteClient(remoteClient);
    remoteClient = nullptr;
  }

  // End a pairing session after a timeout so Bluetooth is not kept running forever.
  if (remotePairingSession &&
      static_cast<int32_t>(millis() - remotePairingSessionStartedAt) >= static_cast<int32_t>(REMOTE_PAIRING_SESSION_TIMEOUT_MS))
  {
    Serial.println("BLE remote pairing session timed out");
    remotePairingSession = false;
    remotePairing = false;
    if (NimBLEDevice::getInitialized() && NimBLEDevice::getScan() != nullptr)
      NimBLEDevice::getScan()->stop();
    setRemoteUiState(remotePaired ? "disconnected" : "not_found");
  }

  // Release Bluetooth again while nothing is paired and no pairing session is running,
  // keeping heap and radio free for a stable WiFi web interface.
  if (NimBLEDevice::getInitialized() && !remotePaired && !remoteConnected && !remoteConnecting &&
      !remotePairing && !remoteConnectionPending && !remotePairingSession)
    shutdownNimble();

  if (remoteTogglePending)
  {
    remoteTogglePending = false;
    if (remoteManualMode && manual_control_active)
    {
      // In manual mode the remote trigger works like the manual page shoot button:
      // a single tap shoots once, a second tap within one second starts continuous
      // shooting, and a tap while continuous shooting is running stops it.
      uint32_t now = millis();
      bool recentTap = remoteManualLastTap != 0 &&
                       static_cast<uint32_t>(now - remoteManualLastTap) <= 1000;
      if (manual_shoot_continuous)
      {
        manual_shoot_continuous = false;
        remoteManualLastTap = 0;
        stopManualFeed();
      }
      else if (recentTap)
      {
        remoteManualLastTap = 0;
        manual_shoot_continuous = true;
        if (!manual_shot_active && !startManualShot())
          manual_shoot_continuous = false;
      }
      else
      {
        remoteManualLastTap = now;
        manual_shoot_continuous = false;
        startManualShot();
      }
    }
    else if (system_state != ST_IDLE || manual_control_active)
      stopAll();
    else
    {
      static const char startPayload[] = R"json({"command":"start","play_type":"random_shots","shot_pattern":[]})json";
      handlePayload(startPayload, sizeof(startPayload) - 1);
    }
  }

  // Enable NimBLE some time after boot when a remote is paired, so WiFi association and the
  // first page load happen first with a free 2.4 GHz radio.
  if (remotePaired && remoteEnableAt != 0 && !NimBLEDevice::getInitialized() &&
      !remotePairingSession &&
      static_cast<int32_t>(millis() - remoteEnableAt) >= 0)
  {
    remoteEnableAt = 0;
    if (ensureNimbleInitialized())
      remoteReconnectAt = millis() + 1000;
  }

  if (remotePaired && remoteConnectionTaskHandle != nullptr &&
      !remoteConnected && !remoteConnecting && !remotePairing && !remoteConnectionPending &&
      static_cast<int32_t>(millis() - remoteReconnectAt) >= 0)
  {
    memcpy(remotePendingAddress, remoteAddress, 6);
    remotePendingAddressType = remoteAddressType;
    snprintf(remotePendingName, sizeof(remotePendingName), "%s", remoteDeviceName);
    remoteConnectionPending = true;
  }

  // During a pairing session, a failed connect attempt goes back to scanning for the remote.
  if (remotePairingSession && !remotePairing && !remoteConnectionPending &&
      !remoteConnected && !remoteConnecting &&
      static_cast<int32_t>(millis() - remoteReconnectAt) >= 0)
  {
    remotePairing = true;
    setRemoteUiState("searching");
    NimBLEScan *scan = NimBLEDevice::getScan();
    scan->stop();
    scan->clearResults();
    if (!scan->start(30, remoteScanComplete))
    {
      remotePairing = false;
      remotePairingSession = false;
      setRemoteUiState("failed");
    }
  }
}

// Handle commands from incoming JSON payloads
void handlePayload(const char *payload, size_t length)
{
  DeserializationError error = deserializeJson(doc_rx, payload, length);

  if (error)
  {
    Serial.print("deserializeJson() failed: ");
    Serial.println(error.c_str());
    sendStatus("invalidPayload", "red");
    return;
  }

  const char *command = doc_rx["command"];
  if (command == nullptr)
  {
    sendStatus("commandMissing", "red");
    return;
  }

  if (strcmp(command, "set_language") == 0)
  {
    setDeviceLanguage(doc_rx["language"]);
  }
  else if (strcmp(command, "get_language") == 0)
  {
    sendLanguage(255);
  }
  else if (strcmp(command, "remote_status") == 0)
  {
    sendRemoteStatus();
  }
  else if (strcmp(command, "remote_pair") == 0)
  {
    beginRemotePairing();
  }
  else if (strcmp(command, "remote_forget") == 0)
  {
    forgetRemote();
  }
  else if (strcmp(command, "manual_enable") == 0)
  {
    if (system_state != ST_IDLE)
    {
      sendStatus("manualLauncherBusy", "red");
      return;
    }
    if (!obstacle_check)
    {
      sendStatus("manualSafetyRequired", "red");
      return;
    }
    if (sonar_blocked_counts >= 4)
      sonar_long_blocked = true;
    manual_control_active = true;
    // Entering the manual page also switches the BLE remote trigger to shoot-button mode.
    remoteManualMode = true;
    sendStatus("manualControlReady", "green");
    if (sonar_long_blocked)
      sendStatus("manualSafetyBlocked", "red");
    else
      sendStatus("manualActuationReady", "green");
  }
  else if (strcmp(command, "manual_stop") == 0)
  {
    remoteManualMode = false;
    stopManualControl();
    sendStatus("manualControlStopped", "green");
  }
  else if (strcmp(command, "manual_aim") == 0)
  {
    if (!manualAimIsAvailable())
      return;
    if ((!doc_rx["x"].is<float>() && !doc_rx["x"].is<int>()) ||
        (!doc_rx["y"].is<float>() && !doc_rx["y"].is<int>()))
    {
      sendStatus("invalidPayload", "red");
      return;
    }
    float x = doc_rx["x"].as<float>();
    float y = doc_rx["y"].as<float>();
    if (!isfinite(x) || !isfinite(y) || x < -1 || x > 1 || y < -1 || y > 1)
    {
      sendStatus("invalidPayload", "red");
      return;
    }
    int leftLimit = constrain(left_rotation_limit, 0, 180);
    int rightLimit = constrain(right_rotation_limit, 0, 180);
    int rotationPosition = roundf(leftLimit + (rightLimit - leftLimit) * (x + 1) / 2);
    float trajectory = -4 + (y + 1) * 22;
    servoRotation.write(rotationPosition);
    servoTrajectory.write(getTrajectoryServoPos(trajectory));
  }
  else if (strcmp(command, "manual_motor") == 0)
  {
    if (!manualControlIsSafe())
      return;
    if (!doc_rx["throttle"].is<int>() || !doc_rx["bias"].is<int>())
    {
      sendStatus("invalidPayload", "red");
      return;
    }
    int throttle = doc_rx["throttle"].as<int>();
    int bias = doc_rx["bias"].as<int>();
    if (throttle < 0 || throttle > 100 || bias < -100 || bias > 100)
    {
      sendStatus("invalidPayload", "red");
      return;
    }
    float leftFactor = bias > 0 ? (100 - bias) / 100.0f : 1.0f;
    float rightFactor = bias < 0 ? (100 + bias) / 100.0f : 1.0f;
    int maxRpm = constrain(rpmHighSetPoint, 1, maxSpeed);
    int maxPulse = constrain(escHighPulseSetPoint, escMinPulseLength, escMaxPulseLength);
    int leftRpm = roundf(maxRpm * throttle * leftFactor / 100.0f);
    int rightRpm = roundf(maxRpm * throttle * rightFactor / 100.0f);
    int leftPulse = leftRpm == 0 ? escMinPulseLength : map(leftRpm, 0, maxRpm, escMinPulseLength, maxPulse);
    int rightPulse = rightRpm == 0 ? escMinPulseLength : map(rightRpm, 0, maxRpm, escMinPulseLength, maxPulse);
    servoLeftESC.writeMicroseconds(leftPulse);
    servoRightESC.writeMicroseconds(rightPulse);
    // Track motor spinning for the manual-mode watchdog (see updateManualMotorWatchdog).
    manualMotorsSpinning = leftRpm > 0 || rightRpm > 0;
    if (manualMotorsSpinning && manualMotorsSpinningSince == 0)
      manualMotorsSpinningSince = millis();
    else if (!manualMotorsSpinning)
      manualMotorsSpinningSince = 0;
  }
  else if (strcmp(command, "manual_shoot") == 0)
  {
    manual_shoot_continuous = false;
    startManualShot();
  }
  else if (strcmp(command, "manual_continuous_start") == 0)
  {
    manual_shoot_continuous = true;
    if (!manual_shot_active && !startManualShot())
      manual_shoot_continuous = false;
  }
  else if (strcmp(command, "manual_continuous_stop") == 0)
  {
    stopManualFeed();
  }
  else if (strcmp(command, "start") == 0)
  {
    // Starting a pattern from the main page switches the BLE remote trigger back to
    // the default start/stop toggle.
    remoteManualMode = false;
    if (manual_control_active)
    {
      sendStatus("manualLauncherBusy", "red");
      return;
    }
    const char *play_type = doc_rx["play_type"];
    PLAY_TYPE playType;
    if (!parsePlayType(play_type, playType))
    {
      sendStatus("playModeInvalid", "red");
      return;
    }
    if (active_shot_array_length <= 0 || active_shot_array_length > 10)
    {
      sendStatus("noShotsLoaded", "red");
      return;
    }
    if (!doc_rx["shot_pattern"].is<JsonArray>())
    {
      sendStatus("shotPatternInvalid", "red");
      return;
    }
    JsonArray pattern = doc_rx["shot_pattern"].as<JsonArray>();
    if (pattern.size() > 50 || (playType != RANDOM_SHOTS && pattern.size() == 0))
    {
      sendStatus("shotPatternLengthInvalid", "red");
      return;
    }

    int array_index = 0;
    for (JsonObject shot_pattern : pattern)
    {
      int shotId = shot_pattern["shotID"].as<int>();
      float delay = shot_pattern["delay"].as<float>();
      if (!shot_pattern["shotID"].is<int>() || !shot_pattern["delay"].is<float>() ||
          shotId < 0 || shotId >= active_shot_array_length ||
          !isfinite(delay) || delay <= 0 || delay > 60)
      {
        sendStatus("shotPatternEntryInvalid", "red");
        return;
      }
      shot_sequence[array_index].ID = shotId;
      shot_sequence[array_index].delay = delay;
      array_index++;
    }

    sequence_length = array_index;
    beginPlayback(playType);
  }
  else if (strcmp(command, "save_user_preset") == 0)
  {
    saveUserPreset();
  }
  else if (strcmp(command, "get_user_preset") == 0)
  {
    sendUserPreset();
  }
  else if (strcmp(command, "save_globals") == 0)
  {
    // Example JSON: {"command":"save_globals","height":"1.5","velocity_correction":"0","flight_correction":"0"}

    Serial.println("Save globals.");
    sendStatus("savingGlobals", "orange");
    preferences.begin("Globals", false);
    preferences.putFloat("velocity_adj", doc_rx["velocity_correction"].as<float>());
    preferences.putFloat("flight_adj", doc_rx["flight_correction"].as<float>());
    preferences.putFloat("launcher_y", doc_rx["height"].as<float>());
    preferences.end();
    sendStatus("ready", "green");
  }
  else if (strcmp(command, "update_shots") == 0)
  {
    // Editing the shot pattern on the main page switches the BLE remote trigger back to
    // the default start/stop toggle and stops manual mode.
    remoteManualMode = false;
    if (manual_control_active)
      stopManualControl();
    if (!doc_rx["shots"].is<JsonArray>() || doc_rx["shots"].as<JsonArray>().size() == 0 ||
        doc_rx["shots"].as<JsonArray>().size() > 10)
    {
      sendStatus("shotCountInvalid", "red");
      return;
    }
    // Example JSON: {"command":"update_shots","height":"1.5","velocity_correction":"0","shots":[{"x":-2.5,"y":1.5,"rotation":-19,"trajectory":25},{"x":-0.937876256651103,"y":0.9950842255448553,"rotation":0,"trajectory":25},{"x":2.5,"y":1.5,"rotation":19,"trajectory":25},{"x":-2.5,"y":4,"rotation":-19,"trajectory":30},{"x":-1.0410451154325955,"y":3.5397617551513334,"rotation":0,"trajectory":30},{"x":2.5,"y":4,"rotation":19,"trajectory":30},{"x":-1.913775113193595,"y":5.877384048675795,"rotation":-15,"trajectory":40},{"x":0,"y":5.5,"rotation":0,"trajectory":40},{"x":2.5,"y":5.5,"rotation":15,"trajectory":40},{"x":0,"y":3,"rotation":0,"trajectory":35}]}
    default_delay = doc_rx["default_delay"].as<float>();

    int array_index = 0;
    for (JsonObject settings_shot : doc_rx["shots"].as<JsonArray>())
    {
      active_shots[array_index].court_x_pos = settings_shot["x"].as<float>();
      active_shots[array_index].court_y_pos = settings_shot["y"].as<float>();
      active_shots[array_index].trajectory = settings_shot["trajectory"].as<float>();
      active_shots[array_index].rotation = settings_shot["rotation"].as<float>();
      active_shots[array_index].left_motor_rpm = settings_shot["lm_speed"].as<int>();
      active_shots[array_index].right_motor_rpm = settings_shot["rm_speed"].as<int>();

      Serial.printf("index:%i   x: %f   y: %f   traj: %f   rot: %f   lm: %i   rm: %i", array_index, active_shots[array_index].court_x_pos, active_shots[array_index].court_y_pos, active_shots[array_index].trajectory, active_shots[array_index].rotation, active_shots[array_index].left_motor_rpm, active_shots[array_index].right_motor_rpm);
      Serial.println("");
      array_index++;
    }
    active_shot_array_length = array_index;
  }
  else if (strcmp(command, "update_setup_values") == 0)
  {
    int newTrajectoryMin = trajectory_min_limit;
    int newTrajectoryMax = trajectory_max_limit;
    if (doc_rx.containsKey("trajectory_min_limit") || doc_rx.containsKey("trajectory_max_limit"))
    {
      if (!doc_rx.containsKey("trajectory_min_limit") ||
          !doc_rx.containsKey("trajectory_max_limit") ||
          !parseTrajectoryLimit(doc_rx["trajectory_min_limit"], newTrajectoryMin) ||
          !parseTrajectoryLimit(doc_rx["trajectory_max_limit"], newTrajectoryMax))
      {
        sendStatus("invalidPayload", "red");
        return;
      }
      if (newTrajectoryMin >= newTrajectoryMax)
      {
        sendStatus("invalidPayload", "red");
        return;
      }
    }

    // Example JSON
    gripper_open_pos = doc_rx["gripper_open_pos"].as<int>();         // "0"
    gripper_closed_pos = doc_rx["gripper_closed_pos"].as<int>();     // "80"
    pusher_catch_pos = doc_rx["pusher_catch_pos"].as<int>();         // "90"
    pusher_push_pos = doc_rx["pusher_push_pos"].as<int>();           // "35"
    left_rotation_limit = doc_rx["left_rotation_limit"].as<int>();   // "60"
    right_rotation_limit = doc_rx["right_rotation_limit"].as<int>(); // "120"
    trajectory_min_limit = newTrajectoryMin;
    trajectory_max_limit = newTrajectoryMax;
  }
  else if (strcmp(command, "stop") == 0)
  {
    // Example JSON
    printDeviceStatusOnTFT("stopCommandReceived", TFT_TEXT_COLOR);
    stopAll();
  }
  else if (strcmp(command, "setup_gripper_open") == 0)
  {
    // Example JSON {"command":"setup_gripper_open"}
    Serial.println("Gripper Opening");
    sendStatus("openingGripper", "orange");
    servoGripper.write(gripper_open_pos);
  }
  else if (strcmp(command, "setup_gripper_close") == 0)
  {
    // Example JSON {"command":"setup_gripper_close"}
    Serial.println("Gripper Closing");
    sendStatus("closingGripper", "orange");
    servoGripper.write(gripper_closed_pos);
  }
  else if (strcmp(command, "setup_pusher_catch") == 0)
  {
    // Example JSON {"command":"setup_pusher_catch"}
    Serial.println("Moving to Catch Position");
    sendStatus("movingPusherCatch", "orange");
    servoPusher.write(pusher_catch_pos);
  }
  else if (strcmp(command, "setup_pusher_push") == 0)
  {
    // Example JSON {"command":"setup_pusher_push"}
    Serial.println("Moving to Push Position");
    sendStatus("movingPusherPush", "orange");
    servoPusher.write(pusher_push_pos);
  }
  else if (strcmp(command, "setup_left_rotation") == 0)
  {
    // Example JSON {"command":"setup_left_rotation"}
    Serial.println("Turning to left rotation limit " + String(left_rotation_limit));
    sendStatus("turningLeft", "orange");
    servoRotation.write(left_rotation_limit);
  }
  else if (strcmp(command, "setup_right_rotation") == 0)
  {
    // Example JSON {"command":"setup_right_rotation"}
    Serial.println("Turning to right rotation limit " + String(right_rotation_limit));
    sendStatus("turningRight", "orange");
    servoRotation.write(right_rotation_limit);
  }
  else if (strcmp(command, "setup_trajectory_min") == 0)
  {
    Serial.println("Moving trajectory servo down to minimum inclination " + String(trajectory_max_limit));
    sendStatus("movingTrajectoryMin", "orange");
    servoTrajectory.write(trajectory_max_limit);
  }
  else if (strcmp(command, "setup_trajectory_max") == 0)
  {
    Serial.println("Moving trajectory servo up to maximum inclination " + String(trajectory_min_limit));
    sendStatus("movingTrajectoryMax", "orange");
    servoTrajectory.write(trajectory_min_limit);
  }
  else if (strcmp(command, "setup_save_servo") == 0)
  {
    // Example JSON  {"command":"setup_save"}
    Serial.println("Save calibration.");
    sendStatus("savingSettings", "orange");
    preferences.begin("Servo_Settings", false);
    preferences.putInt("gripper_open", gripper_open_pos);
    preferences.putInt("gripper_closed", gripper_closed_pos);
    preferences.putInt("pusher_catch", pusher_catch_pos);
    preferences.putInt("pusher_push", pusher_push_pos);
    preferences.putInt("left_limit", left_rotation_limit);
    preferences.putInt("right_limit", right_rotation_limit);
    preferences.putInt("trajectory_min", trajectory_min_limit);
    preferences.putInt("trajectory_max", trajectory_max_limit);
    preferences.end();
    sendStatus("ready", "green");
  }
  else if (strcmp(command, "setup_esc_max") == 0)
  {
    // Example JSON {"command":"setup_esc_max"}
    Serial.println("Sending max throttle");
    sendStatus("calibrationMaxThrottle", "orange");
    servoLeftESC.writeMicroseconds(escMaxPulseLength);
    servoRightESC.writeMicroseconds(escMaxPulseLength);
  }
  else if (strcmp(command, "setup_esc_min") == 0)
  {
    // Example JSON {"command":"setup_esc_min"}
    Serial.println("Sending min throttle");
    sendStatus("calibrationMinThrottle", "orange");
    servoLeftESC.writeMicroseconds(escMinPulseLength);
    servoRightESC.writeMicroseconds(escMinPulseLength);
  }
  else if (strcmp(command, "setup_rpm_run") == 0)
  {
    // Example JSON {"command":"setup_run","setup_rpm":"500"}
    Serial.println("Calibration Run Motor.");
    sendStatus("continuousRun", "orange");
    int setup_rpm = doc_rx["setup_rpm"].as<int>(); // "50"

    // At lower speeds first start with a higher value to get the motor spinning.
    if (setup_rpm < 2500)
    {
      servoLeftESC.writeMicroseconds(map(3000, rpmLowSetPoint, rpmHighSetPoint, escLowPulseSetPoint, escHighPulseSetPoint));
      servoRightESC.writeMicroseconds(map(3000, rpmLowSetPoint, rpmHighSetPoint, escLowPulseSetPoint, escHighPulseSetPoint));
      delay(100);
    }

    // Run the motor based on the current set points as mapped.
    servoLeftESC.writeMicroseconds(map(setup_rpm, rpmLowSetPoint, rpmHighSetPoint, escLowPulseSetPoint, escHighPulseSetPoint));
    servoRightESC.writeMicroseconds(map(setup_rpm, rpmLowSetPoint, rpmHighSetPoint, escLowPulseSetPoint, escHighPulseSetPoint));
  }
  else if (strcmp(command, "setup_stop") == 0)
  {
    // Example JSON {"command":"setup_stop"}
    Serial.println("Calibration Stop Motor.");
    sendStatus("stopMotor", "orange");
    servoLeftESC.writeMicroseconds(escMinPulseLength);
    servoRightESC.writeMicroseconds(escMinPulseLength);
    sendStatus("ready", "green");
  }
  else if (strcmp(command, "setup_pos") == 0)
  {
    // Example JSON {"command":"setup_pos"}
    Serial.println("Moving to setup pose.");
    sendStatus("setupPose", "orange");

    servoPusher.write(90);
    servoGripper.write(90);
    servoTrajectory.write(constrain(0, trajectory_min_limit, trajectory_max_limit));
    servoRotation.write(90);
  }
  else if (strcmp(command, "setup_high_speed") == 0)
  {
    // Example JSON {"command":"setup_high_speed"}
    Serial.println("Going to high speed.");
    sendStatus("goingHighSpeed", "orange");
    // Go to 5000RPM based on original scaling
    servoLeftESC.writeMicroseconds(map(5000, 0, maxSpeed, escMinPulseLength, escMaxPulseLength));
    servoRightESC.writeMicroseconds(map(5000, 0, maxSpeed, escMinPulseLength, escMaxPulseLength));
  }
  else if (strcmp(command, "setup_low_speed") == 0)
  {
    // Example JSON {"command":"setup_low_speed"}
    Serial.println("Going to low speed.");
    sendStatus("goingLowSpeed", "orange");

    // Get the motors spinning, then after we'll slow to 2500
    servoLeftESC.writeMicroseconds(map(3000, 0, maxSpeed, escMinPulseLength, escMaxPulseLength));
    servoRightESC.writeMicroseconds(map(3000, 0, maxSpeed, escMinPulseLength, escMaxPulseLength));
    delay(100);

    // Go to 2500RPM based on original scaling
    servoLeftESC.writeMicroseconds(map(2500, 0, maxSpeed, escMinPulseLength, escMaxPulseLength));
    servoRightESC.writeMicroseconds(map(2500, 0, maxSpeed, escMinPulseLength, escMaxPulseLength));
  }
  else if (strcmp(command, "setup_adjust_rpm") == 0)
  {
    // Example JSON {"command":"setup_adjust_rpm","setup_rpm_low":"2500","setup_rpm_high":"5000"}
    Serial.println("Adjusting RPM Values");
    sendStatus("adjustingRpm", "orange");

    // Use the pulse values at 2500 & 5000 along with the measured speeds at those pulse lengths to set speed maping during feeding.
    rpmLowSetPoint = doc_rx["setup_rpm_low"].as<int>();   // "2500"
    rpmHighSetPoint = doc_rx["setup_rpm_high"].as<int>(); // "5000"

    // Print out the maping points. Perhaps knowing these we can improve the base values.
    Serial.printf("Low Point - Pulse Width:%i   RPM: %i", escLowPulseSetPoint, rpmLowSetPoint);
    Serial.println("");
    Serial.printf("High Point - Pulse Width:%i   RPM: %i", escHighPulseSetPoint, rpmHighSetPoint);
    Serial.println("");

    // Save
    preferences.begin("Servo_Settings", false);
    preferences.putInt("rpmLowSetPoint", rpmLowSetPoint);
    preferences.putInt("rpmHighSetPoint", rpmHighSetPoint);
    preferences.end();
  }
  else if (strcmp(command, "setup_traj_zero") == 0)
  {
    // Example JSON {"command":"setup_traj_zero","setup_traj_correction":"2"}
    Serial.println("Adjusting Trajectory Zero");
    sendStatus("adjustingTrajectory", "orange");

    traj_correction = doc_rx["setup_traj_correction"].as<float>(); // "0"

    // zero out the servo correction so that it's not affecting itself then find the correction in servo degrees.
    traj_servo_correction = 0;
    traj_servo_correction = getTrajectoryServoPos(traj_correction) - getTrajectoryServoPos(0); // "500"
    Serial.println(traj_servo_correction);
    // Go to the zero position with the correction factored in.
    servoTrajectory.write(getTrajectoryServoPos(0));

    // Save
    preferences.begin("Servo_Settings", false);
    preferences.putFloat("traj_servo_adj", traj_servo_correction);
    preferences.putFloat("traj_correction", traj_correction);
    preferences.end();
  }
  else if (strcmp(command, "setup_update_settings") == 0)
  {
    // Example JSON {"command":"setup_update_settings","shuttle_check":true,"obstacle_check":true}
    Serial.println("updating settings");
    sendStatus("updatingSettings", "orange");
    shuttle_check = doc_rx["shuttle_check"].as<bool>();   // "0"
    obstacle_check = doc_rx["obstacle_check"].as<bool>(); // "0"
    if (!obstacle_check && manual_control_active)
      stopAll();
  }
  else if (strcmp(command, "get_preset") == 0)
  {
    // Example JSON {"command":"get_preset","preset":"Doubles - Service Return"}
    // Selecting a preset on the main page switches the BLE remote trigger back to the
    // default start/stop toggle and stops manual mode.
    remoteManualMode = false;
    if (manual_control_active)
      stopManualControl();
    Serial.println("Request Preset Load.");
    sendStatus("loadingPreset", "orange");
    // sendShots();
  }
  else
  {
    Serial.println("Command not recognized.");
    sendStatus("unknownCommand", "red");
  }
}

// Callback: receiving any WebSocket message
void onWebSocketEvent(uint8_t client_num, WStype_t type, uint8_t *payload, size_t length)
{
  // Figure out the type of WebSocket event
  switch (type)
  {
  // Client has disconnected
  case WStype_DISCONNECTED:
    Serial.printf("[%u] Disconnected!\n", client_num);
    // Manual mode intentionally survives a web client disconnect (e.g. phone lock screen);
    // it only stops when the main page is loaded or a shot pattern is selected.
    break;

  // New client has connected
  case WStype_CONNECTED:
  {
    IPAddress ip = webSocket.remoteIP(client_num);
    Serial.printf("[%u] Connection from ", client_num);
    Serial.println(ip.toString());
    sendLanguage(client_num);
    sendStatus("ready", "green");
    sendParameters();
    sendUserPreset();
    sendRemoteStatus();
  }
  break;

  // Handle messages from client
  case WStype_TEXT:
  {
    // Stop current feeding.
    // stopAll();

    // Print out raw message
    Serial.printf("[%u] Received text: %s\n", client_num, payload);
    handlePayload(reinterpret_cast<const char *>(payload), length);
    Serial.println("");
    break;
  }

  // For everything else: do nothing
  case WStype_BIN:
  case WStype_ERROR:
  case WStype_FRAGMENT_TEXT_START:
  case WStype_FRAGMENT_BIN_START:
  case WStype_FRAGMENT:
  case WStype_FRAGMENT_FIN:
  default:
    break;
  }
}

// Callback: send homepage
void onIndexRequest(AsyncWebServerRequest *request)
{
  IPAddress remote_ip = request->client()->remoteIP();
  Serial.println("[" + remote_ip.toString() +
                 "] HTTP GET request (index) of " + request->url());
  File indexFile = SPIFFS.open("/ace.html", "r");
  if (indexFile)
  {
    Serial.printf("Serving /ace.html (%u bytes), heap free %u, largest block %u\n",
                  (unsigned)indexFile.size(), ESP.getFreeHeap(), ESP.getMaxAllocHeap());
    indexFile.close();
  }
  else
    Serial.println("WARNING: /ace.html not found on SPIFFS - run 'pio run -t uploadfs'");
  // The page is large; survive short RF stalls (e.g. BLE coexistence) instead of letting the
  // default 5 s ack timeout abort the transfer mid-page.
  request->client()->setAckTimeout(20000);
  request->send(SPIFFS, "/ace.html", "text/html");
}

// Callback: send style sheet
void onCSSRequest(AsyncWebServerRequest *request)
{
  IPAddress remote_ip = request->client()->remoteIP();
  Serial.println("[" + remote_ip.toString() +
                 "] HTTP GET request (css) of " + request->url());
  request->send(SPIFFS, "/simple.css", "text/css");
}

void onLocaleRequest(AsyncWebServerRequest *request)
{
  // Also sizeable; keep the transfer alive through short stalls (see onIndexRequest).
  request->client()->setAckTimeout(20000);
  request->send(SPIFFS, "/locales.json", "application/json");
}

// Callback: send logo image
void onLogoRequest(AsyncWebServerRequest *request)
{
  IPAddress remote_ip = request->client()->remoteIP();
  Serial.println("[" + remote_ip.toString() +
                 "] HTTP GET request (image) of " + request->url());
  request->send(SPIFFS, pngFilename, "image/png");
}

// Redirect unknown HTTP requests, including captive-network checks, to the portal.
void onPageNotFound(AsyncWebServerRequest *request)
{
  Serial.println("Captive portal redirect for " + request->url());
  request->redirect("http://" + WiFi.softAPIP().toString() + "/");
}

// Send status update
void sendStatus(const char *status_key, const char *status_color, int seconds)
{
  const char *english_fallback = deviceEnglishText(status_key);
  String jsonString;
  doc_tx.clear();
  JsonObject object = doc_tx.to<JsonObject>();
  object["command"] = "status";
  object["statusKey"] = status_key;
  object["statusFallback"] = english_fallback != nullptr ? english_fallback : status_key;
  object["statusColor"] = status_color;
  if (seconds >= 0)
    object["statusParams"]["seconds"] = seconds;
  serializeJson(doc_tx, jsonString);
  webSocket.broadcastTXT(jsonString);
  uint16_t text_color = TFT_TEXT_COLOR;
  if (strcmp(status_color, "red") == 0)
    text_color = TFT_RED;
  else if (strcmp(status_color, "green") == 0)
    text_color = TFT_GREEN;
  else if (strcmp(status_color, "lightblue") == 0)
    text_color = TFT_DARKCYAN;
  else if (strcmp(status_color, "blue") == 0)
    text_color = TFT_BLUE;
  else if (strcmp(status_color, "orange") == 0)
    text_color = TFT_ORANGE;
  else if (strcmp(status_color, "yellow") == 0)
    text_color = TFT_YELLOW;
  printDeviceStatusOnTFT(status_key, text_color, seconds);
}

void sendStatusText(const String &status_text, const char *status_color)
{
  String jsonString;
  doc_tx.clear();
  JsonObject object = doc_tx.to<JsonObject>();
  object["command"] = "status";
  object["statusText"] = status_text;
  object["statusColor"] = status_color;
  serializeJson(doc_tx, jsonString);
  webSocket.broadcastTXT(jsonString);
  lastDeviceStatusKey = nullptr;
  printStatusOnTFT(status_text.c_str(), strcmp(status_color, "green") == 0 ? TFT_GREEN : TFT_TEXT_COLOR);
}
// Send parameters
void sendParameters()
{
  String jsonString = "";
  JsonObject object = doc_tx.to<JsonObject>();

  object["command"] = "load_setup_values";

  // send servo positions
  object["gripper_open"] = gripper_open_pos;
  object["gripper_closed"] = gripper_closed_pos;
  object["pusher_catch"] = pusher_catch_pos;
  object["pusher_push"] = pusher_push_pos;
  object["left_limit"] = left_rotation_limit;
  object["right_limit"] = right_rotation_limit;
  object["trajectory_min_limit"] = trajectory_min_limit;
  object["trajectory_max_limit"] = trajectory_max_limit;
  object["rmpLowSetPoint"] = rpmLowSetPoint;
  object["rmpHighSetPoint"] = rpmHighSetPoint;
  object["manual_max_rpm"] = constrain(rpmHighSetPoint, 1, maxSpeed);
  object["traj_correction"] = traj_correction;

  // send global values
  Serial.println("Load Globals.");
  preferences.begin("Globals", false);
  object["velocity_correction"] = preferences.getFloat("velocity_adj", 0);
  object["flight_correction"] = preferences.getFloat("flight_adj", 0);
  object["height"] = roundf(preferences.getFloat("launcher_y", 1.5) * 100) / 100;
  preferences.end();

  serializeJson(doc_tx, jsonString);
  Serial.printf("Sending: %s\n", jsonString);
  // webSocket.sendTXT(client_num, msg_buf);
  webSocket.broadcastTXT(jsonString); // send JSON string to all clients
}

// Send Shots
void sendShots()
{
  String jsonString = "";
  JsonObject object = doc_tx.to<JsonObject>();

  object["command"] = "load_shot_values";
  JsonObject Shots = object.createNestedObject("shots");

  for (int i = 0; i < 10; i++)
  {

    JsonObject Shot = Shots.createNestedObject(String(i));
    Shot["x"] = active_shots[i].court_x_pos;
    Shot["y"] = active_shots[i].court_y_pos;
    Shot["trajectory"] = active_shots[i].trajectory;
    Shot["rotation"] = active_shots[i].rotation;
  }

  // object["shots"] = active_shots;
  // myJSON = '["Ford", "BMW", "Fiat"]';

  // JsonArray

  /* FROM RECEIPT OF SHotS
   for (JsonObject settings_shot : doc_rx["shots"].as<JsonArray>()) {
            active_shots[array_index].court_x_pos = settings_shot["x"].as<float>();
            active_shots[array_index].court_y_pos = settings_shot["y"].as<float>();
            active_shots[array_index].trajectory = settings_shot["trajectory"].as<float>();
            active_shots[array_index].rotation = settings_shot["rotation"].as<float>();
            active_shots[array_index].left_motor_rpm = settings_shot["lm_speed"].as<int>();
            active_shots[array_index].right_motor_rpm = settings_shot["rm_speed"].as<int>();*/

  // DynamicJsonDocument doc(1024);
  // JsonObject wifi  = doc.createNestedObject("wifi");
  // wifi["SSID"] = "TheBatCave";

  serializeJson(doc_tx, jsonString);
  Serial.printf("Sending: %s\n", jsonString);
  // webSocket.sendTXT(client_num, msg_buf);
  webSocket.broadcastTXT(jsonString); // send JSON string to all clients
}

void drawMultilineBtnLabel(int x, int y, int w, int h, uint16_t textColor, uint8_t textSizeFactor, uint8_t i, bool invert = false)
{
  uint16_t fontH = tft.fontHeight() * textSizeFactor;
  int startY = y - fontH;
  tft.setTextDatum(TL_DATUM);
  tft.setTextSize(BTN_TEXTSCALING);

  for (int line = 0; line < 2; line++)
  {
    int tw = tft.textWidth(tftMultilineBtnLabel[i][line]);
    if (invert)
    {
      tft.setTextColor(TFT_BKGND_COLOR);
    }
    else
    {
      tft.setTextColor(textColor);
    }
    tft.drawString(tftMultilineBtnLabel[i][line], x - (tw / 2), startY + line * fontH);
  }
}

// Draw the keypad on the TFT display
void drawKeypad()
{
  // Draw the keys
  for (uint8_t row = 0; row < BTN_ROWS; row++)
  {
    for (uint8_t col = 0; col < BTN_COLS; col++)
    {
      uint8_t b = col + row * BTN_COLS;

      if (b < 6)
        tft.setFreeFont(LABEL1_FONT);
      else
        tft.setFreeFont(LABEL2_FONT);

      tftBtnPos[b][0] = BTN_X + col * (BTN_WIDTH + BTN_SPACING_X);
      tftBtnPos[b][1] = BTN_Y + row * (BTN_HEIGHT + BTN_SPACING_Y);

      tftBtn[b].initButton(&tft, tftBtnPos[b][0], tftBtnPos[b][1], // x, y, w, h, outline, fill, text
                           BTN_WIDTH, BTN_HEIGHT, TFT_TEXT_COLOR, tftBtnColor[b], TFT_TEXT_COLOR,
                           (char *)"", BTN_TEXTSCALING);
      tftBtn[b].drawButton();
      drawMultilineBtnLabel(tftBtnPos[b][0], tftBtnPos[b][1], BTN_WIDTH, BTN_HEIGHT, TFT_TEXT_COLOR, BTN_TEXTSCALING, b);
    }
  }
}

// Perform TFT touch screen calibration and store the data in SPIFFS
void touch_calibrate()
{
  uint16_t calData[5];
  uint8_t calDataOK = 0;

  // check if calibration file exists and size is correct
  if (SPIFFS.exists(CALIBRATION_FILE))
  {
    if (REPEAT_CAL)
    {
      // Delete if we want to re-calibrate
      SPIFFS.remove(CALIBRATION_FILE);
    }
    else
    {
      File f = SPIFFS.open(CALIBRATION_FILE, "r");
      if (f)
      {
        if (f.readBytes((char *)calData, 14) == 14)
          calDataOK = 1;
        f.close();
      }
    }
  }

  if (calDataOK && !REPEAT_CAL)
  {
    // calibration data valid
    tft.setTouch(calData);
  }
  else
  {
    tftCalibrationInProgress = true;
    Serial.println(F("Waiting for touch screen calibration!"));
    // data not valid so recalibrate
    tft.fillScreen(TFT_BKGND_COLOR);
    tft.setCursor(50, 200);
    tft.setTextFont(2);
    tft.setTextSize(1);
    tft.setTextColor(TFT_TEXT_COLOR, TFT_BKGND_COLOR);

    tft.println(deviceText("touchCorners"));

    tft.setTextFont(1);
    tft.println();

    if (REPEAT_CAL)
    {
      tft.setTextColor(TFT_RED, TFT_BKGND_COLOR);
      tft.println(deviceText("repeatCalibrationWarning"));
    }

    tft.calibrateTouch(calData, TFT_MAGENTA, TFT_BKGND_COLOR, 15);

    tft.setTextColor(TFT_GREEN, TFT_BKGND_COLOR);
    tft.println(deviceText("calibrationComplete"));

    // store data
    File f = SPIFFS.open(CALIBRATION_FILE, "w");
    if (f)
    {
      f.write((const unsigned char *)calData, 14);
      f.close();
    }
    tftCalibrationInProgress = false;
  }
}

// Print something in the mini status bar of the TFT display
void printStatusOnTFT(const char *msg, uint16_t color)
{
  lastDeviceStatusKey = nullptr;
  lastTftStatusText = tftSafeText(String(msg));
  lastTftStatusColor = color;
  Serial.println("Status message updated: " + lastTftStatusText);
  tft.setFreeFont(LABEL1_FONT);
  tft.setTextSize(1);
  tftStatusTextWidth = tft.textWidth(lastTftStatusText);
  tftStatusScrollOffset = 0;
  tftStatusScrollNext = millis() + TFT_STATUS_SCROLL_PAUSE_MS;
  tft.fillRect(0, STATUS_Y, TFT_WIDTH, tft.fontHeight(), TFT_BKGND_COLOR);
  tft.setTextPadding(STATUS_WIDTH);
  tft.setTextColor(color, TFT_BKGND_COLOR, true);
  // tft.setTextFont(0);
  tft.setTextDatum(TC_DATUM);
  tft.drawString(lastTftStatusText, STATUS_X, STATUS_Y);
}

// Scrolls a status text that is wider than the status bar horizontally through it (marquee).
void updateTftStatusScroll()
{
  if (tftStatusTextWidth <= STATUS_WIDTH)
    return;
  if (static_cast<int32_t>(millis() - tftStatusScrollNext) < 0)
    return;
  tftStatusScrollOffset += TFT_STATUS_SCROLL_STEP_PX;
  if (tftStatusScrollOffset >= tftStatusTextWidth)
  {
    tftStatusScrollOffset = 0;
    tftStatusScrollNext = millis() + TFT_STATUS_SCROLL_PAUSE_MS;
  }
  else
    tftStatusScrollNext = millis() + TFT_STATUS_SCROLL_STEP_MS;
  tft.setFreeFont(LABEL1_FONT);
  tft.setTextSize(1);
  tft.fillRect(0, STATUS_Y, TFT_WIDTH, tft.fontHeight(), TFT_BKGND_COLOR);
  tft.setTextPadding(0);
  tft.setTextColor(lastTftStatusColor, TFT_BKGND_COLOR, true);
  tft.setTextDatum(TL_DATUM);
  tft.drawString(lastTftStatusText, -tftStatusScrollOffset, STATUS_Y);
}

void printDeviceStatusOnTFT(const char *key, uint16_t color, int seconds)
{
  String status_text = deviceText(key);
  if (seconds >= 0)
    status_text.replace("{seconds}", String(seconds));
  printStatusOnTFT(status_text.c_str(), color);
  lastDeviceStatusKey = key;
}

// These are callback functions for handling png decoding callbacks.
// Callback function to draw pixels to the display
int pngDraw(PNGDRAW *pDraw)
{
  uint16_t lineBuffer[TFT_WIDTH]; // Buffer to hold one line of the image
  png->getLineAsRGB565(pDraw, lineBuffer, PNG_RGB565_BIG_ENDIAN, TFT_BKGND_COLOR);
  tft.pushImage(xpos, ypos + pDraw->y, pDraw->iWidth, 1, lineBuffer);
  return 1;
}
void *pngOpen(const char *filename, int32_t *size)
{
  Serial.printf("Attempting to open %s\n", filename);
  pngfile = SPIFFS.open(filename, "r");
  *size = pngfile.size();
  return &pngfile;
}

void pngClose(void *handle)
{
  File pngfile = *((File *)handle);
  if (pngfile)
    pngfile.close();
}

int32_t pngRead(PNGFILE *page, uint8_t *buffer, int32_t length)
{
  if (!pngfile)
    return 0;
  page = page; // Avoid warning
  return pngfile.read(buffer, length);
}

int32_t pngSeek(PNGFILE *page, int32_t position)
{
  if (!pngfile)
    return 0;
  page = page; // Avoid warning
  return pngfile.seek(position);
}

// Open a PNG image and draw it on the TFT display
void drawPNG(int x = 0, int y = 0)
{
  // File file = SPIFFS.open(pngFilename, "r")
  if (SPIFFS.exists(pngFilename))
  {
    xpos = x;
    ypos = y;
    // Pass support callback function names to library
    png = new PNG();
    if (png == nullptr)
    {
      Serial.println("Unable to allocate the PNG decoder");
      return;
    }
    int16_t rc = png->open(pngFilename, pngOpen, pngClose, pngRead, pngSeek, pngDraw);
    if (rc == PNG_SUCCESS)
    {
      tft.startWrite();
      Serial.printf("image specs: (%d x %d), %d bpp, pixel type: %d\n", png->getWidth(), png->getHeight(), png->getBpp(), png->getPixelType());
      if (png->getWidth() > TFT_WIDTH)
        Serial.println("Image too wide for allocated line buffer size!");
      else
      {
        rc = png->decode(NULL, 0);
        png->close();
      }

      tft.endWrite();
    }
    delete png;
    png = nullptr;
  }
}

/***********************************************************
   Main
*/

void updateStatusLed(uint32_t currentTime, bool countdownActive, int countdownValue)
{
  static bool previousObstruction = false;
  static bool previousActiveState = false;
  static bool stopIndicatorActive = false;
  static uint32_t stopIndicatorStarted = 0;
  static uint32_t idleStarted = 0;
  static uint32_t lastUpdate = 0;
  static uint32_t countdownPulseStarted = 0;
  static int lastCountdownValue = -1;

  bool activeState = system_state != ST_IDLE;
  if (sonar_long_blocked && !previousObstruction)
  {
    stopIndicatorActive = true;
    stopIndicatorStarted = currentTime;
  }
  else if (!sonar_long_blocked && previousObstruction)
  {
    stopIndicatorActive = true;
    stopIndicatorStarted = currentTime;
  }
  if (previousActiveState && !activeState)
  {
    stopIndicatorActive = true;
    stopIndicatorStarted = currentTime;
    idleStarted = currentTime;
  }
  else if (activeState && !previousActiveState)
  {
    stopIndicatorActive = false;
  }
  if (idleStarted == 0)
    idleStarted = currentTime;

  previousObstruction = sonar_long_blocked;
  previousActiveState = activeState;

  if (countdownActive)
  {
    if (countdownValue != lastCountdownValue)
    {
      countdownPulseStarted = currentTime;
      lastCountdownValue = countdownValue;
    }
  }
  else
  {
    lastCountdownValue = -1;
  }

  if (currentTime - lastUpdate < 20)
    return;
  lastUpdate = currentTime;

  CRGB color = CRGB::Black;
  if (sonar_long_blocked)
  {
    color = CRGB::Blue;
  }
  else if (stopIndicatorActive && currentTime - stopIndicatorStarted < 2000)
  {
    color = CRGB::Red;
  }
  else if (countdownActive)
  {
    stopIndicatorActive = false;
    uint8_t progress = countdownValue >= 5 ? 0 : countdownValue <= 1 ? 255
                                                                     : (5 - countdownValue) * 64;
    uint8_t hue = scale8(progress, 96);
    uint8_t pulse = currentTime - countdownPulseStarted < 180 ? 255 : 150;
    color = CHSV(hue, 255, pulse);
  }
  else if (activeState)
  {
    stopIndicatorActive = false;
    color = CRGB::Green;
  }
  else if (currentTime - idleStarted >= 2000)
  {
    stopIndicatorActive = false;
    uint8_t breathe = sin8(currentTime >> 3) & 0xFF; // Heartbeat = currentTime / 8 (the lower, the slower) with the result scaled to 0-255 by & 0xFF.
    uint8_t idleBrightness = statusLedIdleMinBrightness +
                             (uint16_t)breathe * (statusLedIdleMaxBrightness - statusLedIdleMinBrightness) / 255;
    color = CRGB(idleBrightness, 0, 0);
  }

  fill_solid(statusLeds, statusLedCount, color);
  FastLED.show();
}
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
void loop()
{
  static int last_time = millis();
  static int last_sonar_time = millis();
  static int last_through_beam_time = millis();
  static int last_state_time = millis();
  static int start_time = millis();
  static int count_down = 5;
  static bool countdown_required = true;

  int current_time = millis();

  static int startStatus = -1;
  static int stopStatus = -1;
  startStatus = digitalRead(startPin);
  // startStatus = analogRead(startPin);
  stopStatus = digitalRead(stopPin);
  // stopStatus = analogRead(stopPin);

  // Serial.print("Button Values (start, stop): ");
  // Serial.print(startStatus);
  // Serial.print(" | ");
  // Serial.println(stopStatus);

  // If the physical start button is pressed then start.
  if (startStatus == 0)
  {
    printDeviceStatusOnTFT("startButtonPressed", TFT_TEXT_COLOR);
    static const char startPayload[] = R"json({
      "command": "start",
      "play_type": "random_shots",
      "shot_pattern": []
    })json";
    handlePayload(startPayload, sizeof(startPayload) - 1);
  }
  // If the physical stop button is pressed then stop.
  if (stopStatus == 0)
  {
    stopAll();
  }

  // Always start by checking the sonar sensor for any obstructions & stop imediately if detected.
  if (current_time - last_sonar_time >= 100)
  {
    int distance = sonar.ping_cm();
    // Serial.print("Distance:" );
    // Serial.print(distance);
    // Serial.println("cm");
    last_sonar_time = current_time;
    // sendStatus("Distance: " + String(distance, 6) + "cm", "red"); //String(distance, 6)

    // Sensor library returns 0 for any distances greater than the max detection window set when initialized.
    // So in this case a value of zero means free from obstructions.
    if (distance > 0)
    {
      // If the sensor is blocked for 4 sonar pings (1s) then stop all.
      if (sonar_blocked_counts >= 4)
      {

        if ((system_state > 0 || manual_control_active) && obstacle_check == true && sonar_long_blocked == false)
        {
          printDeviceStatusOnTFT("obstructionDetected", TFT_RED);
          if (system_state > 0)
            stopAll();
          else
          {
            Serial.printf("Manual obstacle detected at %d cm; stopping motors and shooting, keeping aiming enabled.\n", distance);
            stopManualActuation();
            sendStatus("manualSafetyBlocked", "red");
          }
          sonar_long_blocked = true;
        }
      }
      else
      {
        sonar_blocked_counts++;
      }
    }
    else
    {
      sonar_blocked_counts = 0;
      if (sonar_long_blocked == true)
      {
        sonar_long_blocked = false;
        if (manual_control_active)
          sendStatus("manualActuationReady", "green");
        else
          sendStatus("ready", "green");
      }
    }
  }

  // Update shuttle through-beam status.
  static int throughBeamClear = 0;
  if (current_time - last_through_beam_time >= 50)
  {
    throughBeamClear = digitalRead(throughBeamPin);
    digitalWrite(throughBeamIndicatorPin, throughBeamClear);
    // Serial.print("Beam Clear:");
    // Serial.println(throughBeamClear);
    last_through_beam_time = current_time;
  }

  // Look for and handle WebSocket data
  webSocket.loop();

  processRemoteControl();

  updateManualFeed(current_time);
  updateManualMotorWatchdog();
  updateTftStatusScroll();

  static bool skip_open_delay = false;
  static int shuttle_drop_attempts = 0;
  static int current_shot = 0;

  static int current_shot_delay = 0;
  static int current_lm_speed = 0;
  static int current_rm_speed = 0;
  static float current_trajectory = 0;
  static float current_rotation = 0;

  static float traj_servo_pos = 0;
  static float rot_servo_pos = 0;
  static int last_shot_delay = 0;

  // Do a countdown before starting feeding when first activated to allow player time to get to position.
  if (system_state > 0 && countdown_required == true && system_state != ST_RESET) //
  {
    if (current_time - last_time >= 1000)
    {

      sendStatus("startingIn", "green", count_down);
      last_time = millis();

      if (count_down <= 1)
      {
        countdown_required = false;
      }
      else
        count_down = count_down - 1;
    }
    updateStatusLed(current_time, true, count_down);
    return;
  }

  int open_delay = 500;
  int close_delay = 500;

  //////////////// TFT Keypad ////////////////////
  // drawPNG(xpos, ypos);
  // tft.fillRect(0, 110, TFT_WIDTH, TFT_HEIGHT, TFT_DARKGREY);
  // drawKeypad();
  uint16_t t_x = 0, t_y = 0; // To store the touch coordinates
  bool pressed = tft.getTouch(&t_x, &t_y);
  if (pressed)
  {
    // / Check if any key coordinate boxes contain the touch coordinates
    for (uint8_t b = 0; b < BTN_COUNT; b++)
    {
      if (tftBtn[b].contains(t_x, t_y))
        tftBtn[b].press(true); // tell the button it is pressed
      else
        tftBtn[b].press(false); // tell the button it is NOT pressed
    }

    // Check if any tftBtn has changed state
    for (uint8_t b = 0; b < BTN_COUNT; b++)
    {

      if (b < 6)
        tft.setFreeFont(LABEL1_FONT);
      else
        tft.setFreeFont(LABEL2_FONT);

      if (tftBtn[b].justReleased())
      {
        tftBtn[b].drawButton(); // draw normal
        drawMultilineBtnLabel(tftBtnPos[b][0], tftBtnPos[b][1], BTN_WIDTH, BTN_HEIGHT, TFT_TEXT_COLOR, BTN_TEXTSCALING, b);
      }

      if (tftBtn[b].justPressed())
      {
        // Any TFT button press switches the BLE remote trigger back to the default
        // start/stop toggle and stops manual mode (a pattern is being selected).
        remoteManualMode = false;
        if (manual_control_active)
          stopManualControl();
        tftBtn[b].drawButton(true); // draw inverted
        drawMultilineBtnLabel(tftBtnPos[b][0], tftBtnPos[b][1], BTN_WIDTH, BTN_HEIGHT, TFT_TEXT_COLOR, BTN_TEXTSCALING, b, true);
        switch (b)
        {
        case 0:
        {
          sendStatus("singlesLeftService", "lightblue");
          handlePayload(SinglesLHServicePreset, strlen(SinglesLHServicePreset));
          break;
        }
        case 1:
          sendStatus("doublesLeftService", "blue");
          handlePayload(DoublesLHServicePreset, strlen(DoublesLHServicePreset));
          break;
        case 2:
        {
          sendStatus("singlesRightService", "lightblue");
          handlePayload(SinglesRHServicePreset, strlen(SinglesRHServicePreset));
          break;
        }
        case 3:
          sendStatus("doublesRightService", "blue");
          handlePayload(DoublesRHServicePreset, strlen(DoublesRHServicePreset));
          break;
        case 4:
          sendStatus("singlesFullCourt", "lightblue");
          handlePayload(SinglesFullCourtPreset, strlen(SinglesFullCourtPreset));
          break;
        case 5:
          sendStatus("doublesFullCourt", "blue");
          handlePayload(DoublesFullCourtPreset, strlen(DoublesFullCourtPreset));
          break;
        case 6:
          loadAndStartUserPreset();
          break;
        case 7:
          sendStatus("doublesNoRotation", "blue");
          handlePayload(DoublesNoRotationPreset, strlen(DoublesNoRotationPreset));
          break;
        }
      }
    }
  }

  //////////////// TFT Keypad ////////////////////

  switch (system_state)
  {
  case ST_IDLE:
    last_state_time = current_time;
    countdown_required = true;
    count_down = 5;
    current_sequence_index = 0;

    break;
  case ST_START:
    skip_open_delay = false;
    shuttle_drop_attempts = 0;
    stop_launcher = false;
    servoPusher.write(pusher_catch_pos);

    // If a countdown is required do not add additional delay before the shot.
    if (countdown_required == true)
      last_shot_delay = 0;

    // If a countdown is not required, or if we've counted down to 2s remaining (feed prep length)
    if (countdown_required == false || current_time - last_state_time > (5000 - 2000))
    {
      Serial.print("Starting");

      if (ACTIVE_PLAY_TYPE == RANDOM_SHOTS)
      {
        current_shot = random(0, active_shot_array_length); // lower bound inclusive, upper bound exclusive.
        current_shot_delay = (int)(default_delay * 1000);   // This should be based on the default shot delay.
      }
      if (ACTIVE_PLAY_TYPE == RANDOM_ORDER)
      {
        current_sequence_index = random(0, sequence_length); // lower bound inclusive, upper bound exclusive.
        current_shot = shot_sequence[current_sequence_index].ID;
        current_shot_delay = (int)(shot_sequence[current_sequence_index].delay * 1000);
      }
      if (ACTIVE_PLAY_TYPE == PLAY_ONCE || ACTIVE_PLAY_TYPE == REPEAT_SHOTS)
      {
        current_shot = shot_sequence[current_sequence_index].ID;
        current_shot_delay = (int)(shot_sequence[current_sequence_index].delay * 1000);
      }
      // Subtract the delay built into the shot sequence. Approximately 2 second delay plus the time it takes to push into the feeders.
      // current_shot_delay -= 2100;
      // current_shot_delay = max(0,current_shot_delay);

      current_trajectory = active_shots[current_shot].trajectory;
      current_rotation = active_shots[current_shot].rotation;
      current_lm_speed = active_shots[current_shot].left_motor_rpm;
      current_rm_speed = active_shots[current_shot].right_motor_rpm;

      // Serial.printf("shot index:%i   x: %f   y: %f   traj: %f   rot: %f   lm: %i   rm: %i" ,current_shot,active_shots[current_shot].court_x_pos,active_shots[current_shot].court_y_pos,active_shots[current_shot].trajectory,active_shots[current_shot].rotation,active_shots[current_shot].left_motor_rpm,active_shots[current_shot].right_motor_rpm);
      // Serial.println("");

      last_state_time = current_time;
      start_time = current_time;
      system_state = ST_GRIPPER_OPEN;
    }
    break;
  case ST_GRIPPER_OPEN:
    if (current_time - last_state_time >= 500 || skip_open_delay)
    {
      Serial.print(" -> Gripper Opening");
      servoGripper.write(gripper_open_pos);
      skip_open_delay = false;
      shuttle_drop_attempts++;
      last_state_time = current_time;
      system_state = ST_GRIPPER_CLOSED;
    }
    break;
  case ST_GRIPPER_CLOSED:
    if (current_time - last_state_time >= 500)
    {
      Serial.print(" -> Gripper Closing");
      servoGripper.write(gripper_closed_pos);
      last_state_time = current_time;
      system_state = ST_SHUTTLE_CHECK;
    }
    break;
  case ST_SHUTTLE_CHECK:
    Serial.print(" -> Shuttle Check");
    if (throughBeamClear == true && shuttle_check == true) // If the through beam sensor is not blocked and shuttle checking is enabled the either try again or stop.
    {
      // If there is no shuttle loaded try cycling the gripper.
      if (shuttle_drop_attempts < 2)
      {
        skip_open_delay = true;
        system_state = ST_GRIPPER_OPEN;
        // current_shot_delay -= 500; //Subtract the extra time to open the gripper from the current requested shot delay.
        // current_shot_delay = max(0,current_shot_delay);
      }
      else
      {
        sendStatus("shuttleFeedFailure", "red");
        stop_launcher = true;
        system_state = ST_RESET;
      }
    }
    else
    {
      system_state = ST_PREP_LAUNCH;
    }
    last_state_time = current_time;
    break;
  case ST_PREP_LAUNCH:
    if (current_time - last_state_time >= 500 && current_time - start_time >= last_shot_delay - 1000) // wait at least 500ms, but if the delay is longer wait until 500ms before the shot.
    {
      Serial.print(" -> Launch Prep");
      sendStatus("feeding", "green");
      // Move to the desired position & start the motors.
      // Serial.printf("Feed Shuttle   LM: %i   RM: %i   Trajectory: %f   Rotation: %f", current_lm_speed, current_rm_speed, current_trajectory, current_rotation);
      // Serial.println("");

      // At lower speeds first start with a higher value to get the motor spinning.
      if (current_lm_speed < 2500 || current_rm_speed < 2500)
      {
        servoLeftESC.writeMicroseconds(map(3000, rpmLowSetPoint, rpmHighSetPoint, escLowPulseSetPoint, escHighPulseSetPoint));
        servoRightESC.writeMicroseconds(map(3000, rpmLowSetPoint, rpmHighSetPoint, escLowPulseSetPoint, escHighPulseSetPoint));
        delay(100);
      }

      servoLeftESC.writeMicroseconds(map(current_lm_speed, rpmLowSetPoint, rpmHighSetPoint, escLowPulseSetPoint, escHighPulseSetPoint));
      servoRightESC.writeMicroseconds(map(current_rm_speed, rpmLowSetPoint, rpmHighSetPoint, escLowPulseSetPoint, escHighPulseSetPoint));
      traj_servo_pos = getTrajectoryServoPos(current_trajectory);
      rot_servo_pos = getRotationServoPos(current_rotation);

      // Serial.printf("Trajectory Servo: %f   Rotation Servo: %f", traj_servo_pos,rot_servo_pos);
      // Serial.println("");
      servoTrajectory.write(traj_servo_pos);
      servoRotation.write(rot_servo_pos);
      last_state_time = current_time;
      system_state = ST_LAUNCH;
    }
    break;
  case ST_LAUNCH:
    if (current_time - last_state_time >= 1000 && current_time - start_time >= last_shot_delay) // Minimum of 500 to allow motors to reach speed.
    {
      Serial.print(" -> Launching");
      servoPusher.write(pusher_push_pos);
      last_state_time = current_time;
      system_state = ST_RESET;
    }
    break;
  case ST_RESET:

    if (current_time - last_state_time >= 1000)
    {
      Serial.print(" -> Resetting");
      Serial.printf(" | Details | index:%i   x: %f   y: %f   traj: %f   traj_servo: %f   rot: %f   rot_servo: %f   lm: %i   rm: %i", current_shot, active_shots[current_shot].court_x_pos, active_shots[current_shot].court_y_pos, active_shots[current_shot].trajectory, traj_servo_pos, active_shots[current_shot].rotation, rot_servo_pos, active_shots[current_shot].left_motor_rpm, active_shots[current_shot].right_motor_rpm);
      Serial.println("");
      servoLeftESC.writeMicroseconds(escMinPulseLength);
      servoRightESC.writeMicroseconds(escMinPulseLength);
      servoPusher.write(pusher_catch_pos);
      servoGripper.write(gripper_closed_pos);

      last_state_time = current_time;

      // Store the delay attached to the current shot to time the next shot.
      last_shot_delay = current_shot_delay;

      if (stop_launcher == true)
      {
        sendStatus("stopping", "orange");
        system_state = ST_IDLE;
      }
      else
      {
        // plan to start the next shot
        system_state = ST_START;
        current_sequence_index = current_sequence_index + 1;

        if (current_sequence_index >= sequence_length)
        {
          current_sequence_index = 0;
          // If the pattern is only to be played once then stop.
          if (ACTIVE_PLAY_TYPE == PLAY_ONCE)
          {
            sendStatus("stopping", "orange");
            system_state = ST_IDLE;
          }
        }
      }
    }
    break;
  }

  updateStatusLed(current_time, false, count_down);
}

// Prevent any further shuttle feeds being initialized then stop the esc's.
void stopAll()
{
  // Serial.println("Stop All");
  sendStatus("stopping", "orange");
  if (manual_control_active)
    stopManualControl();
  stop_launcher = true;
  if (system_state != ST_RESET && system_state != ST_IDLE)
  {
    system_state = ST_RESET;
  }
}

// Get the required wheel speeds for a given court position
void getWheelSpeeds(float rotation, float x, float y, float v0, float &leftWheelRPM, float &rightWheelRPM)
{
  float launcherX = 0;
  float launcherY = -2;
  float requiredRotation = atan((x - launcherX) / (y - launcherY)) / PI * 180; // In degrees
  // float shotFinalRotation = parseFloat(shots[i].rotation)+ min(max(requiredRotation-shots[i].rotation,-maxWheelCorrection),maxWheelCorrection);
  float wheelImpartAngle = requiredRotation - rotation; // In degrees
  float wheelRadius = 104 / 1000 / 2;                   // In m

  // float wheelCenterToCenter = 125;
  // float shuttleRadius = 26.5/1000/2; //25-28mm diameter
  float releaseAngle = 16.7; // Solved graphically.

  releaseAngle = releaseAngle / 180 * PI;         // Convert to radians
  wheelImpartAngle = wheelImpartAngle / 180 * PI; // Convert to radians

  // When we consider the shuttle center we must consider that a speed mismatch results in a rolling situation.
  // This gives the expected result at matched speeds as equal roller speeds will have the shuttle traveling at almost the wheel velocity.
  // float velYComponent = v1*cos(releaseAngle)/2 + v2*cos(releaseAngle)/2 //Component going directly away from the launcher.
  // float velXComponent = v1*sin(releaseAngle)/2 - v2*sin(releaseAngle)/2 //Component going awway from the launcher center-line.
  // float angle = atan(velXComponent/velYComponent);

  // Rearange
  // float velYComponent*2/cos(releaseAngle) = v1 + v2 //Component going directly away from the launcher.
  // float velXComponent*2/sin(releaseAngle) = v1 - v2 //Component going awway from the launcher center-line.

  // Rearange & Substitute
  // v1 = velYComponent*2/cos(releaseAngle) - v2
  // v2 =  v1 - velXComponent*2/sin(releaseAngle)
  // Substitute
  // v1 = velYComponent*2/cos(releaseAngle)  + velXComponent*2/sin(releaseAngle)
  // v1 = (velYComponent*2/cos(releaseAngle)  + velXComponent*2/sin(releaseAngle))/2

  // The velYComponent component must be V0 to achieve the required shuttle distance.
  float velYComponent = v0;
  float velXComponent = tan(wheelImpartAngle) * v0;
  float v1 = (velYComponent * 2 / cos(releaseAngle) + velXComponent * 2 / sin(releaseAngle)) / 2;
  float v2 = v1 - velXComponent * 2 / sin(releaseAngle);

  // This will update the variables passed to the function.
  rightWheelRPM = v1 / wheelRadius / (2 * PI) * 60;
  leftWheelRPM = v2 / wheelRadius / (2 * PI) * 60;
}

// Get the required servo angle to set the motor mount plate at the desired trajectory angle.
int getTrajectoryServoPos(float inputAngle)
{
  // Angle limits based on linkage and geometry.
  if (inputAngle < -4)
    inputAngle = -4;
  if (inputAngle > 40)
    inputAngle = 40;
  // Serial.printf("Trajectory Input: %f", inputAngle);
  // Serial.println("");

  float pivotLinkDistance = 20; // Distance from motor plate pivot to driving linkage pin.
  float pivotLinkAngle = -11.5; // Angle between motor plate horizontal and line between pivot and linkage pin. D3 was -14.5.
  float linkLength = 51;        // D3 was 45
  float servoPosX = 54;         // D3 was 43
  float servoPosY = 25;         // D3 was 30
  float servoHornLength = 7.2;  // D3 was 7.5

  float effectiveAngle = radians(pivotLinkAngle - inputAngle);
  float x1 = pivotLinkDistance * cos(effectiveAngle);
  float y1 = pivotLinkDistance * sin(effectiveAngle);
  float c = sqrt(pow(servoPosX - x1, 2) + pow(servoPosY - y1, 2)); // the distance between the motor mount linkage pin to the servo center.
  float beta = atan((servoPosX - x1) / (servoPosY - y1));          // The angle between vertical and the line C
  float alpha = acos((pow(linkLength, 2) - pow(c, 2) - pow(servoHornLength, 2)) / (-2 * c * servoHornLength));
  // float servoAngle = PI - (alpha + beta); //Servo zero is top dead center.
  float servoAngle = PI / 4 - beta + alpha; // Servo zero is 45 degrees off of vertical pointing towards the front. Approx. in line with linkage.
  // Serial.printf("x1: %f   y1: %f   c: %f   beta: %f   alpha: %f   servoAngle: %f   ", x1, y1, c, beta, alpha, servoAngle);
  // Serial.println("");
  servoAngle = degrees(servoAngle); // convert to degrees

  servoAngle += traj_servo_correction;

  // Set hard limits based on servo values.
  servoAngle = constrain(servoAngle, trajectory_min_limit, trajectory_max_limit);
  if (isnan(servoAngle))
    servoAngle = 0;
  // Serial.printf("Trajectory Servo: %f", servoAngle);
  // Serial.println("");
  return servoAngle;
}

// Get the required servo angle to set the chute at the desired rotation angle.
int getRotationServoPos(float inputAngle)
{

  // Angle limits based on linkage and geometry.
  if (inputAngle < -19)
    inputAngle = -19.000;
  if (inputAngle > 19)
    inputAngle = 19.000;
  // Serial.println("");
  // Serial.print(F("Rotation angle: requested "));
  // Serial.print(inputAngle);
  // Serial.print(F("°"));

  inputAngle = radians(inputAngle);                                  // calculate angle in radians
  float a1 = 73.345;                                                 // Chute rotation center to servo center
  float a2 = 24.000;                                                 // Servo horn arm controlling rotation
  float servoAngle = inputAngle - asin((a1 * sin(inputAngle)) / a2); // calculate servo angle in radians
  servoAngle = 90 + degrees(servoAngle);                             // convert to degrees
  // Serial.print(F(" | calculated "));
  // Serial.print(servoAngle);
  // Serial.print(F("°"));

  // Set hard limits based on servo values.
  if (servoAngle < right_rotation_limit)
    servoAngle = right_rotation_limit;
  if (servoAngle > left_rotation_limit)
    servoAngle = left_rotation_limit;
  if (isnan(servoAngle))
    servoAngle = 0;
  // Serial.print(F(" | limited "));
  // Serial.print(servoAngle);
  // Serial.println("°");

  return servoAngle;
}
