paulcombuse/BadmintonAce/(commit log)

2026-11-03 Move project from Arduino IDE to PlatformIO
2026-11-03 Add updated CAD files with Touch TFT, battery indicator and alternate puller concept
2026-11-03 Add folder for printed circuit board (PCB) design with design rules and XT60 male and female connectors
2026-11-03 Update comments regarding pin utilization
2026-11-03 Added first implementation of a localization to switch UI language
2026-11-05 Rework gripper linkage to clip style
2026-11-05 Reduce play of gripper bushings to 1 mm
2026-11-05 Finalize first version of illuminized Tube Base
2026-11-05 Insert grooves for illumination wiring in Top Cover
2026-11-08 Added FastLED library and prepared utilization of status LEDs
2026-11-08 Updated Tube Base and Top Cover to securely connect status LED
2026-11-08 Added PCB Gerber files for ServeMaster board
2026-11-08 Extend readme with first assembly instructions
2026-11-08 Add PCB wiring diagram
2026-11-08 Move XT60 connectors to subfolder
2026-11-08 Update concept comparison with pictures and corrected TubeBase+Insert
2026-11-08 Add close-ups for clarifying servo horn type and orientation
2026-11-08 Add BT remote in shopping and add link to Gerber files in readme
2026-11-08 Update power supply information
2026-11-09 Change manual control joystick area to rectangular to reach all positions. Fix width of TFT status line and show info message during TFT calibration.
2026-11-10 Added adjustment of upper and lower limit for tracejctory inclination position to setup and implementd a captive portal feature for WLAN
2026-11-12 Switch to BLE fully and utilize NimBLE library for that to save ressources
