paulcombuse/BadmintonAce/documentation/img/IMG_20261103_002941.jpg

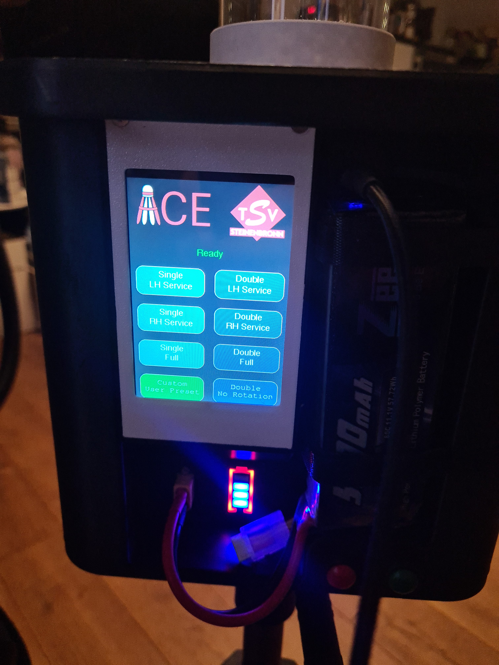
documentation/img/IMG_20261103_002941.jpg
